mferreiracosta/tcc_cefet/TCC 1/Referências Bibliográficas/Características Componentes Eletrônicos/IMU6050.PNG

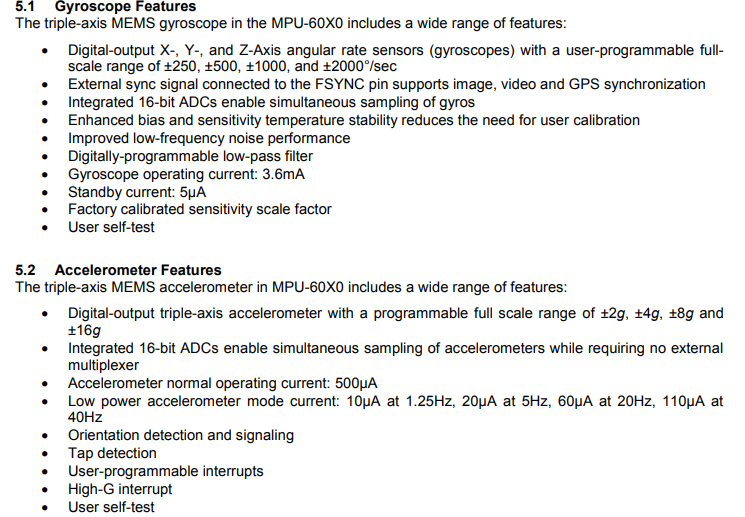
TCC 1/Referências Bibliográficas/Características Componentes Eletrônicos/IMU6050.PNG
