mferreiracosta/tcc_cefet/TCC 1/Referências Bibliográficas/Características Componentes Eletrônicos/Esquema_FiltroComplementar.jpg

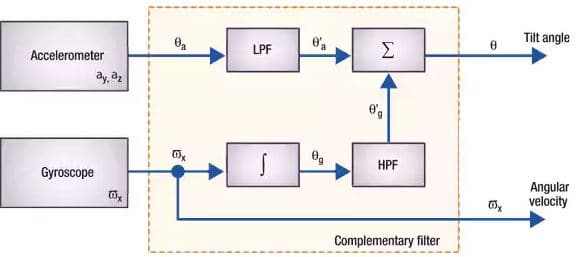
TCC 1/Referências Bibliográficas/Características Componentes Eletrônicos/Esquema_FiltroComplementar.jpg
