mferreiracosta/tcc_cefet/README.md

# Bem-vindo
 Repositório para arquivos do trabalho de conclusão de curso de Engenharia Mecatrônica pelo CEFET-MG.
