mferreiracosta/tcc_cefet/TCC 1/Slides de Apresentação.pdf

# Construção e controle de um sistema do tipo pêndulo invertido sobre duas rodas

Matheus Ferreira Costa

Orientador: Prof. Dr. Luís Filipe Pereira Silva Coorientador: Prof. Me. Juliano de Barros Veloso e Lima

Centro Federal de Educação Tecnológica de Minas Gerais campus Divinópolis
Graduação em Engenharia Mecatrônica

25 de Junho de 2019

Sumário

## Sumário

1 | Introdução
2 | Fundamentação Teórica
3 | Recursos Utilizados
4 | Controlador LQG
5 | Considerações Finais
6 | Referências Bibliográficas

Introdução

## Motivação

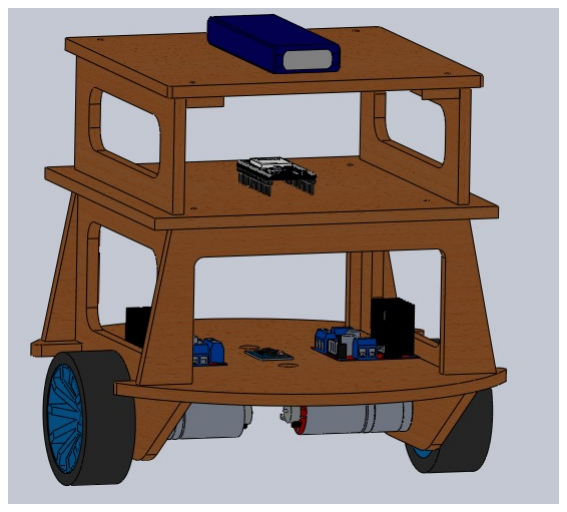
[picture p3: figure]

Figura: Estrutura modelada no SolidWorks.

Introdução

## Objetivos

Construir um sistema do tipo pêndulo invertido sobre duas rodas e controlar o mesmo para que fique em torno de 0◦ utilizando técnica de controle moderno.

Realizar o desenho do protótipo
Obter o modelo não linear contínuo do sistema Linearizar o modelo e realizar a discretização Projetar o controlador LQG
Analisar o desempenho do controlador Construção do protótipo
Implementação do controlador na planta física

Introdução

## Estado da Arte

Sistema de Controle de Pêndulo Invertido (PEDROSO; MODESTO, 2017)
Identificação e Controle de um Veículo Segway para fins Educacionais (MELO,2017)
Embedded LQR controller design for self-balancing robot (ENGIN, 2018)

Fundamentação Teórica

## Modelagem do Sistema

Modelagem newtoniana: F = mxÜ

Subsistema elétrico (PAULA, 2014)

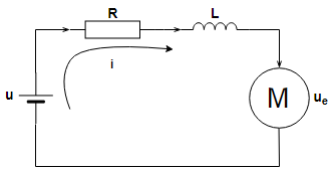
[picture p4: figure]

Figura: Representação elétrica dos motores.

T1 =

Km
R

u −

KeKm
R

(αÛw − θÛ
b)

Fundamentação Teórica

## Modelagem do Sistema

Equação de movimento das rodas (BONAFILIA et al, 2013)

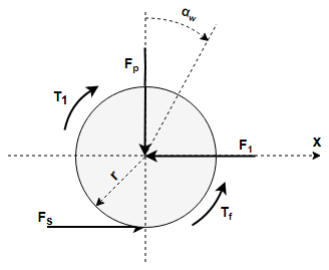
[picture p5: figure]

Figura: Diagrama corpo livre da roda.

F1 = −

Mw +

Jw
r

2

xÜw −
K
r

2R

xÛw +
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
Fundamentação Teórica

## Modelagem do Sistema

Equação de movimento da estrutura (BONAFILIA et al, 2013)

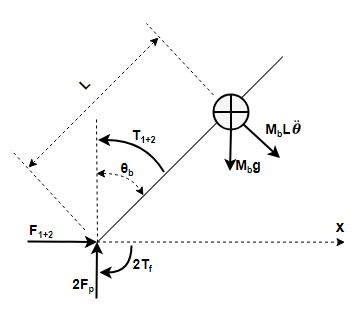
[picture p6: figure]

Figura: Diagrama corpo livre do chassi.

Fundamentação Teórica

## Modelagem do Sistema

EDO em relação a aceleração linear (xÜ)
2

Jw
r

2

+ 2Mw + Mb

xÜ = 2
b
r

2

−

K
r

2R

xÛ − (MbL cos(θ))θÜ

+ 2

K
rR

−

b
r
θÛ + 2

Km
rR

u

EDO em relação a aceleração angular (θÜ)

(Jb + MbL

2

)θÜ = −MbL cos (θ)xÜ + 2

K
rR

−

b
r
xÛ + 2
b −

K
R
θÛ

+ MbgL sin (θ) − 2

Km
R

u

Fundamentação Teórica

## Controlador Linear Gaussiano Quadrático (LQG)

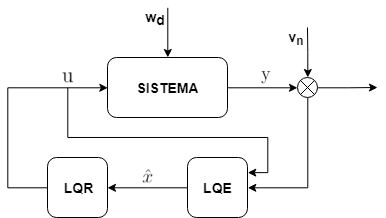
[picture p7: figure]

Figura: Estrutura de um controlador LQG (BRUNTON et al, 2017).

Fundamentação Teórica

## Controlador Linear Gaussiano Quadrático (LQG)

Regulador Linear Quadrático (LQR)
I Minimizar a função custo

J =

1
2

k

Õf−1

k=0

{x

T
k Qxk + u

T
k Ruk }

I Ganho ótimo K = (R + B
T
d PBd )

−1B
T
d PAd
I | Solução da equação de Riccati
| Pk+1 = Q + A TPkAd − A

T
d PkBd (R + B

T
d PkBd )

−1B
T
d PkAd

I Matlab [K, P, E] = dlqr(Ad, Bd, Q, R)

Fundamentação Teórica

## Controlador Linear Gaussiano Quadrático (LQG)

Estimador Linear Quadrático (LQE) / Filtro de Kalman

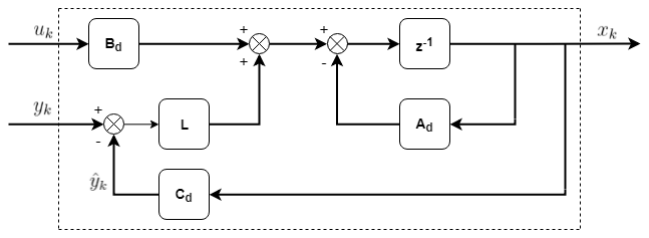
[picture p8: figure]

Figura: Estrutura do estimador LQE (BRUNTON et al, 2017).

Matlab
[L, S, Zd, Ed ] = dlqe(Ad, Qo, C, Qo, Ro);

Recursos Utilizados

## Softwares

SolidWorks
MATLAB
I Simulink

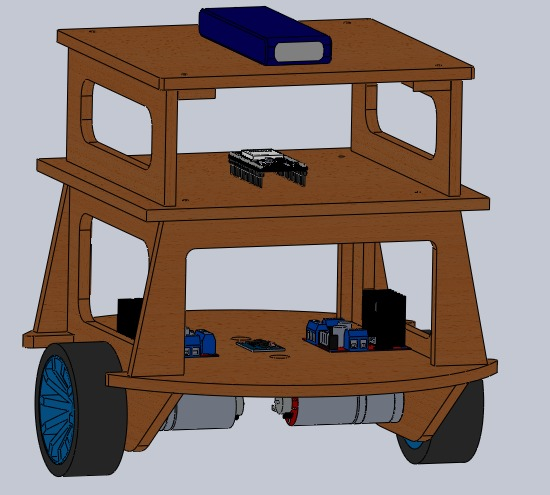
[picture p9: figure]

Figura: Estrutura modelada utilizando o SolidWorks.

Recursos Utilizados

## Motor CC

Características necessárias
I | Tensão: < 12V
I | Torque: 0.2446 Nm (15◦ )
Características do motor (datasheet)
I | Tensão de operação: 6 Vcc
I | Máx. eficiência: 0.196 Nm/0.60 A
I | Máx. torque: 0.51 Nm/1.10 A
I | Encoder integrado

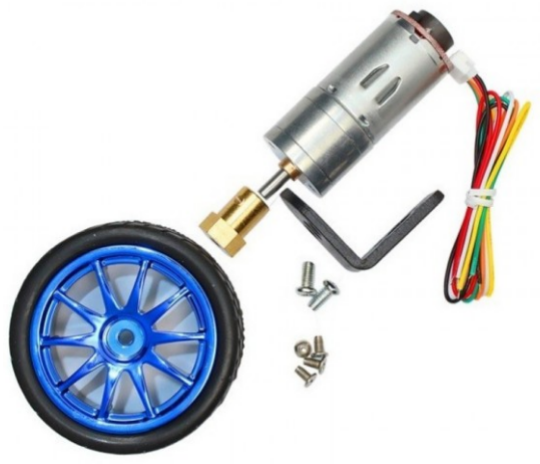
[picture p10: figure]

Figura: Conjunto completo do atuador: motor, acoplador e roda.

Recursos Utilizados

## Driver Motor CC

Características (datasheet)
I | Tensão: 4∼35 Vcc;
I | Corrente máx.: 2A p/canal ou 4A
| máx;
I | Tensão lógica: 5 V;
I | Corrente lógica: 0∼36 mA;

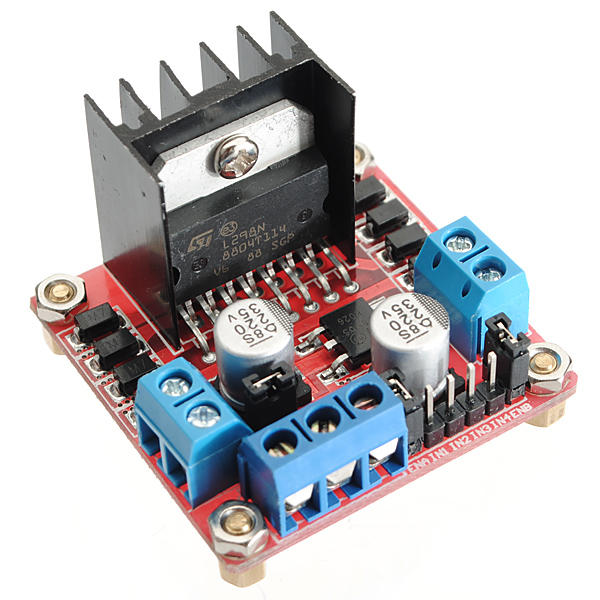
[picture p11: figure]

Figura: Ponte H L298N.

Recursos Utilizados

## Sensor de Orientação

Características necessárias
I | Tensão: 5Vcc
I | Resolução conversão alta
I | Tempo de acomodação menor
| possível
Características da placa (datasheet)
I | Tensão de operação: 3∼5 Vcc
I | Resolução: 16 bits
I | Tempo de acomodação: 1∼10 ms
| (máx.)

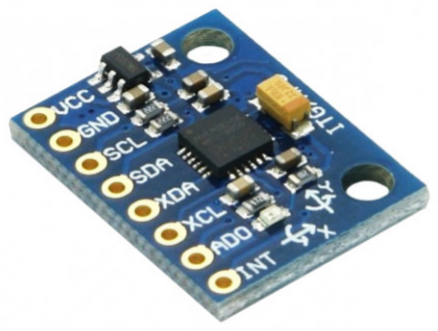
[picture p12: figure]

Figura: Shield MPU6050.

Recursos Utilizados

## Microcontrolador ESP32

Características necessárias
I | Baixo custo
I | Elevada velocidade de
| processamento
I | GPIOs correspondentes ao projeto
Características da placa (datasheet)
I | Tensão de operação: 3.3 Vcc
I | Microprocessador dual core 32-bit
I | Memória SRAM: 512 KB
I | Clock: 80MHz até 240MHz
I | Wi-Fi e Bluetooth embutido
I | GPIO: 36

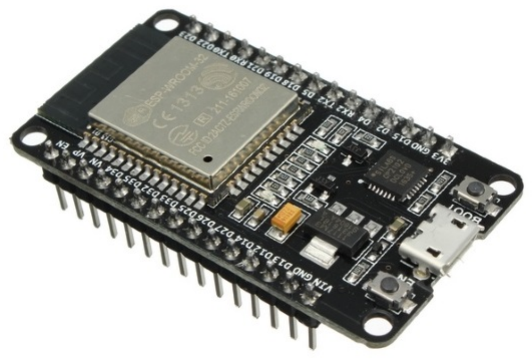
[picture p13: figure]

Figura: Microcontrolador ESP32.

Recursos Utilizados

## Bateria LiPO

Características necessárias
I | Tempo de operação: ∼ 1 hora
I | Capacidade de fornecimento de
| energia
Características via datasheet
I | Tensão de carga: 3 células / 11.1 Vcc
I | Carga Elétrica: 2200 mAh
I | Taxa de Descarga: 20-30 C
I | Massa: 180g

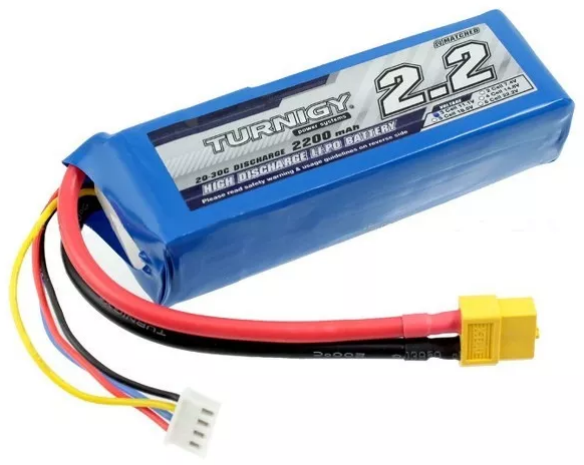
[picture p14: figure]

Figura: Bateria LiPO Turnigy 2200 mAh 3s.

Controlador LQG

## Modelo Linear Discreto

Estados
x1 = x x3 = θ
x2 = x x Û 4 = θÛ

Matrizes do Espaço de Estados I Período de Amostragem: 15 ms

Ad =

0.9918 −0.1503 0.0015
0.0007 | 1.0020 | 0.0148
0.0895 | 0.2694 | 0.9730

Bd =

0.0255
−0.0021
−0.2777

C =

0 1 0
D = 0

Controlador LQG

## LQR

Matrizes de ponderação Q e R → J =

1
2

Í
(x

T
k Qxk + u

T
k

Ruk )

Q =

1 0 0
0 1 0
0 0 1

R = 1

Implementação do controlador

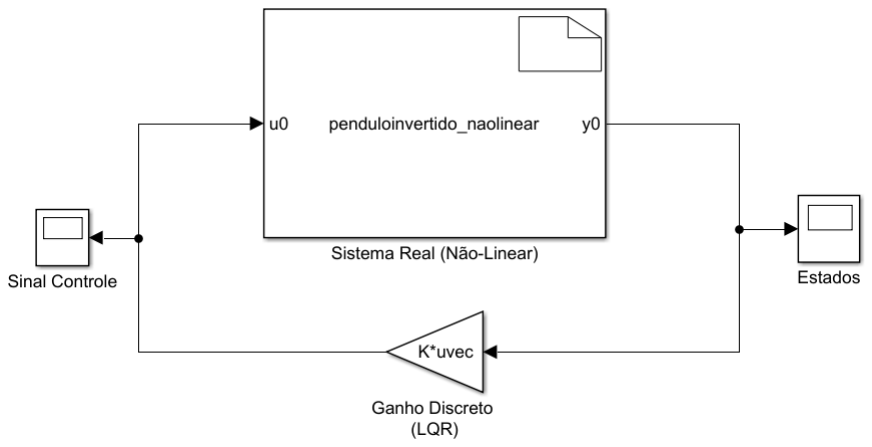
[picture p15: figure]

Figura: Implementação do controlador LQR.

Controlador LQG

## Resultados utilizando o LQR

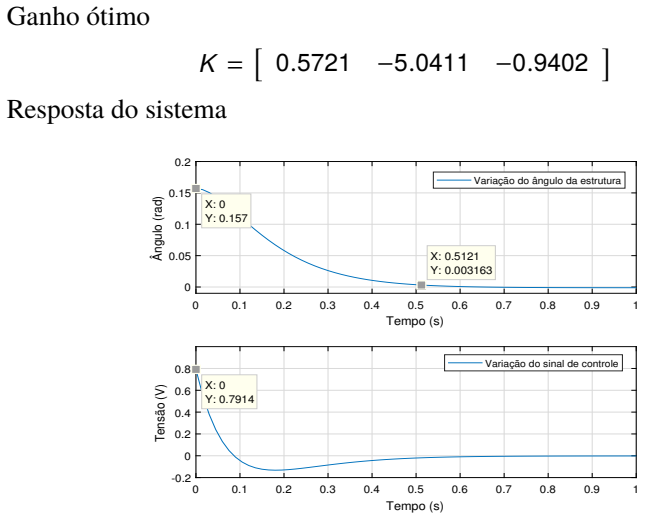
[picture p16: figure]
Ganho ótimo; Resposta do sistema; Tempo (s); Ângulo (rad); Variação do ângulo da estrutura; Tensão (V); Variação do sinal de controle

Figura: Variação do ângulo da estrutura com o controlador LQR. | 21 / 28

Controlador LQG

## LQG

Matrizes de ponderação

Qo = 0.1Inxn Ro = 1

Implementação do controlador LQG

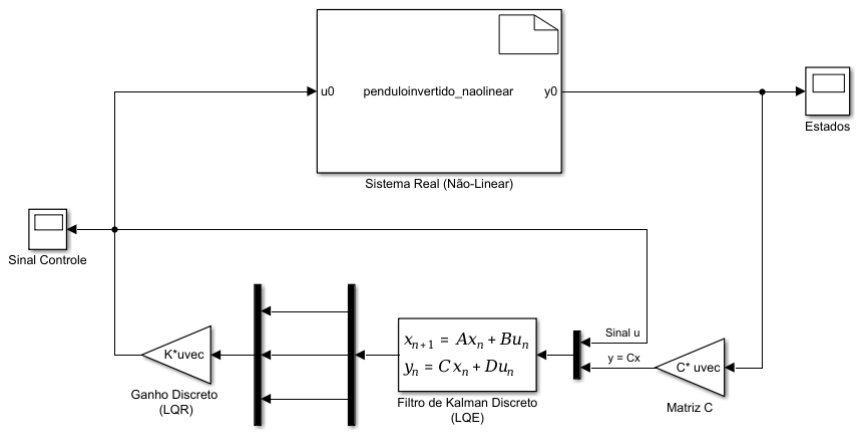
[picture p17: figure]

Figura: Implementação do controlador LQG.

Controlador LQG

## LQG

Ganho ótimo do estimador

L =

0.5721
−5.0411
−0.9402

Matrizes do LQE (BRUNTON et al, 2017)

Af =

Ad − LCd
Bf =
Bd L

Cf =

1 0 0
0 1 0
0 0 1

Df = 0

Bd L

## Resultados utilizando o LQG

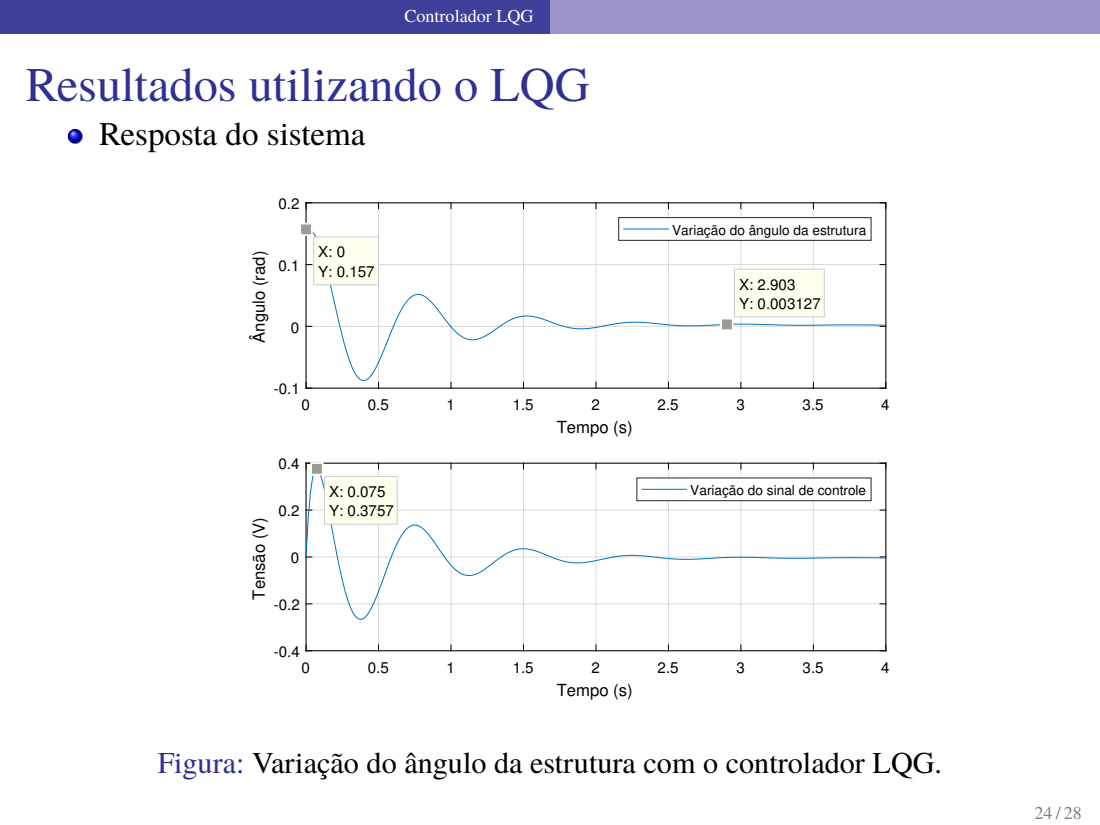
[picture p18: page 24]
Controlador LQG; Tempo (s); Ângulo (rad); Tensão (V)

Resposta do sistema

X: 0 | Variação do ângulo da estrutura

Variação do sinal de controle

Figura: Variação do ângulo da estrutura com o controlador LQG.

Considerações Finais

## Conclusão

Desenvolvimento do conceito do protótipo
Estudos com relação a técnicas de controle moderno Modelagem do sistema não linear contínuo no tempo Linearização e discretização do modelo não linear Projeto do controlador LQG
Análise de desempenho do controlador

Considerações Finais

## Cronograma

1 | Construção do Protótipo:
| 1.1 Compra dos materiais 1.2 Calibração dos componentes 1.3 Construção da planta física 1.4 Validação do modelo
2 | Aplicação dos Controladores:
| 2.1 Implementação 2.2 Validação dos controladores 2.3 Aplicação de melhorias ao projeto
3 | Relatório TCC2:
| 3.1 Escrita do relatório TCC2 3.2 Defesa do TCC2

Tabela: Cronograma de atividades.

Ativ. / Mês | Jul | Ago | Set | Out | Nov
1.1

√

1.2

√
1.3 | √ | √

1.4

√
2.1 | | | √ | √

2.2

√

2.3

√
3.1 | | √ | √ | √ | √

3.2

√

Referências Bibliográficas

## Referências

BRUNTON, S. L.; DURIEZ, T.; NOACK, B. R.
Machine Learning Control - Taming Non-linear Dynmics and Turbulence.
Springer International Publishing, 2017.

BONAFILIA, B. R.; GUSTAFSSON, N.; NYMAN, P.; NILSSON, S. N. Self-balancing two-wheeled robot.
Anais. . .[S.l.: s.n.], 2013.

ENGIN, M.
Embedded LQR controller design for self-balancing robo. Anais. . .IEEE, 2018. p.1-4.

Referências Bibliográficas

## Referências

MELO, J. V.
Identicação e Controle de um Veículo Segway para fins Educacionais. Porto Alegre, RS: SBAI, 1-6p, 2017.

PEDROSO, C. C. S.; MODESTO, E. L. P.
Sistema de Controle de Pêndulo Invertido.
Universidade Tecnológica Federal do Paraná UTFPR, Curitiba, PR, 2017.
