mferreiracosta/tcc_cefet/TCC 1/Desenvolvimento do Texto/2_Fundamentos/Fundamentação Teórica/FUNDAMENTAÇÃO_TCC_I_Pêndulo_Invertido_MatheusF.pdf

### Capítulo 1

# Fundamentos

Este capítulo trata-se da parte teórica deste trabalho, tal como a revisão de literatura

e fundamentação teórica. Na revisão de literatura será descrito a linha temporal deste

TCC. Na fundamentação teórica serão descritos de forma clara as teorias nas quais este

trabalho será emabasado, como por exemplo, técnicas de modelagem de sistemas e projeto

de controladores.

## 1.1 Revisão de Literatura

Pode-se afirmar que o primeiro trabalho significativo de controle foi o regulador cen-

trífugo construído por James Watt para o controle de velocidade de uma máquina de

tear, no século XVIII. O sistema permitia realizar o controle da velocidade, controlando

a injeção de combustível na máquina a vapor.
Segundo Katsuhiko (2010), trabalhos importantes como de Minorsky, Nyquist e Hazen,

datados entre as décadas de 20 e 30, contribuíram para o progresso da teoria de controle.

Minorsky, em 1922, trabalhou com pilotagem de embarcações utilizando controladores

automáticos e demonstrou por meio de equações diferenciais a estabilidade do sistema.

Em 1932, Nyquist desenvolveu um procedimento no qual determina a estabilidade de

sistemas em malha fechada com base na resposta em malha aberta. E Hazen, em 1934,

introduziu o termo servomecanismos para sistemas de controle de posição e analisou o

projeto de servomecanismos a relé.

No século XX, acontecimentos como a Segunda Guerra Mundial estimulou a pesquisa

em sistemas de controle. No final dos anos 50, a teoria de controle já era bastante conso-

lidada, sendo que o carro chefe eram métodos que utilizavam a resposta em frequência e

com muitas aplicações industriais, como por exemplo, a utilização de controladores PID

para o controle de pressão, temperatura, etc. Os métodos de resposta em frequência e

do lugar das raízes, os quais são a base da teoria clássica de controle, conduziram a sis-

temas que são estáveis e satisfatórios para um determinado conjunto de condições. Esses

1.1. Revisão de Literatura

sistemas são aceitáveis, porém não são ótimos no sentido literal do termo.
Entre as décadas de 60 e 80, segundo Katsuhiko (2010), o controle ótimo de sistemas

determinísticos, controle adaptativo e de aprendizagem foi altamente pesquisado. Dife-

rentemente da teoria clássica, esses métodos se enquadram na teoria de controle moderno.

Essa teoria se baseia no domínio do tempo em sistemas de equações diferenciais. Como

vantagem, temos que essa teoria simplificou o projeto de sistemas de controle já que se

baseia no modelo de um sistema controle real. Em contrapartida, a estabilidade é sensível

ao erro entre o sistema real e seu modelo. Dessa forma, quando o controlador projetado

for aplicado no sistema, o mesmo poderá ficar instável.

Um dos sistemas clássicos de controle que há na literatura, é o pêndulo invertido. Este

sistema possui uma única entrada e várias sáidas. Dessa maneira, tratá-lo com técnicas

de controle moderno tende a facilitar a estabilidade do mesmo.
Em Ooi (2003) a técnica utilizada para controle do pêndulo foi o LQR. Também

desenvolveu um controlador por alocação de pólos para a estabilização do sistema. Dessa

forma, foi capaz realizar a comparação entre esses dois métodos e saber qual dos dois foi

mais eficaz. Pelas simulações concluiu-se que os dois métodos atendeu, com ressalvas de

que o controlador LQR ofereceu uma maior confiabilidade.

A técnica PID Backstepping, que é não linear, foi utilizada por Thao; Nghia; Phucand (2010) para controlar um pêndulo invertido sobre duas rodas (PIDR). Essa técnica consiste

basicamente em uma estrutura de controle que possui três malhas de controle, sendo elas:
1) a malha principal, desenvolvida a partir da técnica não linear backstepping que manterá

o pêndulo em equilíbrio; 2) a segunda malha que utiliza um PD para controlar a posição

do robô e; 3) um controlador PI para o controle de movimentação.

Em Junfeng; Wanying (2011) novamente é feito uma comparação entre o controlador

ótimo LQR com o controlador por alocação de pólos. Contudo, neste artigo, conclui-se

que o overshoot foi menor por meio da técnica de alocação de pólos e que o tempo de

estabilização foi quase comparável ao do LQR.
No artigo de Juang; Lurrr (2013), os autores propuseram a desenvolver um protótipo

utilizando o Arduino como microcontrolador e a implementação de duas técnicas de con-

trole, sendo elas o PID e LQR na forma de PI-PD. Os resultados obtidos deixam bem

claro que a técnica PI-PD foi muito mais eficaz em todos sentidos do que a utilização pura

do PID. Como concluído, a estabilização por PID é marginal e as oscilações angulares ex-

cedem o limite máximo de torque que os motores podem oferecer. Já no PI-PD ou LQR,

a estabilidade é alcançada e ainda o controlador é capaz de compensar o desalinhamento

do CG, fazendo com que o robô retorne para a posição angular inicial e que é a desejada. Em Paula (2014), o autor utilizou duas técnicas de controle discreto, LQR com ação

integral e alocação de pólos. A primeira técnica utilizada teve como objetivo a estabiliza-

1.1. Revisão de Literatura

ção do pêndulo e a segunda o controle de velocidade dos motores. A técnica de alocação

de pólos além de realizar o controle dos motores, teve como objetivo interfaciar o controle

de ângulo e o sinal enviado para os motores.
Por úlimo, Alves (2018), além de projetar um controlador por meio do controlador

LQR, apresenta duas técnicas de linearização, sendo elas: a jacobina e a por realimentação.

A modelagem do sistema baseou-se na equação Lagrangeana e após encontrar as equações

de movimento, passou-se as mesmas para o Espaço de Estados. Os resultados obtidos

foram satisfatório, contudo, ao sofrer interferências, como distúrbio e ruídos o sistema

passa a ser mais oscilante.

Como dissertado acima, há vários trabalhos com diferentes resultados para o mesmo

tema. Isso reflete apenas que por se tratar de um sistema altamente instável e não linear,

faz com que sempre precise de novos estudos e novos testes. Ademais, quando se há

domínio de um determinado assunto, é possível transformar os resultados teóricos em um

produto e que será refletido de alguma forma na sociedade. Há vários estudos sobre o

pêndulo invetido, pois o funcionamento do mesmo está presente em diferentes aplicações práticas, desde um pouso/lançamento de um foguete até um veículo de transporte humano,

como o Segway.

O Segway, visto na Figura 1.1, inventado por Dean Karmen e revelado em dezembro

de 2001 tem o funcionamento idêntico ao do pêndulo invertido, com adição que o mesmo

está sobre duas rodas. A função básica deste veículo é o transporte de uma única pessoa.

O sistema entende que deve-se locomover para frente ou freiar, devido a inclinação que o

passageiro impõe sobre o veículo. Hoje em dia, existem vários modelos e cada um com

uma especificação diferente um do outro.

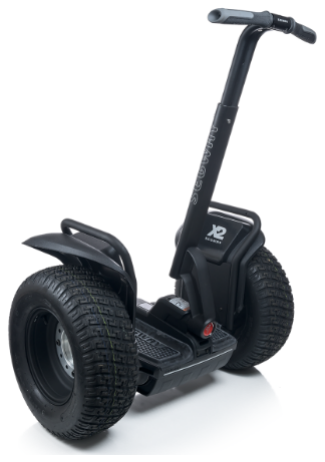
[picture p103: figure]

Figura 1.1: Segway X2 SE.
Fonte: Segway, 2019.

1.2. Modelagem do Sistema

## 1.2 Modelagem do Sistema

Nesta seção, além de apresentar a modelagem de um pêndulo invertido sobre duas

rodas, também será mostrado como é realizado a linearização de sistemas por meio da

série de Taylor e a transposição das equações de movimento para o espaço de estados.

### 1.2.1 Equações Dinâmicas dos Motores

Segundo Schiling (2017), o motor CC pode ser modelado através de um circuito elétrico

como visto na Figura 1.2.

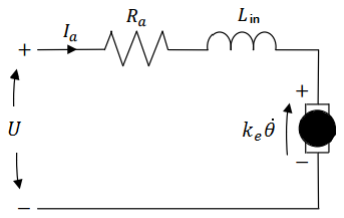
[picture p104: figure]

Figura 1.2: Representação elétrica dos motores. Fonte: Schiling (2017).

Aplicando a lei das tensões de Kirchoff, pode-se estabelecer uma relação entre as ten-

sões internas do circuito do motor CC considerando-se separadamente cada componente. Para o circuito da Figura (1.2), obtemos a seguinte equação.

U = RaIa + ke

˙θ + Lin

di
dt | (1.1)

O parâmetro U representa a tensão de controle aplicada no motor. Os parâmetros Ra e

Lin representam a resistência e a indutância dos enrolamentos do estator respectivamente.
A constante da força contra eletromotriz é dada por ke e | ˙θ representa a velocidade angular

do motor. Devido as condições de funcionamento do motor, como por exemplo, a constante

de tempo elétrica ser muito menor do que a mecânica, é possível ignorar a indutância Lin.

Sendo assim, simplica-se a Equação 1.1.

U = RaIa + ke

˙θ | (1.2)

O torque Tm produzido pelo motor é proporcional a corrente de enrolamento Ia, por

meio da constante de torque do motor kt

Tm = ktIa | (1.3)

Desta maneira, é preciso encontrar os valores das constantes de torque kt e força contra

eletromotriz ke. A primeira, pode ser obtida reajando a equação 1.3. Já a constantes ke

é obtida pela equação 1.5.

kt =

Tm
Ia

(1.4)

Ve = ke

˙θ | (1.5)

Em que Ve e

˙θ são a tensão da força contra eletromotriz e a velocidade angular do

motor. Pelo datasheet ou medindo a velocidade do motor com um tacômetro, é obtida a

mesma em rpm, dessa forma é preciso readequar a equação 1.5.

Ve = ke

2πn
60

(1.6)

Aplicando novamente a lei de Kirchoff no circuito da Figura 1.2 para encontrar a

tensão de armadura Ve, sendo Vn a tensão nominal do motor.

Ve = Vn − IaRa | (1.7)

Substituindo agora a equação 1.8 na equação 1.6 e rearranjando a mesma em termos

de ke, encontra-se a constante da força contra eletromotriz.

ke =

(Vn − IaRa)60
2πn

(1.8)

Como os motores serão controlados por PWM (Pulse Width Modulation), ou seja,

controle por meio da tensão em seus enrolamentos, a corrente Ia deve ser substituída da

equação 1.3. Uma equação que diz respeito a corrente Ia pode ser encontrada a partir da

equação 1.2, isolando a mesma.

Ia =

U − ke

˙θ

Ra

(1.9)

Dessa forma, com a equação 1.9 encontra-se uma equação que descreve o torque de

cada motor.

Tm =

nktU
Ra

−

nktke

˙θ

Ra

(1.10)

### 1.2.2 Equações Dinâmicas da Estrutura

A Figura 1.3 mostra o diagrama de corpo livre do pêndulo em função das forças

horizontais, perpendiculares e dos momentos atuantes na estrutura. O ângulo α, é a variável que deve ser controlada e mantida em 0◦
com a vertical.

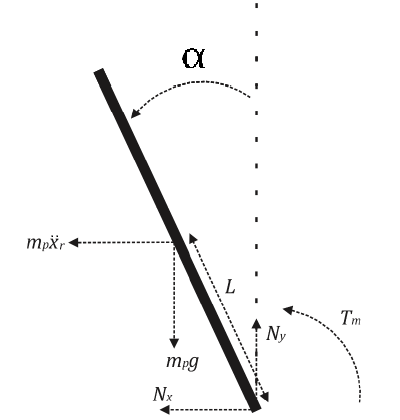
[picture p105: figure]

Figura 1.3: Diagrama corpo livre do chassi. Fonte: Schiling (2017).

As primeiras equações encontradas é a de momento, no sentido anti-horário, em torno

do centro de massa do pêndulo e das forças atuantes na estrutura, como visto na Figura

1.3.
Tm + mpgL sin α + mpx¨rL cos α = Jpα¨ | (1.11)
− Nx − mpx¨r = mpx¨p | (1.12)
Ny − mpg = mpy¨p | (1.13)

A equação 1.11 tem grande importância no sistema, já que a partir dela pode ser

obtido as equações de estado.

As acelerações ẍp e ÿp são obtidas a partir da derivada segunda das distâncias xp e yp

com relação ao centro de massa do pêndulo.

xp = −L sin α | (1.14)
yp = L cos α | (1.15)

A segunda derivada para as equações 1.14 e 1.15 são vistas em

x¨p = −Lα¨ cos α + Lα˙

2
sin α | (1.16)

y¨p = −Lα¨ sin α − Lα˙

2
cos α | (1.17)

### 1.2.3 Equações Dinâmicas das Rodas

A roda gira sob a influência do torque de um motor CC. O sistema se movimenta na

direção x devido ao contato com o chão que gera uma força de reação F. O diagrama de

corpo livre da roda é mostrado na Figura 1.4.

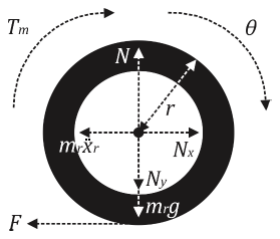
[picture p106: figure]

Figura 1.4: Diagrama corpo livre da roda. Fonte: Schiling (2017).

As equações 1.18, 1.19 e 1.20 são de momento no sentido horário em torno do centro

de massa da roda, e das forças atuando nos eixos x e y, respectivamente.

Tm − F r = Jr

¨θ | (1.18)
Nx − mrx¨r − F = 0 | (1.19)
N − Ny − mrg = mry¨r | (1.20)

Como a aceleração ẍr está na forma padrão, cartesiana, a mesma pode ser convertida

para um sistema de coordenadas cilíndrica e a aceleração no sentido do eixo y deve ser

nula.
x¨r = ¨θr | (1.21)

Por fim, o momento de inércia da roda pode ser calculado através da mecânica clássica,

aproximando a mesma por um círculo.

Jr =

mrr

2
2 | (1.22)

### 1.2.4 Equações de Movimento do Sistema

Com a equação de momento 1.11 do pêndulo, é possível encontrar a equação não linear

para a aceleração angular ¨α.

Tm + mpgL sin α + mpx¨rL cos α = Jpα¨

Dessa maneira, se faz necessário encontrar a equação para a variável de aceleração ẍr,

para daí isolar a variável de interesse ¨α das demais variáveis. Com as equações 1.12 e 1.19

é possível determinar a equação de ẍr.

−Nx − mpx¨r = mpx¨p

Nx − mrx¨r − F = 0

Rearranjando a equação 1.12 em termos da variável Nx e substituindo em 1.19, pode-se

isolar ẍr, encontrando assim a equação da mesma.

x¨r =

mpx¨p + F
(−mp − mr)

(1.23)

Na equação 1.23 se faz necessário conhecer o parâmetro F. Dessa forma, utilizou-se a equação 1.18 para determinar F. A variável da aceleração angular ¨θ pode substituída,

como visto na equação 1.21. Sendo assim, é possível substituir essas variáveis em 1.23.

x¨r =

mpx¨pr

2 − Tmr
r

2

# (−mp − mr) − Jr

(1.24)

Por último, substitui na equação 1.11 as equações 1.16 e 1.24. Reajeitando e simplifi-

cando matematicamente os termos da equação, encontra-se um nova que contenha apenas

termos com α e suas derivadas:

α¨ =

Tm(Z + mprL cos α) + mpgL sin αZ − m²
p

r

2L

2α˙

2
sin α cos α
JpZ − m²
p

r

2L² cos² α

(1.25)

em que,

Z = r

2
(mp + mr) + Jr

Percebe-se que a equação 1.25 está em termos de do torque do motor Tm. Dessa

forma, essa variável será substituída pela sua equivalente vista na equação 1.10. Assim, é

necessário apenas realizar algumas manipulações algébricas para chegar em uma equação

não linear para a aceleração angular do pêndulo em termos da tensão elétrica que se aplica

no motor CC. Essa equação pode ser vista em 1.26.

α¨ =

(Z + mprL cos α)2kt(U − ke

˙θ) + mpgRaLZ sin α

Ra(JpZ − m²
p

r

2L² cos² α)

(1.26)

Para encontrar a equação da aceleração que diz respeito a roda ¨θ, os passos seguidos

foram parecidos com os quais encontraram a equação de ¨α. Dessa forma, a equação para a aceleração angular da roda ¨θ é vista em 1.26.

¨θ =

Lrmp cos α[gLRamp sin α + 2kt(U − ke

˙θ)] + Jp2kt(U − ke
˙θ)

Ra(JpZ − m²
p

r

2L² cos² α)

(1.27)

### 1.2.5 Linearização em torno de um Ponto de Equilíbrio

Segundo Katsuhiko (2010), um sistema pode estar operando com funcionamento nor-

mal em torno de um ponto de equilíbrio, e os sinais envolvidos podem ser considerados

pequenos em torno deste ponto. Assim, se o sistema opera em torno deste ponto e os sinais

envolvidos são pequenos, é possível aproximar uma equação não linear por um sistema

linear. Este sistema novo, linearizado, é equivalente ao sistema não linear considerado

dentro de um conjunto de operações determinadas.

O caso mais comum de se realizar uma linearização é com a expansão em série de Taylor

em torno do ponto de operação. Para realizar este tipo de linearização, desconsidera

os termos de ordem maiores da série. Dessa forma, é preciso que estes termos sejam

suficientemente pequenos.

Aproximação linear genérica de sistemas não lineares

Katsuhiko (2010), aproxima um modelo não linear em um linear, admitindo que as

variáveis desviem ligeiramente de alguma condição de operação. Considerando um sistema genérico, no qual a entrada é x(t) e a saída é y(t), temos que:

y(t) = f(x) | (1.28)

Caso a condição de operação normal corresponda a (x

eq
, y
| eq), então a equação 1.28

pode ser expandida na série de Taylor em torno desse ponto:

y = f(x) = f(x

eq) + df
dx(x − x

eq) + 1
2!

d

2
f
dx²

(x − x

eq)

2 + ... | (1.29)

sendo que as derivadas df/dx, d

2

f/dx²
, ... são avalidas em torno do ponto de operação. Se a variação de x−x

eq for pequena, despreza-se os termos de ordem mais elevadas. Dessa

forma, a equação 1.29 pode ser reescrita da seguinte forma:

y = y

eq + K(x − x

eq) | (1.30)

sendo que,

y

eq = f(x

eq)

K =

df
dx |x=xeq

Reescrevendo a equação 1.30, conclui-se que y − y

eq é proporcional a x − x | eq, como

segue:

y − y

eq = K(x − x

eq) | (1.31)

A Equação 1.31 fornece um modelo linear para um sistema matemático não linear dado pela Equação 1.28, próximo do ponto de operação (x

eq,yeq), segundo Katsuhiko (2010).

Aproximação Linear das Equações de Movimento do Sistema

As equações de movimento não lineares que rejem o sistema, 1.26 e 1.27, serão linea-

rizadas com o intuito de obter um modelo linear e assim, utilizar as técnicas de controle

linear. Dessa maneira, deve-se apenas a atentar a fidelidade entre o sistema real, não

linear, e o modelo linearizado.
A premissa principal é de que o pêndulo fique sempre em 0◦
, com um pequena variação em torno deste ponto. Dessa forma, o ponto de operação será próximo a 0◦

Assim sendo, utilizando a Equação 1.31 em termos da variável α e tomando o ponto

de equilíbrio como sendo x

eq = 0◦
, temos que os termos não lineares ficam sendo:

sin α = α

cos α = 0

α˙

2 = 0

Substituindo esses termos linearizados nadas equações 1.26 e 1.27, encontra-se as equa-

ções de movimento lineares para o sistema do pêndulo invertido sobre duas rodas. Essas

Equações podem ser vistas em 1.32 e 1.33.

α¨LIN =

(Z + mprL)2kt(U − ke

˙θ) + RampLαgZ

Ra(JpZ − m²
p

r

2L²
)

(1.32)

¨θLIN =

Lrmp[gLRampα + 2kt(U − ke

˙θ)] + Jp2kt(U − ke

˙θ)

Ra(JpZ − m²
p

r

2L²
)

(1.33)

### 1.2.6 Modelagem no Espaço de Estados

# Referências

Alves, R. G. Controle de um pêndulo invetido utilizando técnica de linearização por rea-

liamentação. Ouro Preto, MG, 2018.

Juang, H.; Lurrr, K. Design and control of a two-wheel self-balancing robot using the ar-

duino microcontroller board. In: IEEE INTERNATIONAL CONFERENCE ON CON-TROL AND AUTOMATION (ICCA), 2013. Anais. . . [S.l.: s.n.], 2013. p.634–639.

Junfeng, W.; Wanying, Z. Research on Control Method of Two-wheeled Self-balancing

Robot. In: FOURTH INTERNATIONAL CONFERENCE ON INTELLIGENT COM-PUTATION TECHNOLOGY AND AUTOMATION, 2011. Anais. . . [S.l.: s.n.], 2011.

v.1, p.476–479.

Katsuhiko, O. Engenharia de Controle Moderno. 5. ed..ed. São Paulo: Pearson Prentice

Hall, 2010.

Ooi, R. C. Balancing a Two-Wheeled Autonomous Robot. Western Australia, 2003.

Paula, A. R. de. Modelagem e controle do pêndulo invertido sobre duas rodas. Fortaleza,

CE, 2014.

Schiling, D. E. Modelagem e Controle de um Robô de Eixo Unico em Sistema de Pêndulo ´

Invertido. Ijuí, RS, 2017.

Thao, N. G. M.; Nghia, D. H.; Phucand, N. H. A PID backstepping controller for two-

wheeled self-balancing robot. In: INTERNATIONAL FORUM ON STRATEGIC TE-CHNOLOGY 2010. Anais. . . [S.l.: s.n.], 2010. p.76–81.
