mferreiracosta/tcc_cefet/Referências Bibliográficas/JoseLima_RelatorioFinal.pdf

### José Lima Luz Netto

Faculdade de Engenharia Mecânica Universidade Estadual de Campinas jose.limaluz@gmail.com

# Relatório Final

### EM919 - Trabalho de Graduação II

Implementação prática do controle multiobjetivo H2 em um pêndulo invertido através de rede de comunicação

### 27 de Novembro de 2016

Universidade Estadual de Campinas Campus Universitário Zeferino Vaz, Barão Geraldo, Campinas - SP, 13083-970

Orientadora:
Profa. Dra. Grace S. Deaecto grace@fem.unicamp.br

### Sumário

1 Introdução | 1
2 Modelagem e Identificação | 4
3 Controle Multiobjetivo Através da Rede | 22
4 Perspectivas futuras | 34
5 Conclusão | 35

### Resumo

Este projeto de pesquisa trata da síntese e implementação prática do controle com comutação em um pêndulo invertido acoplado a um carro que desliza sobre um trilho. Mais especificamente, o objetivo é fazer com que o pêndulo permaneça em equilíbrio na posição vertical para cima, a partir de uma força aplicada no carro, que por sua vez deve voltar para a origem. São definidos múltiplos critérios H2 diferentes e conflitantes, de forma que o controle com comutação deve garantir estabilidade e um desempenho melhor do que aquele fornecido por cada critério isolado. Inicialmente, este texto descreve a planta do fabricante Quanser e desenvolve por completo o modelo do sistema. É realizada então a análise da resposta no tempo utilizando parâmetros fornecidos pelo fabricante, na qual são observadas certas discrepâncias entre os dados medidos e simulados, que justificam a necessidade de um modelo mais preciso. Neste ponto, são aplicadas técnicas simples para identificação do sistema geral, que resultam em respostas satisfatórias graças a uma melhor estimativa dos parâmetros físicos. Com um modelo adequado, a segunda etapa é dedicada ao projeto do controle multiobjetivo com comutação via realimentação de estado. Mais precisamente, são projetados um conjunto de controladores e uma regra de comutação, de forma a assegurar estabilidade e um limitante superior mínimo para um certo índice de desempenho H2 a ser definido. Além disso, o projeto é realizado levando em conta que o controle é aplicado através de uma rede de comunicação com largura de faixa limitada.

### 1 Introdução

Sistemas dinâmicos com comutação são aqueles definidos por um número finito de subsistemas e uma regra de comutação, que seleciona a cada instante de tempo um deles. Esta regra pode ser arbitrária, exercendo o papel de uma perturbação externa, ou uma variável de controle que, quando adequadamente projetada, pode assegurar estabilidade e melhorar o desempenho do sistema global. Nosso interesse é estudar o segundo caso, no qual a regra é uma variável de controle a ser determinada. As referências [7], [15], [22]

1

e os livros [17] e [25] são importantes para iniciar o estudo do tema.
O objetivo principal deste projeto de pesquisa é a aplicação e implementação prática de resultados recentes sobre sistemas com comutação no controle da estação de trabalho IP02 da Quanser, que foi recentemente adquirida, e que consiste em um pêndulo invertido acoplado a um carro que desliza sobre um trilho, [20].
Trata-se de um sistema não-linear muito utilizado em livros didáticos de graduação e pós-graduação para ilustrar aspectos importantes sobre teoria de controle de sistemas dinâmicos. Além disso, ele apresenta características interessantes que podem ser claramente observadas, por exemplo, no diciclo segway, que é um sistema de transporte muito utilizado atualmente para turismo e para esquemas de segurança no mundo todo. Devido à sua importância, o modelo do pêndulo invertido já foi utilizado em dois trabalhos de graduação do nosso grupo de pesquisa, veja [3] e [21] para o caso H2 e H∞, respectivamente. Nestes trabalhos fica evidente que o controle com comutação melhora o desempenho H2 e H∞ do sistema global quando comparado ao desempenho obtido através de técnicas clássicas de controle de sistemas lineares e invariantes no tempo. Entretanto, a sua implementação prática, visando enfatizar a validação de técnicas de controle com comutação, ainda não foi realizada. Neste caso, limitações físicas de sinais, tais como, valor máximo de esforço de controle e frequência máxima de comutação passam a ser uma preocupação do projetista durante a realização do projeto. Neste sentido, os resultados aqui apresentados levam em conta um limitante superior para a frequência de comutação, que não foi considerado nos trabalhos anteriores. Isto permite que o controle do pêndulo seja realizado por intermédio de uma rede de comutação com largura de faixa limitada. A introdução do uso de redes de comunicação deixa o problema ainda mais abrangente e com maior interesse prático, uma vez que grandes áreas da engenharia estão sendo integradas a um ambiente conectado através de rede. Algumas propriedades, como por exemplo, a largura de faixa limitada são importantes em aplicações práticas de sistemas com comutação uma vez que, em plantas reais, a frequência de comutação é normalmente limitada. A referência [16] apresenta uma introdução sobre conceitos importantes de redes de comunicação aplicados a projetos de controle. Assim, este trabalho está organizado

2

da seguinte forma:

- Modelagem física do sistema mecânico: a modelagem será desenvolvida considerando a metodologia clássica, por meio do levantamento das equações diferenciais, que descrevem o movimento do sistema geral. Assim, obtém-se a representação de estado do sistema de forma simples e com máxima precisão.
- Identificação do sistema e validação do modelo: esta parte do texto é dedicada ao confronto entre o sistema físico real e o modelo desenvolvido na seção anterior. Esta etapa será realizada através da coleta experimental de dados e simulação do modelo matemático cujos parâmetros físicos são obtidos a partir de métodos simples de identificação.
- Controle através de rede de comunicação: nesta etapa será apresentada a teoria utilizada para aplicação do controle multiobjetivo, suas vantagens e limitações. São exibidos os resultados pertinentes à teoria de sistemas com dados amostrados. Por fim, os resultados do controle multiobjetivo são aplicados no pêndulo em estudo e comparados aos controladores clássicos da literatura desenvolvidos para sistemas lineares e invariantes no tempo.

Este trabalho de pesquisa representa uma parte importante da minha dissertação de mestrado, que será viabilizada graças ao programa PICC (Programa de Incentivo a Capacitação Científica) da FEM/UNICAMP. Todos os resultados aqui apresentados serão generalizados para tratar do controle cooperativo de vários pêndulos que devem compartilhar a mesma rede de comunicação. Em um mundo conectado pela internet, a realização do controle à distância contribuirá diretamente para revolução tecnológica denominada IoT (do inglês Internet of Things) que atualmente tem atraído muitos investimentos em pesquisa. Neste caso, o controle deve levar em conta a existência de um coordenador (regra de comutação), que escolherá a cada instante de tempo qual planta deve receber o sinal de controle atualizado, enquanto que as demais manterão a última informação recebida. A estratégia proposta será implementada utilizando pêndulos invertidos disponíveis na FEM/UNICAMP.

3

### 2 Modelagem e Identificação

Neste capítulo, nosso objetivo principal é a modelagem do sistema mecânico que consiste em um pêndulo invertido acoplado a um carro que desliza sobre um trilho. A Figura 1 apresenta o sistema a ser modelado. Nesta etapa, devemos obter um conjunto de equações diferenciais, que descreve o comportamento dinâmico do pêndulo, tendo como meta a simplicidade das relações matemáticas e, ao mesmo, tempo máxima precisão, de forma que os resultados sejam bastante próximos da dinâmica real.
O pêndulo invertido é um sistema instável, e o objetivo principal do controle é a implementação de uma força adequada a fim de mantê-lo na posição vertical para cima. Este esquema de controle é objeto básico de estudo e aplicação para casos reais, como no lançamento de um foguete e o controle de pontes rolantes industriais, [19]. Fomenta, assim, ainda mais o interesse sobre aplicação de técnicas mais avançadas de controle, buscando sempre a obtenção de um melhor desempenho.
O equipamento utilizado consiste em um carro atuado por um motor de corrente contínua, no qual sua montagem permite apenas a translação sobre um trilho horizontal, onde é acoplado um pêndulo com eixo de rotação perpendicular ao movimento do carro. Será utilizado o modelo IP02 do fabricante Quanser, mostrado na Figura 1.

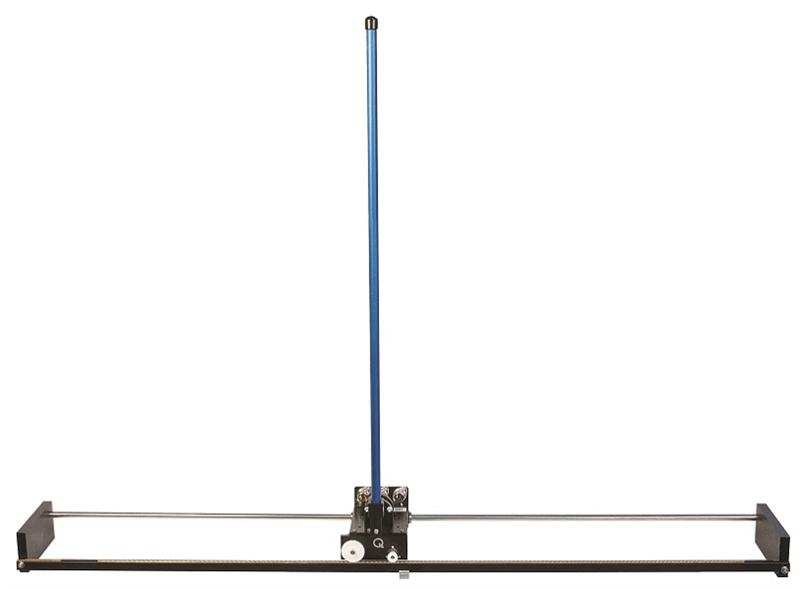
[picture p109: figure]

Figura 1: Pêndulo Invertido - IP02, retirado de [20]

4

### 2.1 Descrição do sistema

O modelo IP02 do fabricante Quanser é composto por um sólido carro de alumínio movido por um motor de corrente contínua de baixa indutância. A transmissão de potência entre o motor e o carro ocorre através de uma caixa de transmissão, composta por um conjunto de engrenagens em montagem planetária e pinhão-cremalheira, veja a Figura 2. A montagem planetária é do tipo onde todos os esforços normais podem ser compensados internamente, possuindo, em geral, alta eficiência mesmo se utilizada apenas como redutor [8]. O conjunto pinhão-cremalheira permite a transformação de um movimento rotativo para linear nos trilhos.
Com a energia recebida do conjunto motor / caixa de transmissão, o carro movimenta o pêndulo de haste cilíndrica através do ponto de pivoteamento proporcionando, assim, um movimento livre de até 360o

. A seguir, apresentamos a modelagem matemática do sistema.

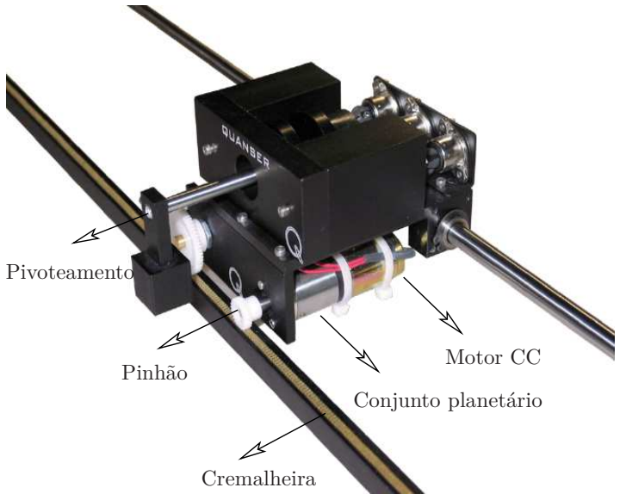
[picture p110: figure]
Conjunto planetário; Pinhão; Cremalheira; Motor CC; Pivoteamento

Figura 2: Sistema IP02, retirado de Quanser, User Manual 2012

5

### 2.2 Equacionamento

A metodologia utilizada para obtenção das equações de movimento tem como base as leis que regem a dinâmica de corpos sólidos, para o caso do carro, e as leis de Kirchhoff, para o motor. A Figura 3 mostra as variáveis de interesse e as constantes do sistema carro-pêndulo, com suas respectivas referências adotadas no modelo.

Vm

Rm

Im
θm

Lm

Fc
Kg

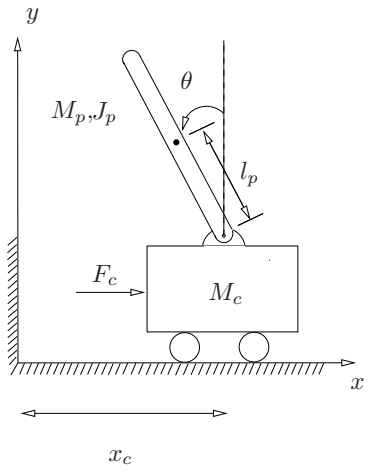
[picture p111: figure]

Figura 3: Diagrama do conjunto carro-pêndulo

### 2.2.1 Motor/caixa de transmissão

Do lado esquerdo da Figura 3, apresentamos o diagrama do motor com momento de inércia Jm, em que Vm é a tensão de entrada, Im é a corrente, Rm a resistência de armadura, Lm a indutância do motor e km a constante de força contra-eletromotriz. Aplicando a Lei de Kirchhoff no circuito da Figura 3, obtemos

Vm − Rm Im(t) − Lm

˙Im(t) − km

˙θm = 0 | (1)

em que θm é o ângulo de rotação do motor e km

˙θm é a força contra-eletromotriz. Consi-

derando que a indutância do motor é desprezível, ou seja Lm ≈ 0, tem-se que a corrente elétrica é dada por:

Im =

Vm − km

˙θm

Rm

| (2)

6

Por outro lado, temos que o torque gerado pelo motor, que será transferido à carga, é proporcional à corrente Im da seguinte forma:

τm = ηmktIm | (3)

em que ηm é a eficiência do motor e kt é a constante de proporcionalidade corrente-torque. Após alterado pela caixa de transmissão, com constante de redução kg e eficiência ηg, o torque é responsável por aplicar a força

Fc =

ηgkgτm

rpm

(4)

no carro de massa Mc, como pode ser visto no lado direito da figura. As equações (1)-
(4) descrevem a dinâmica do sistema motor/caixa de transmissão. Estas equações, em conjunto com a transformação de movimento no mecanismo pinhão-cremalheira, dado por

˙θm =

kgx˙ c

rpm

(5)

permitem a obtenção da força aplicada no carro em função da entrada de tensão Vm e da velocidade ˙xc, do tipo:

Fc =

ηg kg kt ηm

rpm Rm

Vm(t) −

km kg

rpm

x˙ c(t)

!
(6)

É digno de nota que Fc é um parâmetro importante no estudo do sistema da Figura 1, pois é o elemento que relaciona a dinâmica do conjunto carro/pêndulo com o movimento do motor.

### 2.2.2 Carro

Como pode ser observado no lado direito da Figura 3, o carro movimenta um pêndulo de massa Mp e está imerso em um meio responsável por um atrito viscoso de constantes Bc e Bp no carro e no pêndulo, respectivamente. Os referenciais adotados

7

estão apresentados na figura. Aplicando o princípio de D’Alembert, a equação dinâmica do carro na horizontal é dada por:

Mc x¨c + Fa + Tx + Bc x˙ c = Fc | (7)

na qual Tx é a força causada pela haste do pêndulo. A força inercial da armadura Fa ocorre
devido à ação de rotação do motor com torque de inércia τm = Jm | ¨θm = Jm(kgx¨c/rpm),

sendo expressa na forma:

Fa =

ηg kg τm

rpm

=

ηg k

2

g Jmx¨c
r

2
pm

(8)

Utilizando (6) e (8), obtemos que a equação do carro (7) torna-se

Meqx¨c + Beqx˙ c + Tx = AeqVm | (9)

em que a massa equivalente assume a forma:

Meq = Mc +

ηgk

2
gJm
r

2
pm

(10)

o coeficiente de atrito viscoso equivalente:

Beq = Bc +

ηgηmk

2
gktkm
r

2
pmRm

(11)

e, finalmente, o ganho de atuação:

Aeq =

ηgηmkgkt

rpmRm

(12)

### 2.2.3 Pêndulo

O pêndulo possui momento de inércia Jp em relação ao seu centro de gravidade, que está localizado a uma distância lp do ponto de pivoteamento. O movimento de translação é da forma

Mp

d

2
dt²
(xc − lp sen(θ)) − Tx = 0 | (13)

8

Adicionalmente, o movimento de rotação é descrito por:

(Jp + Mp l

2
p

)

¨θ − Mp lp cos(θ) ¨xc − Mp g lp sen(θ) + Bp

˙θ = 0 | (14)

A seguir, vamos acoplar as equações obtidas até então para encontrar aquelas que descrevem o conjunto carro/pêndulo.

### 2.2.4 Equações não lineares do sistema

Eliminando-se a força Tx a partir das equações (9) e (13), verificamos que as equações diferenciais não lineares, que descrevem o comportamento do carro xc(t) e o deslocamento angular do pêndulo θ(t) para todo t ≥ 0, podem ser resumidas à:

(Mp + Meq) ¨xc + Beq x˙ c − Mp lp cos(θ)

¨θ + Mp lp sen(θ)

˙θ
2 = Aeq Vm (15)

(Mp l

2
p + Jp)

¨θ + Bp

˙θ − Mp lp cos(θ) ¨xc − Mp lp g sen(θ) = 0 | (16)

Desse modo, as equações (15)-(16) representam completamente o sistema dinâmico de interesse, o pêndulo IP02 Quanser.
As próximas etapas tratam da manipulação e análise de suas características.

### 2.3 Linearização

A linearização é tópico importante para o projeto do controlador, tanto no cálculo propriamente dito, quanto na análise da abrangência de um equacionamento mais simplista. Além disso, como ficará claro em seguida, o modelo linear é utilizado para identificação dos parâmetros físicos, visto que estes valores podem diferir daqueles fornecidos pelo fabricante devido ao desgaste dos trilhos, perdas de eficiência, entre outros. Desenvolvendo as equações (15)-(16) em série de Taylor até a primeira ordem e considerando a origem (x0, θ0) = (0, 0) como ponto de operação, tem-se:

(Mp + Meq) ¨xc + Beq x˙c − Mp lp

¨θ = Aeq Vm | (17)

9

(Mp l

2
p + Jp)

¨θ + Bp

˙θ − Mp g lp θ − Mp lp x¨c = 0 | (18)

As Equações (17)-(18) representam a dinâmica do sistema pêndulo invertido linearizado em relação à origem.

### 2.4 Representação de estado

A partir das Equações (15)-(16) e (17)-(18), que descrevem a dinâmica do sistema oriundas das subseções anteriores, é possível encontrar a representação em espaço de estado do conjunto. Elas são definidas conforme abaixo:

P :

x˙ = A x + B u

y = C x + D u

Onde x é o vetor de estado e u é a entrada de controle. No caso do pêndulo, temos que

x = [xc θ x˙ c

˙θ]
′ ∈ R

4

em que xi representa a i-ésima componente do vetor x e u = Vm.

### 2.4.1 Caso linear

Feitas as considerações iniciais, basta substituir as variáveis de estado nas equações dinâmicas e obter as matrizes A e B. Após certo algebrismo, tem-se:

A =

1
JT
0 | 0 | JT | 0
0 | 0 | 0 | JT

### 0 M²

| p l

2
p
g | − Beq (Mp l
2
| p + Jp) | − Bp Mp lp
0 Mp lp g (Meq + Mp) | − Beq Mp lp | − Bp (Meq + Mp)

(19)

B =

Aeq
JT

0
0

Mp l

2

p + Jp

Mp lp

(20)

com JT = Meq (Mp l
2

p + Jp) + Jp Mp. As matrizes C e D representam a saída do sistema mecânico que, no modelo Quaser IP02, é medido por encoders nas variáveis de posição.

10

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

que explicita A = −Φ

−1 Γ, B = Φ⁻¹ Ψ e E = −Φ

−1 Ω. Portanto, os resultados são mostrados abaixo:

A =

1

JT n

0 0 | JT n | 0
0 0 | 0 | JT n

0 0 −Beq (Mp l

2
| | p + Jp) −Bp Mplp cos(x2) − Mplp x4 sen (x2) (Mpl

2
p + Jp)
0 0 −BeqMplp cos(x2) | −Bp(Meq + Mp) − M²
| | p l

2
p

cos(x2) sen(x2) x4

(26)

e

B =

Aeq

JT n

0
0

Mpl

2

p + Jp
Mplp cos(x2)

, E =

1

JT n

0
0

M²
p

l

2
p

g sen(x2) cos(x2)
Mp lp g sen(x2)(Mp + Meq)

(27)

onde JT n = −M²
p

l

2
p

(cos (x2))² + (Mp +Meq)(Mp l
2

p +Jp). As matrizes A e B, juntamente com E, concluem a modelagem do sistema pêndulo invertido em modelo de estado não linear.

### 2.5 Validação do modelo

A validação pode ser realizada através da comparação entre a resposta medida do sistema físico e a simulada, utilizando o modelo matemático. A Tabela 1 mostra os parâmetros fornecidos pelo fabricante Quanser, bem como suas respectivas unidades. Para viabilizar esta etapa, deslocamos o conjunto carro/pêndulo para um novo ponto de

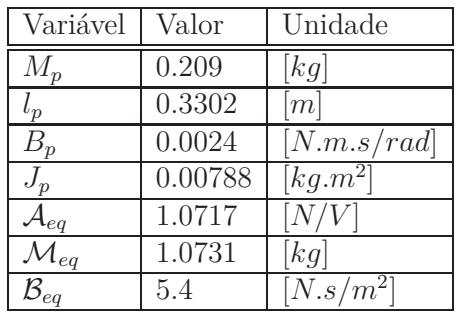
[picture p112: figure]
Variável Valor; Unidade; [N.m.s/rad]; Aeq; Meq; Beq

Tabela 1: Valores teóricos fornecidos pelo fabricante.

operação (xc, α) = (0, θ +π) que, diferente do anterior, representa um ponto de equilíbrio

12 estável. Nesta situação, o pêndulo está localizado na posição de equilíbrio vertical para baixo. Note que, naturalmente, as equações não-lineares

(Mp + Meq) ¨xc + Beq x˙c + Mp lp cos(α) ¨α − Mp lp sen(α) ˙α

2 = Aeq Vm (28)

(Mp l

2
p + Jp) ¨α + Bp α˙ + Mp lp cos(α) ¨xc + Mp lp g sen(α) = 0 | (29)

e sua versão linearizada em torno do novo ponto de equilíbrio (x0, α0) = (0, 0)

(Mp + Meq) ¨xc + Beq x˙c + Mp lp α¨ = Aeq Vm | (30)

(Mp l

2
p + Jp) ¨α + Bp α˙ + Mp lp g α + Mp lp x¨c = 0 | (31)

são idênticas às anteriores, a menos de algumas trocas de sinal. Logo, submetemos o sistema físico e o seu modelo a uma tensão Vm(t) quadrada com frequência de 4 [rad/s] e amplitude de 2.5 [V ]. Realizamos a validação para ambos os modelos (linear e não-linear), entretanto, para esta entrada em particular, não houve diferença significativa entre as respostas de ambos. A Figura 4 mostra os sinais encontrados utilizando o modelo linear em preto e os sinais medidos do sistema físico em azul. Podemos notar que o modelo capturou adequadamente as características do sistema físico, mas apresentou diferença principalmente no deslocamento do carro, em termos de amplitude, e no deslocamento do pêndulo, em termos de fase. Estas diferenças podem ser explicadas pelas incertezas relacionadas aos parâmetros como coeficientes de atrito viscoso Bp e Bc, ou como valores de eficiência do motor ηm, que dependem do ambiente, das condições de realização do ensaio, bem como do desgaste dos equipamentos. Além das variáveis, nota-se que o efeito do cabo de transmissão do sinal dos encoders e a não-planicidade do eixo de corrida do carro contribuíram para o efeito visto. Assim, para assegurar que o modelo obtido seja uma descrição convincente da realidade e para eliminar as incertezas relacionadas aos parâmetros mencionados, é importante realizar a identificação do mesmo. A próxima etapa compreende a metodologia adotada para identificação, sua aplicação e uma discussão sobre a abrangência dos resultados obtidos.

13

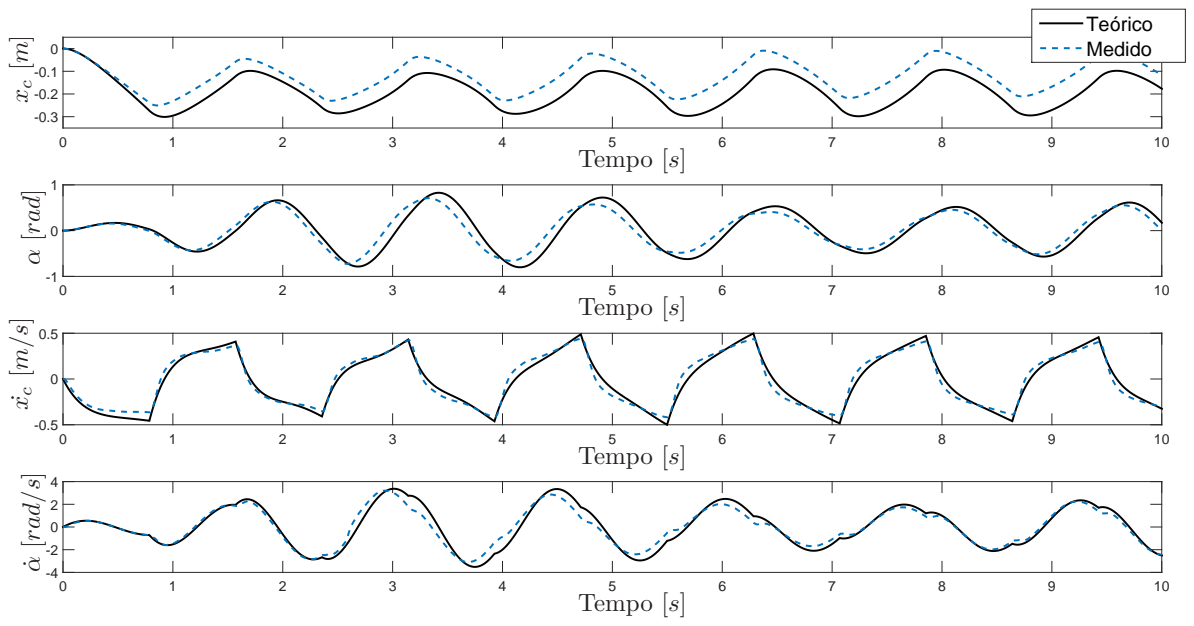
[picture p113: figure]
Teórico Medido; xc [m] α [rad]; ˙α [rad/s]; Tempo [s]

Figura 4: Resposta do sistema para entrada de onda quadrada

### 2.5.1 Identificação dos parâmetros físicos

Na seção anterior, realizamos a modelagem do sistema mecânico pêndulo invertido acoplado a um carro. As disparidades encontradas na comparação entre a simulação com os parâmetros fornecidos pelo fabricante e o sistema físico da Quanser indicam a necessidade de se aperfeiçoar o modelo de forma a obter regras de controle mais precisas. Logo, o estudo e a aplicação de técnicas de identificação é de suma relevância para a determinação de um modelo matemático adequado que descreve com precisão a dinâmica do sistema.
Neste momento, nosso objetivo é identificar os parâmetros relacionados aos coeficientes de atrito viscoso Bp, Bc e as eficiências ηm e ηg do motor e da caixa de transmissão, respectivamente. O foco nestes parâmetros vem da sua forte dependência a fatores externos, como desgaste do trilho e o ambiente experimental, enquanto que as demais grandezas Mc, Mp, e lp podem ser facilmente medidas. Os ensaios realizados durante a identificação nos permitirão, também, identificar não linearidades que não foram levadas em conta durante a modelagem.

14

### 2.5.2 Identificação do conjunto carro-motor

Nota-se das equações (30)-(31) que é possível fazer a análise em separado do conjunto carro-motor e pêndulo. Podemos, neste caso, desacoplar o pêndulo do carro, eliminando os parâmetros α(t) e Mp em (30), obtendo apenas o movimento de translação pura do carro, que assumirá o formato

Meq x¨c + Beq x˙ c = Aeq Vm | (32)

No sistema físico da Quanser esta adaptação pode ser feita simplesmente através da remoção do pêndulo da haste de apoio.
Definindo ˙xc = vc obtemos uma equação diferencial linear de primeira ordem, que pode ser escrita na forma padrão:
τ v˙c + vc = κ0 Vm | (33)

com:

κ0 =

Aeq Beq
, τ =
Meq Beq | (34)

A resposta deste sistema a uma entrada degrau com ν0 de amplitude Vm(t) = ν0, ∀t ≥ 0, é dada por:

vc(t) = κ0ν0 (1 − e

− t
τ ) | (35)

o que permite a fácil identificação dos parâmetros de constante de tempo τ e do ganho κ0. De fato, o procedimento para identificar os parâmetros passa por duas etapas bastante simples:

- Fazendo t → ∞ é fácil verificar que κ0ν0 é o valor em regime permanente de vc(t);
- Para t = τ temos que vc(τ ) = κ0(1 − e
−1

) e, portanto, τ é o instante em que a resposta vc(t) atinge 63% do seu valor de regime.

Note, entretanto, que realizando apenas este ensaio para a determinação de κ0 e τ não é possível encontrar separadamente os três parâmetros de interesse Aeq, Meq e

15

Beq. Esta dificuldade pode ser contornada com o auxílio de um ensaio extra, de mesmo formato. A ideia é acoplar uma massa conhecida ao carro Mk, de forma que a equação dinâmica resultante seja idêntica a (33), mas com a nova constante de tempo

τ

′ =

Meq + Mk

Beq

(36)

que, juntamente com (34), nos permite determinar

Beq =

Mk
τ

′ − τ

, Meq = Beqτ, Aeq = Beqκ0 | (37)

É interessante o fato de que esta simples repetição da metodologia, porém agora com uma alteração no sistema físico, permita que encontremos as três grandezas de interesse. Além disso, podemos notar que o ganho estacionário no segundo ensaio deve ser idêntico ao do primeiro κ
′

0 = κ0, o que representa um ponto de conferência para a validação do método.
Uma vez que a metodologia está definida, os dois ensaios foram realizados em bancada experimental com o sistema do fabricante Quanser e utilizando uma massa Mk = 0.25 [kg]. A identificação foi realizada para uma tensão de entrada de 4 [V ]. Os resultados estão apresentados na Tabela 2. A identificação realizada mostra, como esperado, que

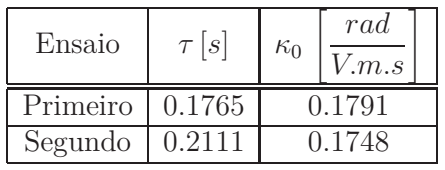
[picture p114: figure]
Ensaio; rad; Primeiro 0.1765; Segundo 0.2111

Tabela 2: Parâmetros identificados

κ0 ≈ κ

′
0

com uma discrepância pequena pouco maior que 2%. Podemos, finalmente, determinar o valor dos parâmetros da equação (32) como seguem Aeq = 1.2923 [N/V ], Beq = 7.2174 [N.s/m²

] e Meq = 1.2739 [kg].
Para fins de validar o modelo identificado, quatro entradas do tipo degrau foram aplicadas. A Figura 5 apresenta, no lado esquerdo, a velocidade para a entrada degrau unitário e, no lado direito, a velocidade para um degrau de 3 [V ]. O comportamento para

16 as entradas de 2 e 4 [V ] foram omitidos, pois são similares à resposta para a entrada de

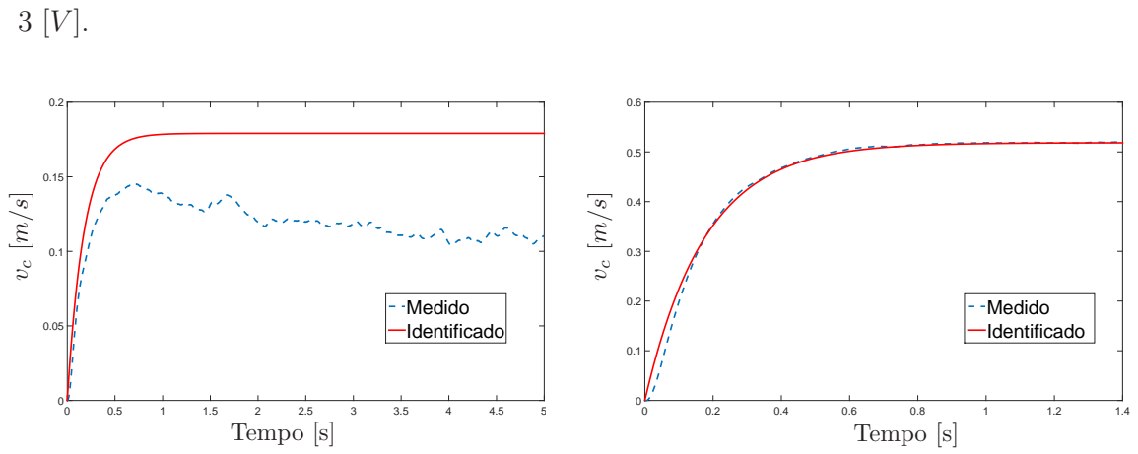
[picture p115: figure]
Medido Identificado; Tempo [s]

Figura 5: Resposta do conjunto carro-motor

Observa-se a grande discrepância entre os valores medidos e aqueles obtidos através do modelo identificado no gráfico do lado esquerdo. O fenômeno ocorre pois, para uma entrada degrau de 1 [V ], a inércia do cabo de ligação do encoder não pode ser desprezada e atua como uma forte perturbação externa que tende a retardar o movimento to carro. Além disso, sabe-se que a velocidade em regime permanente é proporcional à intensidade do degrau aplicado e, para 1 [V ], o módulo da velocidade é suficientemente baixo e torna o atrito de Coulomb bastante significativo. Este mesmo efeito pode ser notado e comprovado no gráfico do lado direito da figura. Para vc < 0.3 [m/s], há uma disparidade entre a curva identificada e a curva medida pelas razões já mencionadas. Acima deste patamar, o modelo recupera fielmente o comportamento do sistema físico.

### 2.5.3 Identificação do pêndulo

Para identificar os parâmetros da equação (31) trava-se o movimento do carro e considera-se somente a oscilação do pêndulo. Neste caso ¨xc é eliminada da equação (31), que pode ser escrita como

α¨ + 2 ξ ωn α˙ + ω

2
nα = 0 | (38)

em que:

### 2 ξ ωn =

Bp
(Mp l
2

p + Jp)

, ω²
n =

Mp lp g
(Mp l
2

p + Jp)

(39)

17

Verifica-se que, a partir da determinação da frequência natural não-amortecida ωn e do fator de amortecimento ξ, é possível obter os parâmetros Bp e Jp desejados. Os desenvolvimentos que seguem foram baseados em [13]. De fato, considerando que o pêndulo parte do repouso com condição inicial α(0) = α0 e, aplicando a Transformada de Laplace em (38) obtemos

αˆ(s) = α0 (s + 2 ξ ωn)
s
| 2 + 2 ξ ωn s + ω²
n
= α0
| s + ξωn (s + ξωn) 2 + ω

2
d

+

ξωn
ωd

!
ωd
(s + ξωn)

2 + ω
2
d

!

em que ωd = ωn

√
1 − ξ

2 é a frequência natural amortecida. A transformada inversa de Laplace, por sua vez, nos permite encontrar a resposta no tempo do sistema da seguinte forma:

α(t) = α0e

−ξωnt
ωd

(ωd cos(ωdt) + ξωnsen(ωdt))

=

α0e

−ξωnt
sen(φ)
sen(ωdt + φ) | (40)

em que:
tg(φ) = ωd
ξωn

=

q
ξ
−2 − 1 | (41)

para 0 < ξ < 1. É importante notar que, a partir da equação (40), a derivada de α(t) no tempo nos permite observar que os pontos de máximo e mínimo da função satisfazem a regra tg(ωd t + φ) = tg(φ), ou seja:

ωd ti = i π , i = 0, 1, 2, ... | (42)

Logo, como ωd(ti+1 − ti) = π, temos que para os m pontos de máximo e mínimo obtidos da medida do deslocamento, o valor médio fornece a relação:

ωd =

(m − 1) π
mX−1

i=1

(ti+1 − ti)

(43)

18

Com a aplicação dos mesmos instantes de tempo na equação (40), obtemos:

α(ti) = α0 e

−ξ ωn ti

(−1)i
, i = 0, 1, 2, ... | (44)

que faz com que os pontos de máximo e mínimo satisfaçam a relação:

|α(ti+1)|

## |α(ti)|

= e

−ξ ωn (ti+1−ti) = e

− π
tg(φ) | (45)

Por fim, de maneira equivalente, após algumas manipulações algébricas, chegamos à igualdade
tg(φ) = | (m − 1) π
mX−1

i=1

(ln(|α(ti)|) − ln(|α(ti+1)|))

(46)

Observe que, após determinar ωd a partir de (43), a utilização da equação (46), juntamente com (41) nos permite obter o valor do fator de amortecimento ξ e, consequentemente, da frequência natural não-amortecida ωn, concluindo o procedimento adotado. No sistema físico, fixou-se o carro de maneira que este não influenciasse nas leituras de α(t) e deslocou-se pêndulo até a condição inicial α0 = 0.2562 [rad]. Utilizando os valores de máximo e mínimo de α(t), determinamos ξ, ωn e, consequentemente, os parâmetros Bp e Jp desejados. Repetimos este ensaio para a condição inicial α0 = 0.3912 rad, sendo que a média dos valores obtidos está apresentada na Tabela 3.

Tabela 3: Parâmetros identificados do pêndulo

A Figura 6 compara a posição angular medida com a obtida a partir do modelo identificado. Foram utilizados m = 58 pontos para o procedimento. Apresentamos a resposta apenas a partir dos 20 [s] iniciais, haja vista que o ajuste para t ≤ 20 [s] é fiel às medidas do sistema.
Nota-se que a condição de sistema subamortecido é encontrada na resposta α(t). Observe que, a partir dos 60 [s], as duas curvas começam a se diferenciar e os pontos

19

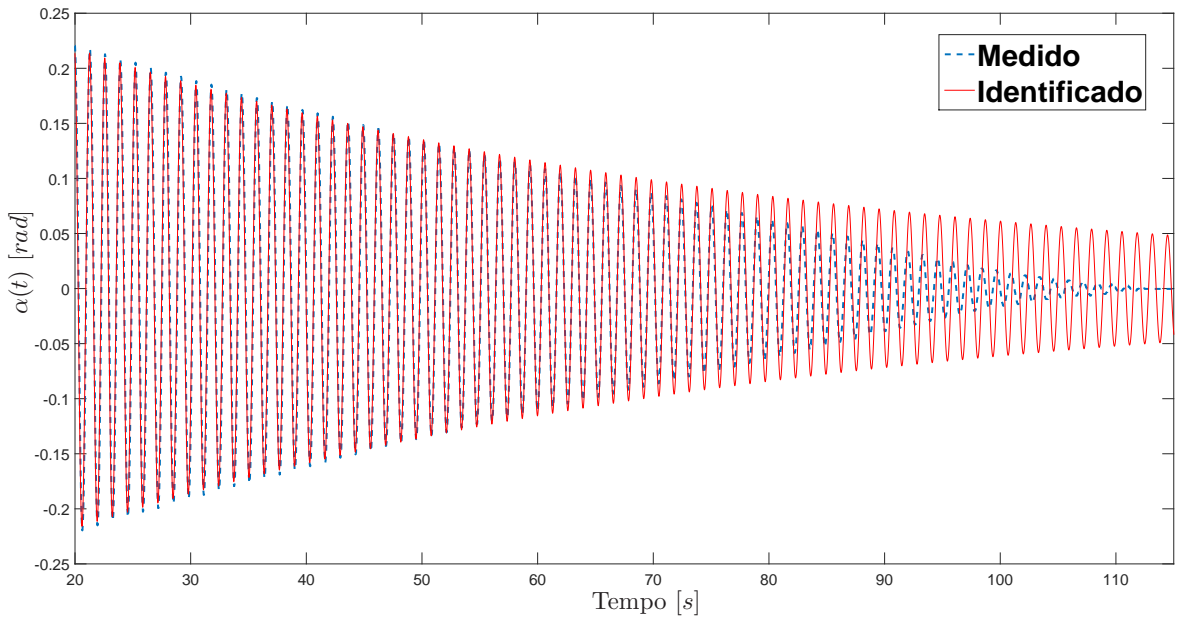
[picture p116: figure]
Medido Identificado; α(t) [rad]; Tempo [s]

Figura 6: Deslocamento angular do pêndulo

coletados no ensaio tendem mais rapidamente à origem do que o sistema identificado. Este fato está relacionado à omissão no modelo, da força de atrito de Coulomb, que atua no pêndulo sempre que a velocidade muda de sentido e sua influência cresce quanto menor é a velocidade angular do pêndulo. Utilizaremos os valores de ξ e ωn encontrados durante o processo de identificação para a determinação de Bp e Jp, cujos valores serão apresentados a seguir.

### 2.5.4 Comparação dos resultados

Os resultados obtidos nas sessões anteriores são resumidos na Tabela 4. É notável uma diferença significativa entre os valores fornecidos pelo fabricante Quanser e os valores obtidos na identificação do sistema. Esta disparidade torna-se importante na variável Bp, que é 65% menor do que o valor fornecido pelo fabricante.
A Figura 7 faz a comparação entre resposta do sistema real, o modelo com parâmetros identificados e o modelo com parâmetros Quanser. Aplicou-se uma forma de onda quadrada com frequência de 4 [rad/s] e amplitude de 2.5 [V ] na entrada Vm(t). A

20

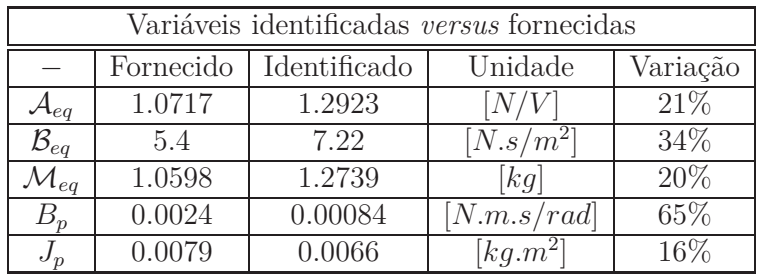
[picture p117: figure]
Variáveis identificadas versus fornecidas; − Fornecido Identificado; Unidade; Variação; Aeq; Beq; Meq; [N.m.s/rad]

Tabela 4: Comparação entre os resultados

curva em linha tracejada azul representa a resposta experimental do conjunto. A linha cheia vermelha simula o modelo do pêndulo com parâmetros identificados e, finalmente, a linha cheia preta simula o modelo com parâmetro fornecidos pelo fabricante Quanser. É notável que a identificação do sistema utilizando a metodologia apresentada permitiu a

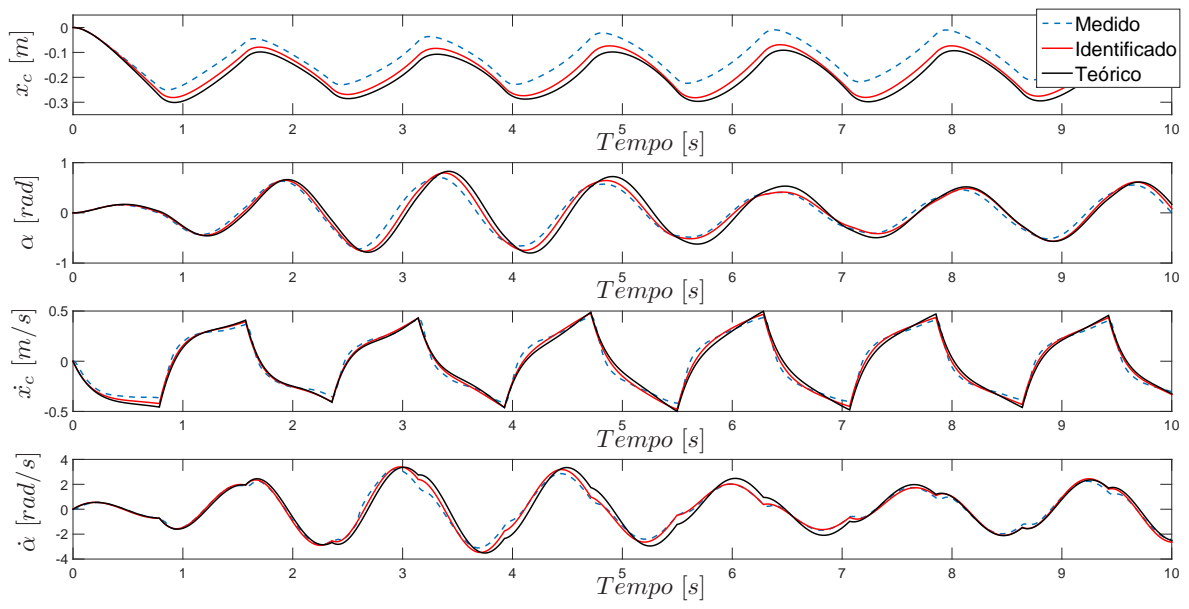
[picture p118: figure]
Medido; Identificado Teórico; xc [m] α [rad] ˙xc [m/s] ˙α [rad/s]; T empo [s]

Figura 7: Comparação do sistema para onda quadrada

obtenção de um modelo mais preciso do que aquele fornecido pelo fabricante. Isto ocorre devido à maior proximidade das variáveis identificadas para o sistema real, uma vez que o desgaste de uso e condições de laboratório influenciam nestes fatores. Porém, também é importante discutir os problemas do modelo em si. A resposta da simulação com parâmetros identificados define bem a dinâmica do sistema, embora note-se que há uma pequena

21 defasagem, principalmente na variável α e sua derivada. A explicação para este fenômeno se dá devido à não linearidades, como o atrito de Coulomb, que não foram considerados no modelo. Para a variável xc, a maior disparidade está na amplitude do deslocamento. Neste caso, os fatores externos são responsáveis pelo efeito, pois a influência do cabo do encoder e a não planicidade do trilho de corrida alteram a dinâmica. Apesar disso, é fato que o modelo engloba com bastante eficiência o movimento do conjunto como um todo, e segue corretamente os dados coletados do ensaio. Verificamos, então, de maneira clara, que o modelo é suficientemente adequado para a determinação de regras de controle. Os valores da Tabela 4, aplicados à dinâmica linear do pêndulo invertido modelada pelas matrizes (19)-(20), nos proporcionam os seguintes resultados

A =

0 | 0 | 1 | 0
0 | 0 | 0 | 1
0 1.2139 −5.4713 −0.0015
0 25.5963 −12.7038 −0.0311

, B =

0
0
0.9794
2.2759

(47)

que representam o sistema pêndulo invertido linear do fabricante Quanser.

### 3 Controle Multiobjetivo Através da Rede

Considere um sistema a tempo contínuo com a seguinte realização no espaço de estado

x˙(t) = Aσ(t) x(t) + Bσ(t) u(t) + Hσ(t) w(t), x(0) = 0 | (48)
z(t) = Eσ(t) x(t) + Fσ(t) u(t) | (49)

na qual x ∈ R
nx é o estado, u ∈ R
nu é a entrada de controle, w ∈ R nw é a entrada exógena e

z ∈ R

nz é a saída controlada. A lei de controle possui a seguinte estrutura u(t) = Kσ(t) x(t) em que {K1, · · · , KN } são ganhos de realimentação de estado a ser determinados em conjunto com a regra de comutação σ(x) : R

nx → {1, · · · , N} := K. Esta lei deve

22 assegurar estabilidade e um limitante superior adequado para o custo funcional H2 dado por
J2(σ) = Xnw

k=1

## kzkk

2
2

(50)

em que zk é a saída correspondente à entrada impulsiva w(t) = δ(t)ek, a qual representa a aplicação de um impulso unitário no k-ésimo canal (ek é a k-ésima coluna da matriz identidade). Nota-se que o índice J2(σ) se iguala à norma H2 ao quadrado do subsistema i quando σ(t) = i, ∀ t ≥ 0. Este problema já foi tratado na literatura, mais especificamente, nas referências [4] e [12]. As condições de projeto dependem de uma subclasse especial de matrizes de Metzler Mc composta por matrizes Π = {πji} ∈ R

N×N com as seguintes
propriedades

πji ≥ 0, ∀i 6= j e
X

N

j=1

πji = 0, ∀i ∈ K | (51)

É fácil notar que πii ≤ 0, ∀i ∈ K. Definindo He{X} = X + X′

como sendo o operador
Hermitiano para a matriz quadrada X, podemos apresentar o teorema a seguir, disponível em [4], que fornece as condições para o cálculo dos controladores e da regra de comutação.

Teorema 1 Se existirem matrizes simétricas Si

, Tij , matrizes Yi para j 6= i ∈ K × K e

uma matriz de Metzler Π ∈ Mc satisfazendo as desigualdades de Lyapunov-Metzler

He{AiSi + BiYi} +
P
j6=i∈K πjiTij | •
EiSi + FiYi | −I
< 0, i ∈ K | (52)
Tij + Si | •
Si | Sj
> 0, i 6= j ∈ K × K | (53)

então a regra de comutação

σ(x(t)) = arg min
i∈K

x(t)
′Si

−1
x(t) | (54)

e os ganhos de realimentação de estado Ki = YiSi

−1
para todo i ∈ K fazem com que

a origem x = 0 do sistema em malha fechada seja um ponto de equilíbrio globalmente

assintoticamente estável. Ademais, a desigualdade J2(σ) < mini∈K tr(Qi) é satisfeita

23 sempre que existirem matrizes Qi para todo i ∈ K tais que as seguintes LMIs
Qi | •
Hi | Si
> 0, i ∈ K | (55)

sejam válidas.

Um dos pontos mais importantes deste teorema é que ele garante estabilidade do sistema em malha fechada mesmo que todos os subsistemas sejam não-controláveis e nãoestabilizáveis, ou seja, ainda que não seja possível determinar Ki que garanta estabilidade de cada um dos respectivos subsistemas (Ai

, Bi), i ∈ K. De fato, definindo
AMi | = Ai + BiKi e EMi | = Ei + FiKi as desigualdades (52) e (53) são equivalentes
a
| He
| Pi
AMi +
| | πii
| | 2 I

+
X
| | N
| | j6=i=1 πjiPj + E ′
MiEMi < 0, i ∈ K | (56)

e, como πii ≤ 0, as matrizes AMi

, ∀i ∈ K não precisam ser estáveis como condição necessária. Além disso, como apresentado em [14], a função de comutação apresentada neste teorema é consistente, ou seja, sempre fornece um desempenho no mínimo igual ao melhor desempenho dos subsistemas.
Nosso objetivo é utilizar este resultado para tratar do controle H2 do pêndulo invertido com representação em espaço de estado

G :=

x˙(t) = A x(t) + B u(t) + H w(t), x(0) = 0

z(t) = Eσ(t) x(t) + Fσ(t) u(t)

(57)

na qual a saída z(t) passa a ser definida por N critérios diferentes e conflitantes, que caracterizam um problema de controle multiobjetivo como apresentado em [11]. Utilizaremos neste trabalho N = 2 saídas diferentes aplicadas à dinâmica do pêndulo. Note que o sistema (57) pode ser escrito de forma equivalente com a mesma equação, mas considerando w(t) = 0 e x(0) = H. A dificuldade reside na implementação prática da lei de controle proposta no Teorema 1 que, em geral, exige uma frequência de comutação muito elevada. Na prática, este efeito induz a presença de trepidação no sistema, po-

24 dendo ocasionar danos ao conjunto. Para contornar este efeito, é necessária uma regra de comutação que garanta estabilidade para frequências de comutação limitadas, o que também viabiliza o controle através de redes de comunicação, pois permite respeitar a sua largura de faixa. Algumas propostas podem ser encontradas em [1], [9] e [10]. Neste trabalho, adotou-se a estratégia de trabalhar com o sistema contínuo amostrado de tal maneira que as normas deste e do sistema discreto sejam idênticas.
Mais detalhes e resultados estão disponíveis no artigo [5]. As próximas seções apresentam a técnica de discretização utilizada e o controle multiobjetivo discreto aplicados ao pêndulo invertido e implementado através de uma rede de comunicação.

### 3.1 Discretização exata

A realização do controle através de redes de comunicação é suscetível a eventos intrínsecos de um canal imperfeito. Podemos citar a quantização e atraso, largura de faixa limitada e perda de pacotes de dados como os efeitos principais. Eles são amplamente discutidos e bem fundamentados na literatura, com destaque para [23]. Neste trabalho nos atentamos à largura de faixa limitada, que será modelada para aplicação no controle multiobjetivo. Assim, dedicamos esta seção ao desenvolvimento da teoria necessária à discretização exata do sistema contínuo amostrado.
Considere o modelo do pêndulo invertido (57), mas com uk(t) no lugar de u(t) em que
uk(t) = u(tk), ∀t ∈ [tk, tk+1) | (58)

é o esforço de controle que será o mesmo entre dois instantes de amostragem sucessivos, com período tk+1 − tk = T > 0, ∀k ∈ N, ou seja, até que haja uma atualização de seu valor por intermédio da rede com largura de faixa de 1/T [Hz]. Definindo

A =

A B
0 0

∈ R

(nx+nu)×(nx+nu)
(59)

Eσ =

Eσ Fσ
∈ R

nz×(nx+nu)
(60)

25 podemos apresentar o seguinte teorema, que fornece um sistema discreto equivalente em termos de custo H2.

Teorema 2 Considere o sistema dinâmico G, e defina matrizes (Ad, Bd, Ed i, Fd i) de di-

mensões compatíveis tais que

e

AT =

Ad Bd

### 0 I

(61)

Qi =

Z T

0

e

A′
t
E

′
i Ei e

At
dt =

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
, i ∈ K | (62)

O sistema a tempo discreto equivalente é dado por

Ge :=

x(k + 1) = Ad x(k) + Bd uk, x(0) = H

z(k) = Edσ x(k) + Fdσ uk

(63)

e a seguinte igualdade é satisfeita
Z ∞

0

z(t)
′

z(t) dt =
X

k∈N

z

′
k
zk | (64)

É digno de nota que a relação apresentada no Teorema 2 é exata no sentido que o custo H2 do sistema a tempo contínuo é idêntico ao do sistema a tempo discreto. As matrizes (Ad, Bd, Edi, Fdi), i ∈ K, são bem definidas, visto que são encontradas de técnicas como o cálculo de exponencial de matriz e decomposição em valores singulares. As provas para estes resultados se encontram em [23] e [24], assim como uma discussão mais abrangente. O Teorema 2 foi aplicado às matrizes A e B, definidas em (47), que representam a dinâmica do pêndulo invertido linear identificado na Seção 2 para um período de amostragem de T = 0.1 [s]. A condição inicial H e as saídas escolhidas para o controle

26

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

Ed2 =

−3.1621 1.9731 −0.1698 0.0973 −0.0161 −0.0020 0.2651 −0.0213 −0.0316 −0.0487 0.0061 −0.0506 0.0034 0.0058 −0.0007 −0.0084 −0.0012 −0.0021 −0.0001 0.0020

, Fd2 =

0.0019
0.0102
−0.0070
−0.0059
0.0056

(69)

Note que as dimensões de z(k) e z(t) são diferentes. Isto ocorre pois a integral em (62) é semidefinida positiva e sua decomposição em valores singulares é dada por

Qi = ViXiV
′

i = E
′
iEi | (70)

em que Vi ∈ R
(nx+nu)×(nx+nu)

e Xi = X′
i ∈ R

(nx+nu)×(nx+nu)

. Portanto, Ei = X

1/2
i | V ′
| i em
que Edi ∈ R

(nx+nu)×nx e Fdi ∈ R

(nx+nu)×nu para todo i ∈ K.

### 3.2 Sistema com comutação à tempo discreto

Tendo obtido o modelo equivalente discreto Ge para o sistema contínuo G, podemos aplicar as condições propostas em [6] para o projeto de uma lei de controle

uk = Kσxk | (71)

que consiste na determinação conjunta de ganhos de realimentação de estado {K1, · · · , KN } e da função de comutação σ(x(k)) : R

nx −→ K, que asseguram um custo garantido H2 de desempenho. O teorema seguinte, disponível em [6], apresenta este resultado e utiliza a subclasse especial de matrizes de Metzler Md, composta por matrizes Π = {πji} ∈ R
| N×N
com as seguintes propriedades

πji ≥ 0 e X

N

j=1

πji = 1, ∀i, j ∈ K × K | (72)

É fácil notar que 0 ≤ πii ≤ 1, ∀i ∈ K.

Teorema 3 Se existirem matrizes simétricas Si

, Tij , matrizes Ji | , Yi para todo i, j ∈ K×K

28 e uma matriz de Metzler Π ∈ Md satisfazendo as desigualdades de Lyapunov-Metzler
Si | • •
Ad Si + Bd Yi | Vi | •
Edi Si + Fdi Yi | 0 I
> 0, i ∈ K | (73)
Tij | •
Ji | Si
> 0, i, j ∈ K × K | (74)

com Vi = Ji + J
′
i −

PN
j=1 πji Tij , então a regra de comutação

σ(x(k)) = arg min
i∈K

x(k)
′ S

−1
i | x(k) | (75)

e os ganhos de realimentação de estado Ki = Yi S

−1
i para todo i ∈ K fazem com que a

origem x = 0 do sistema em malha fechada (63) seja um ponto de equilíbrio globalmente

assintoticamente estável. Ademais, a desigualdade J2(σ) < mini∈K tr(Qi) é satisfeita

sempre que existirem matrizes Qi para todo i ∈ K tais que as seguintes LMIs

Qi •

H Si

> 0, i ∈ K | (76)

sejam válidas.

Da mesma forma do caso contínuo, é possível mostrar que como 0 ≤ πii ≤ 1, nenhuma propriedade de estabilidade é exigida das matrizes em malha fechada Ad +

BdKi

, ∀i ∈ K. A prova e uma discussão mais abrangente podem ser encontradas em [4] e [6]. A solução das condições do Teorema 3 pode ser realizada através de busca exaustiva em relação aos elementos da matriz Π ∈ Md e a partir da solução de um conjunto de LMIs que, para o caso em questão, é uma tarefa bastante simples e computacionalmente viável, pois o sistema é composto de somente dois subsistemas.

29

### 3.3 Aplicação no pêndulo invertido

Resolvemos o Teorema 3 para o sistema Ge, definido pelas matrizes (67)-(69). Observe que, para N = 2 subsistemas, a matriz de Metzler é do tipo Π ∈ R

2×2 dada por

Π =

p | (1 − q)
(1 − p) | q

(77)

Logo, o teorema pode ser resolvido sem dificuldades através de uma busca unidimensional em relação aos elementos (p, q), com o auxílio do software MATLABr. O passo de incrementação utilizado foi de 0.1. A Figura 8 apresenta um gráfico 3D que expressa o custo garantido H2 em relação aos elementos de Π. Nesta figura, o plano representa o

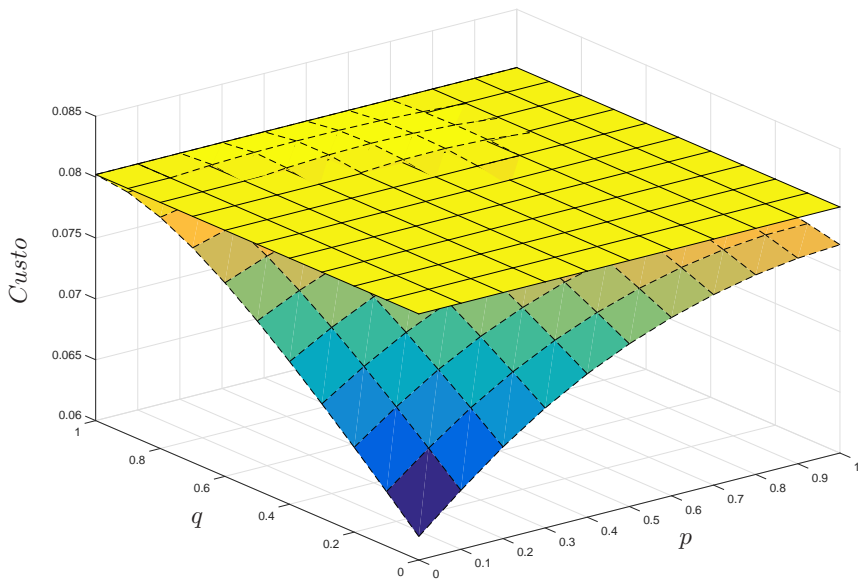
[picture p119: figure]
Custo

Figura 8: Custo garantido em função dos elementos da matriz de Metzler

custo H2 mínimo de ambos os sistemas isolados, que vale 0.0802. Mais especificamente, considerando isoladamente o primeiro subsistema, temos

K1 =

45.8496 −81.0764 25.1025 −15.7083 (78)

30 e uma norma H2 ao quadrado de 0.0802. Enquanto que, considerando isoladamente o segundo subsistema, temos

K2 =

82.1883 −124.9026 38.9166 −23.7426 (79)

e uma norma H2 ao quadrado de 0.1074. Utilizando o sistema com comutação o custo garantido H2 foi de 0.0619 e foi obtido para (p , q) = (0 , 0). Este valor representa um ganho de desempenho garantido de 23% em relação às técnicas de controle clássico. Resolvendo as condições do Teorema 3 para esta matriz Π obtivemos as seguintes matrizes definidas positivas

S

−1
1 =

36.2792 −26.0066 6.6809 −3.4220 −26.0066 22.5134 −6.4969 3.4275
6.6809 | −6.4969 | 2.1862 −1.1447
−3.4220 | 3.4275 | −1.1447 0.6049

(80)

S

−1
2 =

31.5147 −18.8330 4.4922 −2.0584 −18.8330 12.7061 −3.5005 1.5996
4.4922 | −3.5005 | 1.3164 −0.5859
−2.0584 | 1.5996 | −0.5859 0.2655

(81)

as quais foram utilizadas para a implementação da regra de comutação, em conjunto com os ganhos de realimentação de estado

K1 =

58.6348 −69.3645 22.1655 −12.5250 (82)

K2 =

63.5859 −106.8128 32.7673 −20.5192 (83)

Os controladores e a regra de comutação determinados foram incluídos em uma rotina na plataforma Simulink do software MATLABr para a obtenção da evolução temporal dos estados do sistema. O custo verdadeiro obtido a partir de simulação numérica foi de J2(σ) = 0.0394 < 0.0619 indicando que, na verdade, o ganho real de desempenho foi de

31

51%.
A Figura 9 compara a resposta no tempo para cada variável de estado, além de exibir o esforço de controle e a regra de comutação simulada. Os resultados são exibidos para o controle com comutação, controle clássico H2 para o subsistema 1 e controle clássico H2 para o subsistema 2.

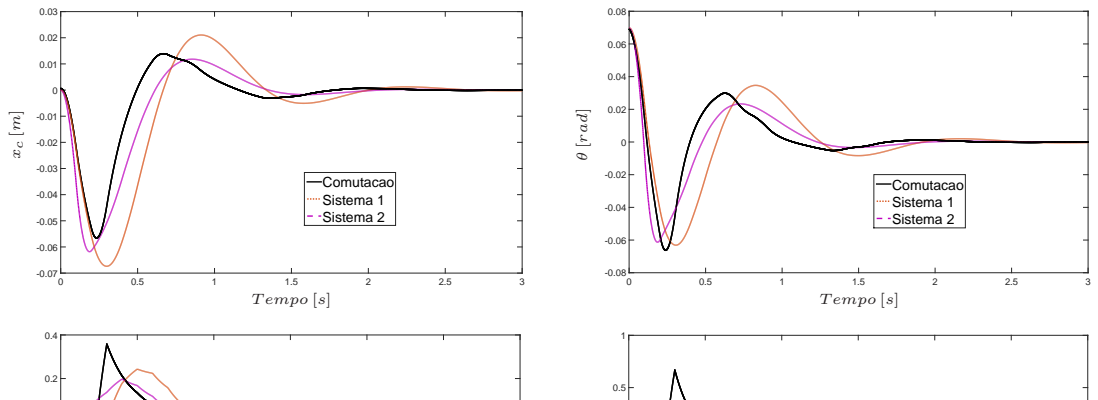
[picture p120: figure]
Comutacao Sistema 1 Sistema 2; T empo [s]; θ [rad]

0 | 0.5 | 1 | 1.5 | 2 | 2.5 | 3

-0.8

-0.6

-0.4

-0.2

0

Comutacao
Sistema 1
Sistema 2

˙xc [m/s]

T empo [s]

0 | 0.5 | 1 | 1.5 | 2 | 2.5 | 3

-1.5

-1

-0.5

0

Comutacao
Sistema 1
Sistema 2

˙θ [rad/s]

T empo [s]

0 | 0.5 | 1 | 1.5 | 2 | 2.5 | 3

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
Comutacao
Sistema 1
Sistema 2

u [V ]

T empo [s]

0 | 0.5 | 1 | 1.5 | 2 | 2.5 | 3

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
T empo [s]
Figura 9: Trajetórias do estado, esforço de controle e regra de comutação simulada.

A validação da lei de controle proposta foi feita através de implementação da regra na planta do fabricante Quanser. Repetimos o ensaio 16 vezes e obtivemos as trajetórias apresentadas na Figura 10, que apresenta o evolução no tempo de todas as variáveis de estado, o esforço de controle e a regra de comutação. Em linha contínua preta estão os sinais obtidos por simulação no MATLAB, em azul as médias dos valores

32 medidos e a região sombreada é aquela definida por um desvio padrão.

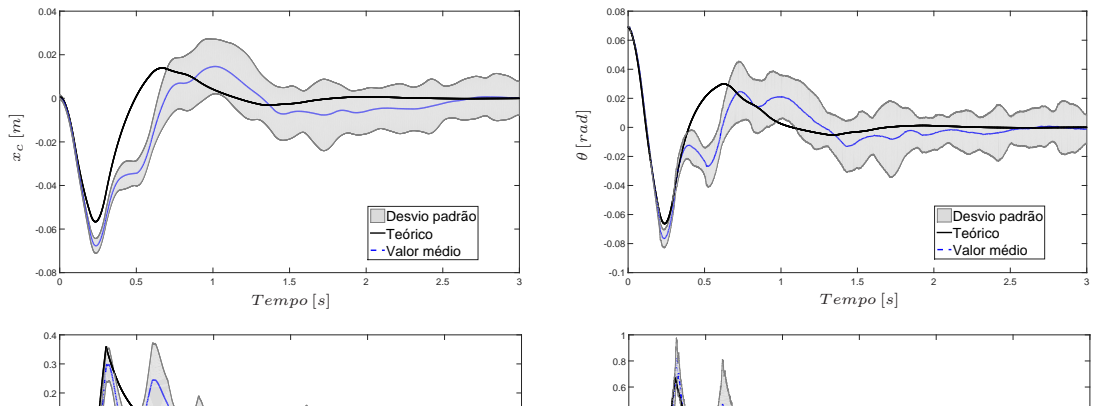
[picture p121: figure]
Desvio padrão Teórico Valor médio; T empo [s]; θ [rad]

0 | 0.5 | 1 | 1.5 | 2 | 2.5 | 3

-0.5

-0.4

-0.3

-0.2

-0.1

0

0.1

Desvio padrão
Teórico
Valor médio

˙xc [m/s]

T empo [s]

0 | 0.5 | 1 | 1.5 | 2 | 2.5 | 3

-1

-0.8

-0.6

-0.4

-0.2

0

0.2

0.4

Desvio padrão
Teórico
Valor médio

˙θ [rad/s]

T empo [s]

0 | 0.5 | 1 | 1.5 | 2 | 2.5 | 3

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
Desvio padrão
Teórico
Valor médio

u [V ]

T empo [s]
Figura 10: Trajetórias do estado e esforço de controle real.

Como pode ser notado, de maneira geral, a implementação da regra capturou corretamente a dinâmica do sistema com comutação. Para t ≤ 0.4 [s] a resposta é fiel e precisa comparada à simulação computacional. Para 0.4 < t < 0.8 [s] a resposta do conjunto perde sua fidelidade, pois, como já discutido na Seção 2, para velocidades baixas do carro, o sistema se torna muito sensível a não-linearidades que não foram levadas em conta durante a modelagem, como por exemplo, o atrito de Coulomb, a folga no conjunto pinhão-cremalheira e a influência do cabo do encoder. Para t ≥ 0.8 [s], os estados evoluem para a origem x = 0, como esperado. É importante ressaltar a robustez da estratégia de controle face a diversos fenômenos e incertezas que foram ignorados durante

33 a modelagem do sistema. Mesmo diferindo sensivelmente dos resultados de simulação, as trajetórias sempre evoluem para a origem.

### 4 Perspectivas futuras

Como continuidade, ainda durante o mestrado, pretendemos generalizar os resultados apresentados para tratar do controle cooperativo de várias estações de trabalho IP02 da Quanser através do compartilhamento da mesma rede de comunicação. O esquema da arquitetura de controle a ser adotada está apresentada na Figura 11. Neste caso, a regra de comutação σ atuará como coordenadora do processo, que escolherá a cada instante de tempo qual planta deve receber o sinal de controle uk atualizado, enquanto que as demais devem manter a última informação recebida. O controle global deve ser capaz de assegurar estabilidade e um custo garantido H2 de desempenho.

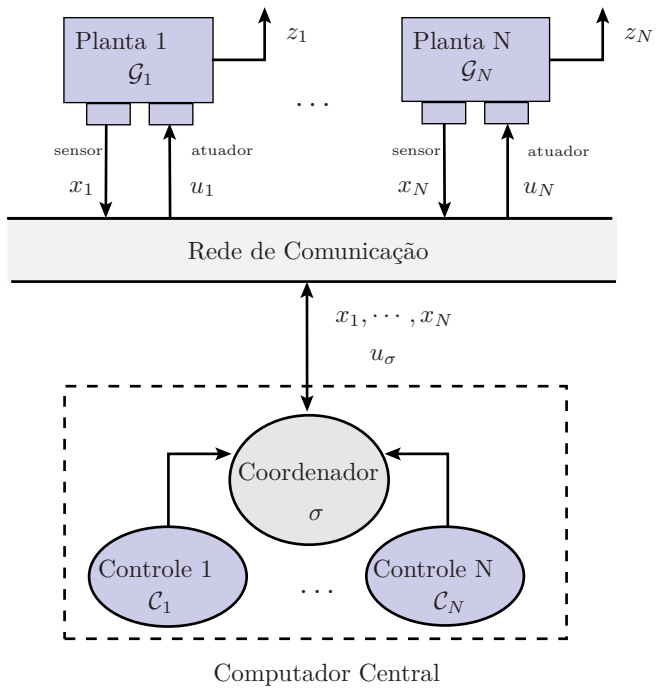
[picture p122: figure]
Planta 1; Planta N; Rede de Comunicação; Coordenador; Controle 1; Controle N; Computador Central; sensor; atuador

Figura 11: Arquitetura de Controle

34

### 5 Conclusão

Todas as etapas propostas foram realizadas de forma satisfatória. O trabalho permitiu o desenvolvimento de um modelo adequado do conjunto pêndulo invertido IP02 do fabricante Quanser, além do levantamento de algumas limitações para aplicação prática, como a influência de não linearidades para baixas velocidades. As vantagens do controle com comutação foram discutidas e sua implementação foi realizada através de redes de comunicação, tanto em um ambiente simulado quanto na prática. Nota-se um grande potencial na técnica, na qual o projeto conjunto da regra de comutação com os ganhos matriciais é uma promissora alternativa para o controle H2.

35

### Referências

[1] L. I. Allerhand, U. Shaked, Robust state-dependent switching of linear systems with dwell time, IEEE Transactions on automatic control, vol. 58, pp. 994-1001, 2013.
[2] A. M. de Oliveira, Análise e controle de um sistema mecânico com dados transmitidos através de rede, Dissertação de Mestrado, FEEC/UNICAMP, 2015.
[3] L. F. de Oliveira, Controle com comutação H∞ de um pêndulo invertido, Trabalho de Graduação, FEM/UNICAMP, 2015.
[4] G. S. Deaecto, Projeto de controladores dinâmicos com comutação: Aplicação

em sistemas mecânicos e conversores de potência CC-CC, Tese de Doutorado, FEEC/UNICAMP, 2010.

[5] G. S. Deaecto, J. C. Geromel, J. Daafouz, Dynamic output feedback H∞ control of switched linear systems, Automatica, vol. 47, pp. 1713-1720, 2011.
[6] G. S. Deaecto, M. Souza, J. C. Geromel Discrete-time switched linear systems con-

trol design with application to networked control, IEEE Transactions on Automatic Control, vol. 60, pp. 877-881, 2015.

[7] R. A. DeCarlo, M. S. Branicky, S. Pettersson, and B. Lennartson, Perspectives and

results on the stability and stabilizability of hybrid systems, IEEE Transactions on automatic control, vol. 88, pp. 1069–1082, 2000.

[8] F. G. Dedini, Projeto e otimização de uma transimissão planetária por rolos de tração, Dissertação de Mestrado, FEM/UNICAMP, 1985.
[9] C. Duan, F. Wu, Analysis and control of switched linear systems via dwell-time min-switching, Systems and Control Letters, vol. 70, pp. 8–16, 2014.
[10] C. Duan, F. Wu, Analysis and control of switched linear systems via modified Lyapunov-Metzler inequalities, International Journal of Robust and nonlinear Control, vol. 24, pp. 276–294, 2014.

36

[11] J. C. Geromel, G. S. Deaecto, P. Colaneri, Multi-objective H2 control via switched linear systems, IFAC Symposium on System, Structure and Control, 2007.
[12] J. C. Geromel and G. S. Deaecto, Switched state feedback control for continuous-time uncertain systems, Automatica, vol. 45, pp. 593-597, 2009.
[13] J. C. Geromel, R. H. Korogui, Controle linear de sistemas dinâmicos: Teoria, ensaios práticos e exercícios, Editora Edgard Blucher Ltda, 2011.
[14] J. C. Geromel, G. S. Deaecto, J. Daafouz, Suboptimal switching control consistency analysis for switched linear systems, IEEE Transactions on Automatic Control, vol. 58, pp. 1857-1861, 2013.
[15] J. P. Hespanha, A. S. Morse, Switching between stabilizing controllers, Automatica, vol. 38, pp. 1905–1917, 2002.
[16] J. P. Hespanha, P. Naghshtabrizi, Y. Xu, A survey of recent results in networked control systems, Proceedings of the IEEE, vol. 95, pp. 138-162, 2007.
[17] D. Liberzon, Switching in systems and control, Birkhäuser, 2003.
[18] L. Ljung, K. Glover, Frequency domain versus time domain methods in system Indentification, Automatica, vol. 17, pp. 71–86, 1981.
[19] K. Ogata, Engenharia de controle moderno, Pearson Prentice Hall, ed. 5, pp. 61–62, 2010.
[20] Quanser, User manual, IP02 Linear Inverted Pendulum and IP02 Linear Pendulum

Gantry Experiments, Ontario, 2012.

[21] V. C. Scarpa, Controle com comutação H2 de um pêndulo invertido, Trabalho de Graduação, FEM/UNICAMP, 2014.
[22] R. Shorten, F. Wirth, O. Mason, K. Wulff, and C. King, Stability criteria for switched and hybrid systems, SIAM Rev., vol. 49(4), pp. 545–592, 2007.

37

[23] M. Souza, Controle de sistemas dinâmicos através de redes de comunicação, Dissertação de Mestrado, FEEC/UNICAMP, 2012.
[24] M. Souza, G. S. Deaecto, J. C. Geromel, J. Daafouz, Self-triggered linear quadratic networked control, Optimal Control, Applications and Methods, vol. 35, pp. 524-538, 2014.
[25] Z. Sun, and S. S. Ge, Switched Linear Systems: Control and Design, Springer, 2005.

38
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
