mferreiracosta/tcc_cefet/TCC 1/Referências Bibliográficas/Eletromecânica MOTOR/Resolução Exercício - Vibrações Mecânicas.pdf

Determinar a constante de amortecimento c para que, uma vez deslocada da posição de equilíbrio, o corpo composto (barra uhd, esfera) tenha um decaimento de 60% em 4 ciclos.

I – Pela equação diferencial;
II – Por massa e rigidez efetivas.

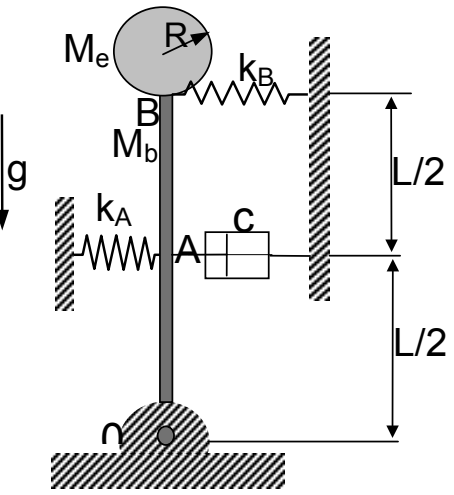
[picture p131: figure]

kA = kB = k = 2000N/m

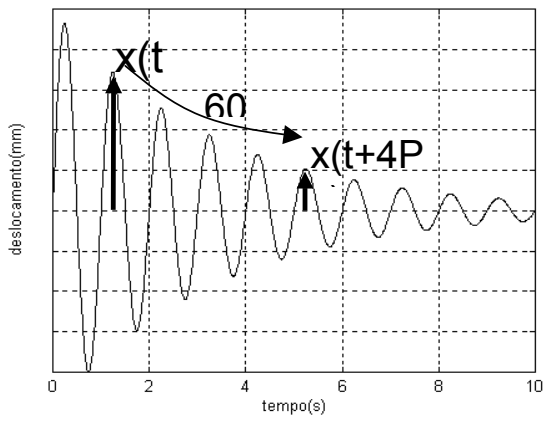
[picture p132: figure]

Esfera: massa Me = 1 kg; raio R = 5 cm; JCM = 2/5.massa.Raio²
g = 9,80 m/s²

Barra: uniforme, homogênea e delgada massa Mb = 9 kg ; comprimento = L =1 m; JCM = 1/12.massa.compr²

::r-P",lô Gqvé]c50 d\-'c<?Y'erICiG\
De L | I
VkzCf)

1
\
íZ

I
J.e'X!3 | \ | LS I
..., | --1
| Jj\
\ | I
| L-

\

\
iIIbCO | I
| /~ | I
--k. X#l | ;tA

I
C

. .AI

'~A | I
I
R-y | 8
| | 12)( | o

ZéV\o=- éfo 8

00 := doe, -t dOe | 00Ô =- JÔC.M 4- tY\dZi~.z =~. | J'llb L;:( + V\Q~Z
Jo~ | 3-!-1(1035 | 102 | 'l
Jo =' Li,103S | (fog=-..L9 | jZ+CJ 1.2 =3.. {-3- =: C)+<>2l-=' 3(;, ;o 3
Qi'< ~~ | 1;L | LI | 12- | LI | 12 | 1.2

l

-c | ~ | ( | )
2
AW\8 ~e | 00e =. ;JeC.M+ -mdoz | = óL. ~ 0,05 -+- I. qOS-r1 | ~ | fr4035
C8'>e""-Á- | | | 5
.iMo == 00. e
Me
~
(R+L)Mmij -r rlb~..l | MJv\8-~X0. LcO'>e -k7u1-lc | úJ\f) - C 7(çrb.~ | 9-.::: Já e
~ | ~ | 2

1D, 3C05. Aw e T LI4,~4S):ÂjY1G -o2{;C(). ti8 G8\f)- 1Q)O -;(A CB\8 - D,5C 'iA e.". Já.e

1O/3CDS '91-4411058 | - 02fXXJ.e-5OJ G -0,02'5 C G=:4,10359
-dLI4:5,558-0,oi..'JC8=Lf,103Sê | '
| | | | | | ;(e~L-!:iIY1e",LG
L-f,10B5.6+o,oZ'?c. ê -t02LILI5,~6e =:0 {...cLj,1035) | n& | XA =1.. jYmG~ L fi
G+ o,Oé09é -t5CJS(Cf60ge =0 | | | | ~
2 | 0
~
el xg = LEi =>x.q",o,'SG
(~. | .

### tGfI= o,s.e

., | ,
e -I 'i\06Q0 | e + Sq'5,%0 Z,e ::=0
corf\ Pé\r"<9ndo | <0/
" | 'i" | '

.;'
e + .2 ,,:;>(j)1JG +-uJlJ ,e ::: o

--lemos/
u;,./-~ | 505/1668
r--- - | )
uJrJ ==
liS9S,Cjé6'i5 | -::::D2Lf,41 ~(/>

V== 1 $n

(

X(;f)
)

'

~ -L .1,
(

1C\:)
)
~ | 01 cZ2C1
11 | ';A}-r1i'Pp) | ~ | 4'0
, | ,
fi" | _1~1 | . | o:? | "
r:L V..:: <>2lT"",- -) V1-t; | :: c21Tc; | -> 1-éj | :=-J02Tr

)

| | | | .L.
~

V

1-e;.z1 | 1) | l D
1~~.,z:= 7fScQ,g1 | -> 1-Ç;o:?= "f<5D2,g1G..z

Gol

:ró~ '31t;~ | t;o(::=-!L-=;> S<", | 1
>
| | | 1; ==o, 050

1'53/'61

0, 0605, C =- ,;z, &6.uJ rJ
C = de,036 | c)l'I,L.f1 | = 02'i;,íSb Ji00lh

0, 060Cj
;

= -S..=> Cc" ~ ..:: iZ-'6,'86

==

'ij0116i-
Cc | t; | o,C6b
Cc,,'601,6::t- JK-0(IA | ,

][ - ?0Jt., 'f'{'DJy'yCc.ÁJ'-'~ciduv ~

'[:C L

O

-k.x-" | -xv',
I

I
\~b~ I
-f:?:A \- ~A

I
F~
A\
:

L!Z\ &1

JRY
R)'- ')

I"
"" 1'0 T í e
ti | ;2 | --
<;,;; | .2-
.l. (-VV\A) /(A ~ 1-.0°68 | -ti | ;SOe 8
cZ | J-. | ;2
. J
(
o: | . 02- | "- 'iJ
.1 (-y'()~) 1t fi ~ | 1 J013+ eJoe). G | 7GA- L
o
c2 | 2. | - _8

c2
1(-vYlA)iA02=-~(3+1,1035).2.02i/ | ~ft | A | '
- | (;L | tJ ;::. ;2%A
~ | .
-yY\fL.L/ LlllO 35 ~ | 16//14 ~t(CO

1)
t

'

'M 1:1 -' e
G<-.< 1J\D..d
/w" | -
~G",-i

.t.V\o:::;O
F=A L ú&>8 -1( 7(1'1.1.: cs,9 | - JI! 71.B L ce;0 +-/'1eCZ( K T LL'>W\8 +- MB 9j-.b./\(;Y1 e = o
2 | ;;., | ~
FAch- )(/(111- - 4:7(8 L-t Me OO('RtL)G -t- M~ Cxh e", o
2 | 2

u~

tFt - 1..8~/ XB =Zlp,
tAl- - 1COO'XH-- MOG.?::!) -t 10f'658- -+ LILf,10 == o' | | 4-; -"L"
;l
FA == 1CCD7U\-f;;>QOO1L6- | 5Llj0S8 | (;,z )
-XÔ | 7Ul~L}WVIG=-L-.g
- | ~ | ;2 ,;:L
F A ~ c2CC0-rC.1"1T 'IQQ)XIO - ~os ,Y.8 | :g
| | | c c2XA;::. c2 '!tA
fA"" | lJCCú.j.. 'i$C:(:C- óI i '3/6) X/1
| | | L

..E!L::=. 91'6010(, ':::-Y\A
Xr:y

~1]
WfJ "'li!0 | .: ISlw1~ | =' ~LllH u'êC\-cJ/~
| ~y(\A | 110/lí
Cc = :; mA Wf\J =- 02 10,41 cQL[IL[ 1 ::: ~o 1/1L.j~

I-

C""~
| CC
Coe | s.Cc | ~O,036-'601,ILj | :=: Q'6'I'64~
h
