mferreiracosta/tcc_cefet/TCC 1/Referências Bibliográficas/1 - ARTIGOS/Identificação Motor CC/Modelagem Motor CC.pdf

## Universidade Federal do Rio Grande do Sul Escola de Engenharia Departamento de Engenharia Elétrica ENG04479 Robótica A

## Controle de Manipuladores

## Prof. Walter Fetter Lages 24 de novembro de 2005

## 1 Introdução

### 1. Controle de juntas

(a) Controle independente por junta
(b) Torque calculado
(c) Controle de tempo mínimo
(d) Controle por estrutura variável
(e) Controle não-linear desacoplado

### 2. Resolved motion control

(a) Resolved motion rate control
(b) Resolved motion acceleration control
(c) Resolved motion force control

### 3. Controle adaptativo

(a) Modelo-referência
(b) Self-tuning
(c) Adaptive perturbation control
(d) Resolved motion adaptive control

### 4. Controladores soft

(a) Redes neurais

1

(b) Lógica fuzzy
(c) Neuro-fuzzy
A figura 1 mostra um diagrama de blocos genérico de um sistema de controle de robôs manipuladores.

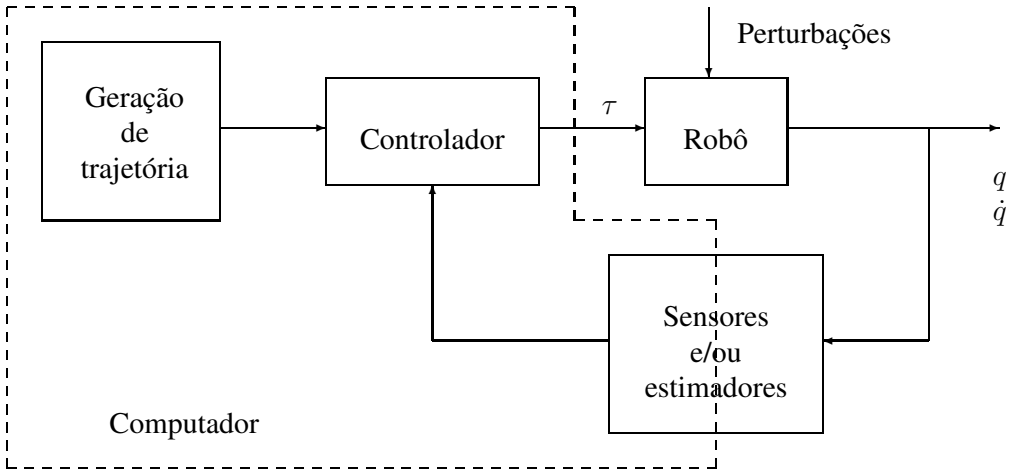
[picture p135: figure]
Geração de trajetória; Controlador; Robô; Sensores e/ou estimadores; Computador; Perturbações

Figura 1: Diagrama de blocos genérico de um sistema de controle de robô manipulador.

## 2 Controle Independente por Junta

O controle independente por junta consiste em considerar cada junta independente das demais para efeitos de controle. Ou seja, projeta-se um controlador para cada junta, ignorando os efeitos de acoplamento entre as juntas. A figura 2 mostra um diagrama de blocos de um controle independente por junta.
Para analisar o controle independente por junta é conveniente ter um modelo do sistema de uma junta.

### 2.1 Função de Transferência de uma Junta

A figura 3 mostra um esboço do sub-sistema mecânico de uma junta.
Supondo que não haja escorregamento no sistema de transmissão, pode-se escrever
dm = dl | (1)

2

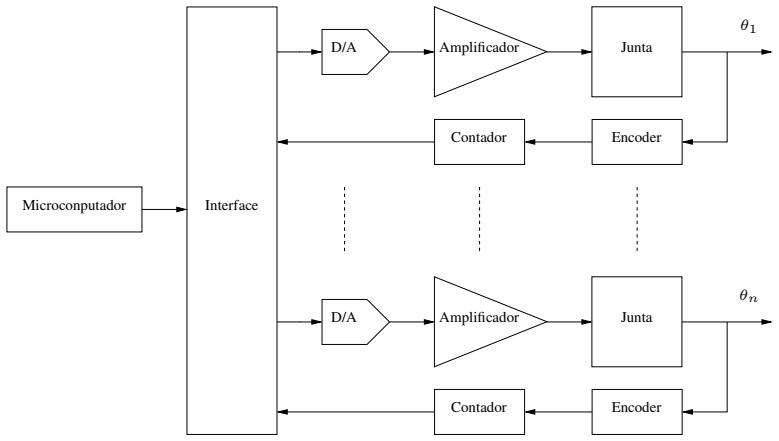
[picture p136: figure]
Microconputador; Amplificador; Junta; Contador; Encoder; Interface

Figura 2: Diagrama de blocos genérico de um controle independente por junta.

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
Figura 3: Esboço da mecânica de uma junta.

onde dm e dl são os deslocamentos lineares das engrenagens do lado do motor e do lado da carga, respectivamente.
Substituindo o raio (r) e o deslocamento angular (θ) de cada engrenagem em (1) obtém-se

rmθm = rlθl
e como o número de dentes de cada engrenagem é proporcional ao seu raio, tem-se

Nmθm = Nlθl
ou

Nm
Nl

=

θl
θm

= n < 1, tipicamente

logo, pode-se escrever também

θl | = nθm | (2)

3

˙θl | = n ˙θm | (3)
¨θl | = n¨θm | (4)
O torque produzido pelo atuador (τ ) deve vencer as perdas do lado do motor (por atrito com os mancais e inércia do rotor), representados por τm e o torque de reação da carga, τl

. Ou seja,

τ = τm + τ
| ∗ l

(5)
onde τ
∗
l

é τl refletido para o eixo do motor. As perdas do lado do motor são dadas por

τm = Jm

| ¨θm + fm
˙θm | (6)
onde Jm é o momento de inércia do rotor e fm é o atrito viscoso com os mancais. O torque de reação da carga é dado por

τl = Jl

| ¨θl + fl
˙θl | (7)
onde Jl é o momento de inércia da junta e fl é o atrito viscoso da junta.
À (7) poderia ser acrescentado ainda mais um termo, representando a elasticidade do sistema de transmissão, resultando

τl = Jl

¨θl + fl | ˙θl + Kl(θl − nθm) | (8)
onde Kl é a constante de mola.
No entanto, tipicamente o sistema de transmissão é suficiente rígido para que este termo adicional possa ser desprezado.
O princípio da conservação da energia permite escrever

τ

∗ l | θm = τlθl
ou

τ
∗

l =

τlθl
θm

= nτl
e portanto, de (3), (4) e (7):

τ
∗

l = n

2

Jl

¨θm + fl

˙θm
(9)
Assim, de (5) e (6), o torque será

τ =

Jm + n

2
Jl

¨θm +
fm + n

2
fl

˙θm

= Je

¨θm + fe

˙θm | (10)

4

onde
Je = Jm + n

2Jl é a inércia equivalente e
fe = fm + n

2

fl é o atrito viscoso equivalente. O torque (10) é produzido pelo atuador cujo diagrama elétrico é mostrado na figura 4.

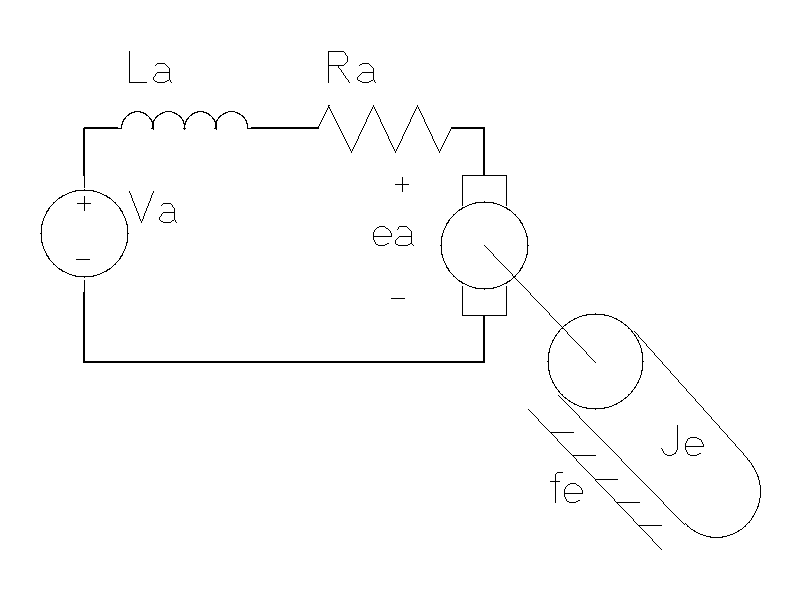
[picture p137: figure]

Figura 4: Diagrama elétrico do atuador de uma junta.

Tipicamente em manipuladores robóticos utilizam-se motores com imã permanente. Portanto, o torque produzido pelo atuador é

τ = KT ia | (11)
onde
KT é a constante de torque e
ia é a corrente de armadura.
A corrente de armadura está relacionada com a tensão aplicada por

va = Raia + La

dia
dt + ea | (12)

5

sendo
Ra a resistência de armadura;
La a indutância de armadura e
ea a força contra-eletro-motriz dada por

ea = Ka

˙θm | (13)
onde Ka é a constante de armadura do motor. Substituindo (13) em (12)

va = Raia + La

dia
dt + Ka
˙θm | (14)
Tomando-se a transformada de Laplace de (14) com condições iniciais nulas e resolvendo-se para Ia(s) resulta

Ia(s) =

va(s) − sKaΘm(s) Ra + sLa | (15)

e portanto, de (11)

T(s) = KT Ia(s) = KT

Va(s) − sKaΘm(s)
Ra + sLa

!
| (16)

Por outro lado, a transformada de Laplace de (10) é

T(s) = s

2

JeΘm(s) + sfeΘm(s) | (17)
Igualando-se (16) e (17) e resolvendo para

Θm(s)
Va(s)

tem-se

Θm(s)
Va(s)

=

KT
s [s

2JeLa + s(JeRa + Lafe) + Rafe + KT Ka]
Normalmente, a constante de tempo elétrica é muito menor do que a constante de tempo mecânica. Assim, pode-se desprezar L a , obtendo-se

Θm(s)
Va(s)

=

KT
s(sJeRa + Rafe + KT Ka)

=

K
s(Tms + 1) | (18)
com

K =

KT
Rafe + KT Ka

= constante de ganho

Tm =

RaJe
Rafe + KT Ka

= constante de tempo

De (18) e (2) tem-se

6

Θl(s)
Va(s)

=

nKT
s(sJeRa + Rafe + KT Ka)

(19)

A figura 5 mostra um diagrama de blocos da junta.

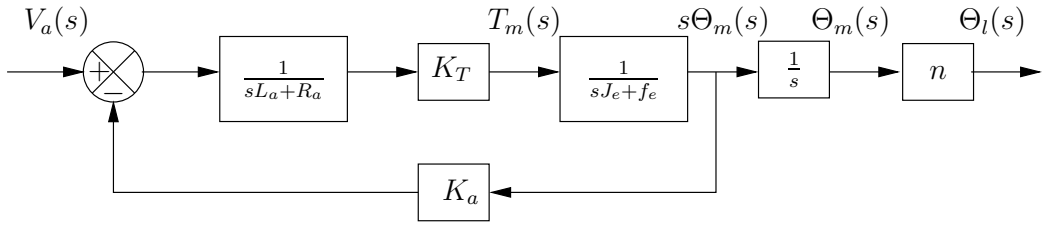
[picture p138: figure]
1 sLa+Ra; 1 sJe+fe; sΘm(s)

Figura 5: Diagrama de blocos da junta.

### 2.2 Controle de Posição de uma Única Junta

Supondo um controlador PD tem-se

va =

Kp

θ

d
l − θl
+ Kd

˙θ
d

l − ˙θl

n

va =

Kpe + Kde˙
n
ou

Va(s) =

Kp + sKd
n

E(s)
A figura 6 mostra o diagrama de blocos do controlador PD.

+
−

Kp + sKd

1
n

Θl(s)
Va(s)
Θ | E(s) | Va(s) | Θl(s)

d
l

(s)

Figura 6: Diagrama de blocos do controlador PD.

Θl(s)
E(s)

= G(s) =

KT (Kp + sKd)
s(sRaJe + Rafe + KT Ka)

7

Θl(s)
Θd
l

(s)

=

G(s)
1 + G(s)

=

sKT Kd + KT Kp
s

2RaJe + s(Rafe + KT Ka + KT Kd) + KT Kp

Θl(s)
Θd
l

(s)

=

N(s)
s

2 + 2ξωns + ω²
n
com

N(s) =

sKT Kd
RaJe

+ ω

2
n

ω

2
n =

KT Kp
RaJe

ξ =

1
2ωn

(Rafe + KT Ka + KT Kd)
RaJe
e obviamente escolhendo-se Kp e Kd pode-se determinar livremente ωn e ξ.
A figura 7 mostra a posição dos pólos de um sistema de segunda ordem no plano complexo e a sua relação com o coeficiente de amortecimento (ξ) e a frequência natural não amortecida (ωn).

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
1 − ξ

2
φ

ξ = cos(φ)

Figura 7: Posição dos pólos no plano complexo.

Na figura 8 tem-se a resposta temporal de um sistema de segunda ordem com
ωn = 30rad/s e ξ = 0.3.

### 2.3 Desempenho

Em geral, deseja-se que o robô tenha uma resposta criticamente amortecida. Para tanto

Kp =

ω

2
nJeRa
KT

> 0

8

Step Response

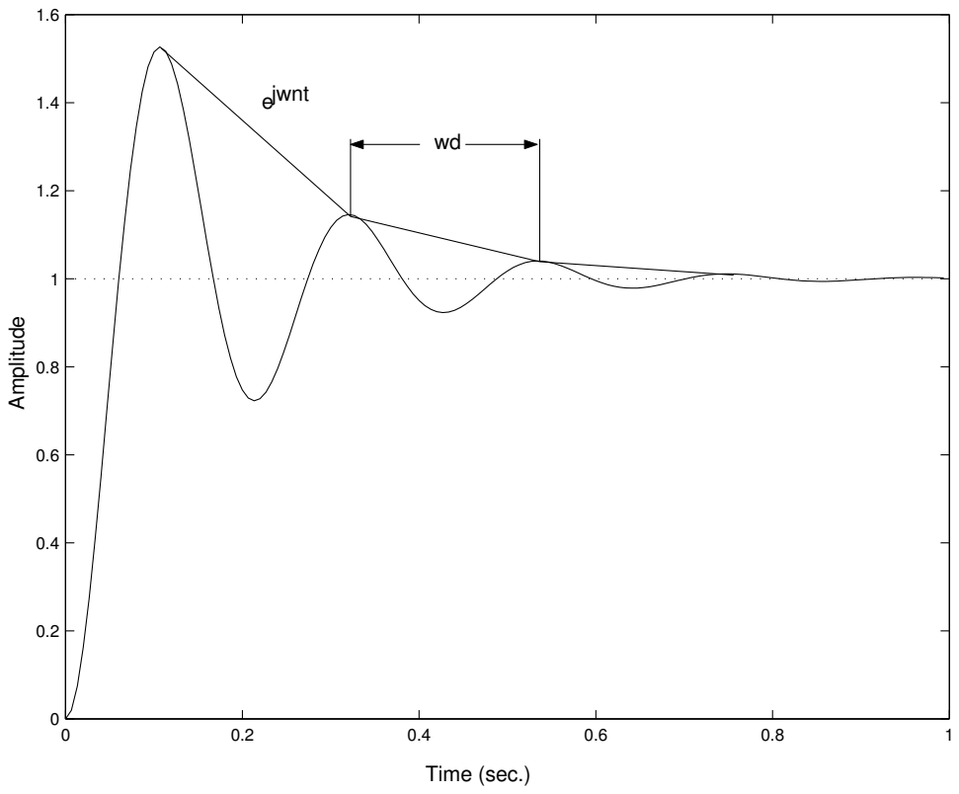
[picture p139: figure]
Time (sec.); Amplitude; e jwnt

Figura 8: Resposta típica de um sistema de segunda ordem.

ξ =

Rafe + KT Ka + KT Kd
2

q
KT KpJeRa

≥ 1

= 1 =⇒ criticamente amortecido

Kd =

2

q
KT KpJeRa − Rafe − KT Ka
KT

ωn ≤

1
2

ωr
onde ωr é a frequência de ressonância estrutural

Je

¨θm + fe

˙θm + Ksθm = 0

9

s

2Θm(s) +

fe
Je

sΘm(s) +

Ks
Je

Θm(s) = 0

ωr =

s
Ks
Je

0 < Kp ≤

ω

2
rJeRa
4KT

Kd ≥

Raωr − Rafe − KT Ka
KT

## 3 Torque Calculado

τ = Mn(q)

h
q¨

d + Kd

q˙

d − q˙

+ Kp
q

d − q

i + Vn(q, q˙) + Gn(q) (20)

M(q)q¨+ V (q, q˙) + G(q) = Mn(q)

h
q¨

d + Kd

q˙

d − q˙

+ Kp
q

d − q

i

+ Vn(q, q˙) + Gn(q)

Supondo que M(q) = Mn(q), V (q, q˙) = Vn(q, q˙) e G(q) = Gn(q):

M(q)[e¨+ Kde˙ + Kpe] = 0

e¨+ Kde˙ + Kpe = 0
Portanto, pode-se determinar Kd e Kp de forma que e(t) −→ 0 assintoticamente.
A expressão (20) pode ser calculada por Newton-Euler fazendo-se

q¨i = q¨

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
j − q˙j
+

Xn

j=1

Kij
p
q

d
j − qj

A figura 9 mostra um diagrama de blocos do controle por torque calculado. Note que é um esquema de linearização por realimentação onde a qualidade da linearização depende do casamento entre os parâmetros do modelo e os parâmetros reais.

10

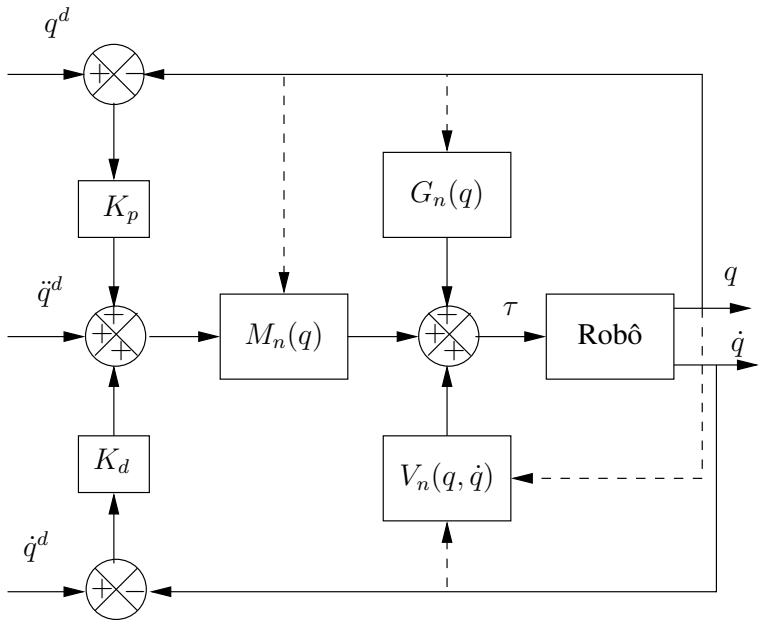
[picture p140: figure]
Robô

Figura 9: Diagrama de blocos do controle por torque calculado.

## 4 Resolved Motion Control

- Controle no espaço cartesiano
- Resolved motion =⇒ o movimento de todas as juntas é combinado e "resolvido"em movimentos da garra controláveis separadamente nas coordenadas cartesianas
- Trajetória especificada (referência) no espaço das cartesiano
- Atuação no espaço das juntas

baseRgarra =

Cγ | −Sγ | 0
Sγ | Cγ | 0
0 | 0 | 1
Cβ | 0 Sβ
0 | 1 0
−Sβ | 0 Cβ
1 0 | 0
0 Cα | −Sα
0 Sα | Cα

=

CγCβ | −SγCα + CγSβSα | SγSα + CγSβCα
SγCβ | CγCα + SγSβSα | −CγSα + SγSβCα
−Sβ | CβSα | CβCα

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
= J(q)q˙

Se o jacobiano for inversível (caso típico em robôs com 6 graus de liberdade), pode-se escrever

q˙ = J

−1
(q)

"
V
Ω
(21)

portanto, as acelerações serão
"

V˙
Ω˙
= J˙(q, q˙)q˙ + J(q)q¨ | (22)

Substituindo-se (21) em (22) tem-se
"

V˙
Ω˙
= J˙(q, q˙)J
−1
(q)

"
V
Ω
+ J(q)q¨
de onde pode-se obter uma forma de calcular as velocidades e acelerações das juntas em função das velocidades e acelerações cartesianas.

q¨ = J

−1
(q)

"

V˙
Ω˙
− J

−1

(q)J˙(q, q˙)J
−1
(q)

"
V
Ω
(23)

### 4.1 Resolved Motion Rate Control

As juntas movem-se de modo a manter um movimento de regime da garra.

x = f(q)

x =

Px
Py
Pz
α
β
γ

x˙ =

"
V
Ω
= J(q)q˙

12

q˙ = J

−1
(q)x˙
A figura 10 mostra um diagrama de blocos do resolved motion rate control.

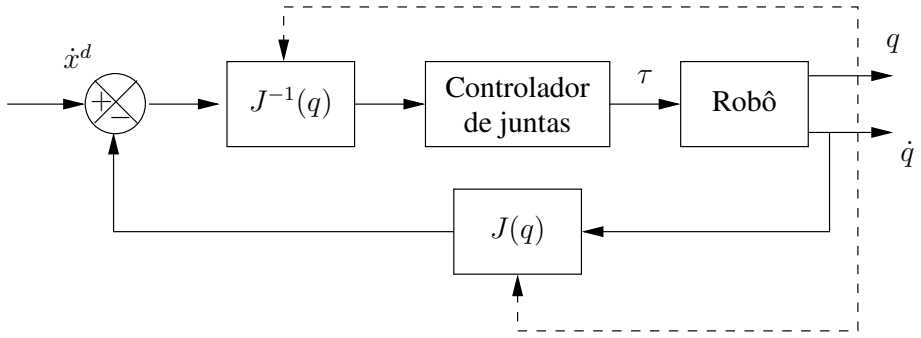
[picture p141: figure]
Robô Controlador de juntas

Figura 10: Diagrama de blocos do resolved motion rate control.

Pode-se também desejar manter constate as velocidades no sistema da garra e não no sistema da base. Neste caso

x˙ =

0Rgg˙ =⇒ q˙ = J

−1
(q)

0Rgg˙

### 4.2 Resolved Motion Acceleration Control

H =

"
n s a p
0 0 0 1

H

d =

"
n

d
s
| d | a d | p d
0 | 0 | 0 | 1

ep = p

d − p

eo =

1
2

h
n × n

d + s × s

d + a × a

d

i

x˙ =

"
V
Ω
= J(q)q˙
x¨ = J(q)q¨+ J˙(q, q˙)q˙ | (24)
Definindo-se

13

e =

"
ep
eo

e se for possível fazer

x¨ = x¨

d + Kd

x˙

d − x

+ Kpe | (25)
tem-se

e¨+ Kde˙ + Kpe = 0
que pode ter a sua dinâmica arbitrariamente determinada ajustando-se os valores Kp e Kd. Resta, portanto, garantir que (25) seja satisfeita. De (24) e (25) pode-se garantir isto fazendo-se

q¨ = J

−1
(q)

h
x¨

d + Kd

x˙

d − x˙

+ Kpe − J˙(q, q˙)q˙

i

= −Kdq˙ + J

−1
(q)

h
x¨

d + Kdx˙

d + Kpe − J˙(q, q˙)q˙

i
(26)

Pode-se, então, utilizar, por exemplo, o formalismo de Newton-Euler para calcular os torques que precisam ser aplicados nas juntas para forçar a aceleração computada por (26). A figura 11 mostra um diagrama de blocos do resolved motion acceleration control.

### 4.3 Resolved Motion Force Control

- Determina os torques necessários para realizar um movimento cartesiano
- não utiliza o modelo dinâmico e compensa variações de configuração e gravidade
- Necessita de um sensor de força na garra
- O controle de posição determina os torques necessários na garra para que uma certa trajetória seja rastreada
- O controle de força convergente determina os torques nas juntas para que os torques na garra sejam os desejados

τ = J

T
(q)F

14

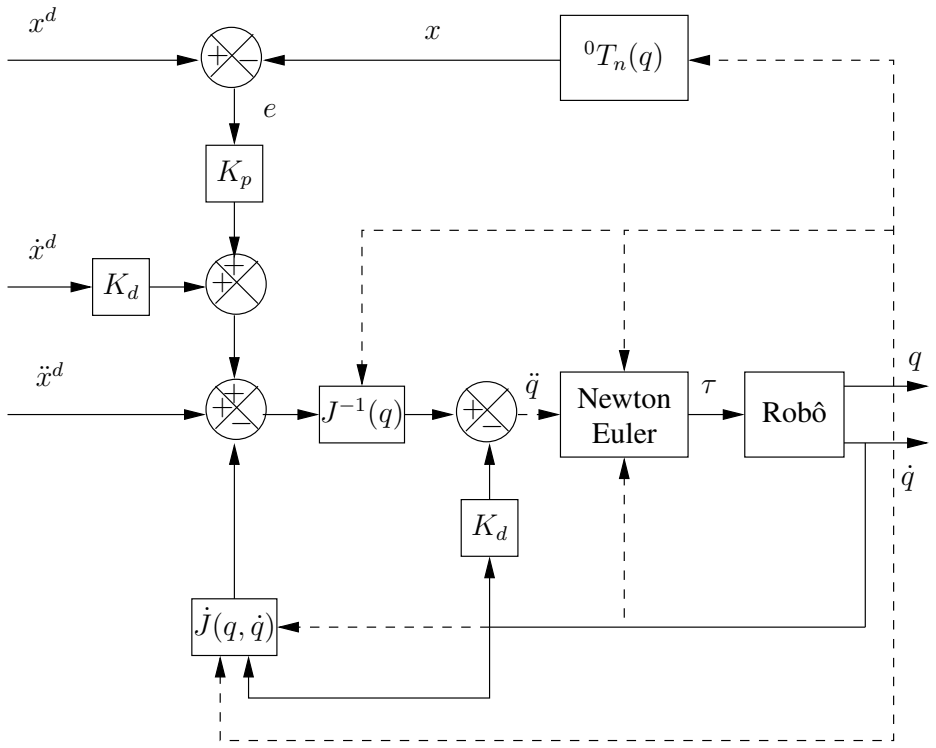
[picture p142: figure]
Robô Newton Euler

Figura 11: Diagrama de blocos do resolved motion acceleration control.

F =

Fx
Fy
Fz
τx
τy
τz
De forma semelhante a seção 4.2, se for possível fazer com que

x¨ = x¨

d + Kd

x˙

d − x˙

+ Kpe | (27)
tem-se

e¨+ Kde˙ + Kpe = 0
que, da mesma forma, pode ter a sua dinâmica arbitrariamente determinada ajustando-se os valores Kp e Kd. No entanto, aqui, satisfaz-se (27) garantido que a força na garra seja dada por

15

F

d = Mx¨ | (28)
Por sua vez, (28) é garantida fazendo-se com que o torque aplicado nas juntas seja dado por

τ = J

T
(q)F

d = J

T

(q)Mx¨ | (29)
onde M é a matriz de inércia da carga, dada por

M =

"
mI3×3 | 0
0 | I

sendo I3×3 a matriz identidade 3 × 3 e I o tensor de inércia da carga.
As expressões (27) e (29) descrevem o laço de de posição do resolved motion force control, como mostrado na figura 12.

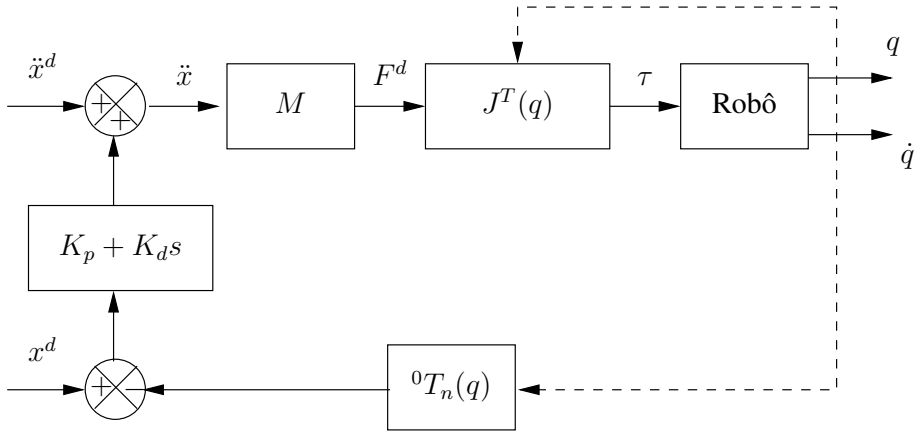
[picture p143: figure]
Robô +; Kp + Kds

Figura 12: Diagrama de blocos do laço de posição do resolved motion force control.

A lei de controle descrita por (27) e (29) funciona bem se M for desprezível em comparação com a inércia do manipulador em sí. No caso geral, parte do torque (29) é gasta com o próprio manipulador. Para compensar isto, é utilizado o controle de força convergente. Este método consiste em fazer-se aproximações da forma

∆F(k) = F

d
(k) − Fo(k)

Fa(k + 1) = Fa(k) + γk∆F(k)

16

γk =

1
k+1 , k = 0, 1, 2, ...N
com Fa(0) = Fo. Tipicamente N = 2 é suficiente.
A figura 13 mostra um diagrama de blocos completo do resolved motion force control, incluindo o controle de posição e o controle de força convergente.

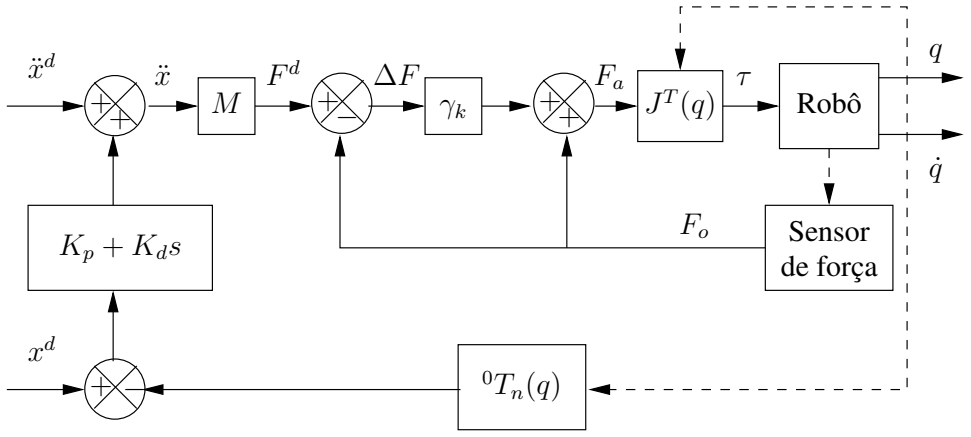
[picture p144: figure]
Kp + Kds; Robô T +; Sensor de força

Figura 13: Diagrama de blocos completo do resolved motion force control.

## 5 Controle de Perturbação Adaptativo

Técnicas avançadas de controle de manipuladores, como Torque Calculado e outras necessitam do uso do modelo dinâmico do robô. Embora a estrutura do modelo seja bem conhecida, os parâmetros não o são, pois variam em função da carga do manipulador, envelhecimento, temperatura, condições de lubrificação, etc. Utilizando-se controle adaptativo procura-se compensar as variações nestes parâmetros.
Tipicamente, estratégias de controle adaptativo consistem na combinação de um método de controle com um método de identificação de parâmetros [2]. No entanto, como o manipulador é um sistema não linear dinamicamente complexo, a tentativa de obter-se um modelo através de identificação direta provavelmente não teria sucesso. Mas, considerando-se que o modelo nominal aproxima relativamente bem a dinâmica real do manipulador, pode-se tentar obter um modelo para o erro entre o modelo e a planta real e utilizar esta informação na malha de controle. Desta forma, o controlador passa a ter a capacidade de acomodar diferenças entre o modelo nominal e a dinâmica real do manipulador.

17

### 5.1 Modelo de perturbação

Embora um manipulador seja um sistema não linear, é possível obter-se um modelo linearizado em torno de um ponto de operação utilizando-se uma compensação do tipo feedforward.
Supondo que o torque aplicado ao robô real seja τ e que o estado do sistema seja x e que o modelo nominal tem como entrada τ
d

e estado x
d

, pode-se imaginar
um sistema, denominado sistema de perturbação, cuja entrada é δτ = τ − τ
d

e
cujo estado é δx = x − x
d

, como mostrado na figura 14.

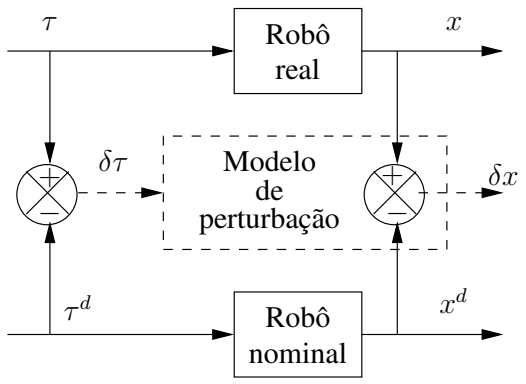
[picture p145: figure]
real; Robô; nominal; Modelo; de perturbação

Figura 14: Modelo de perturbação.

Supondo que a dinâmica da planta seja dada por

x˙ = f(x, τ ) | (30)
os torques nominais podem ser calculados, por exemplo, por Newton-Euler e satisfazem

x˙

d = f(x

d
, τ

d

) | (31)
Expandindo (30) em série de Taylor em torno de (x
d
, τ

d

) chega-se à

x˙ = f(x

d
, τ

d
)+

∂f(x, τ )
∂x

x = x

d
τ = τ

d

(x−x

d
)+

∂f(x, τ )
∂τ

x = x

d
τ = τ

d

(τ −τ

d
)+O(2)

(32)
Subtraindo (31) de (32) e desprezando-se os termos de ordem superior, chega-se à

18

δx˙ =

∂f(x, τ )
∂x

x = x

d
τ = τ

d

δx +

∂f(x, τ )
∂τ

x = x

d
τ = τ

d

δτ

= A(t)δx + B(t)δτ | (33)

Com esta formulação, o problema de controle do manipulador é reduzido ao problema de determinar δτ que leva δx para zero em todos os instantes ao longo da trajetória do manipulador. A lei de controle é então formada por dois componentes: um componente em feedforward, que calcula os torque nominais τ
| d
(através das equações de Newton-Euler) e um componente em feedback, que calcula os torques de perturbação δτ que procuram compensar os pequenos desvios em relação à trajetória nominal, como mostrado na figura 15.

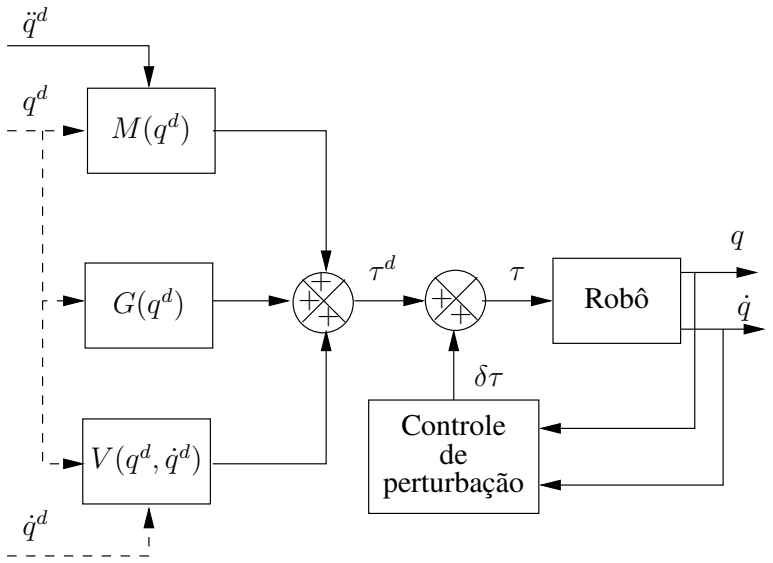
[picture p146: figure]
Robô +; Controle; perturbação

Figura 15: Controle de perturbação.

Os parâmetros A(t) e B(t) dependem da posição e velocidade instantâneas do manipulador e portanto variam lentamente com o tempo. Devido à complexidade dinâmica dos manipuladores em geral, é bastante difícil a sua determinação analítica. Além disto, dependem dos mesmo parâmetros que o modelo dinâmico e que portanto são desconhecidos (ao menos parcialmente). Assim, torna-se conveniente que A(t) e B(t) sejam identificados em tempo real.

19

### 5.2 Identificação Paramétrica

Para implementação em computadores digitais, é conveniente que (33) seja discretizada, de forma a obter-se um modelo linear discreto, apropriado para identificação paramétrica. Assim, discretizando-se (33) com um período de amostragem T, obtém-se

x(k + 1) = F(k)x(k) + G(k)u(k) | (34)

onde F(k) ∼= A(kT), G(k) ∼= B(kT), x(k) ∼= δx(kT), u(k) ∼= δτ (kT).
Para fim de estimação, é conveniente "empilhar"F(k) e G(k) e x(k) e u(k):

θi(k) =

fi1(k)
fi2(k)
fin(k)
gi1(k)
gi2(k)
gim(k)

φ(k) =

x1(k)
x2(k)
xn(k)
u1(k)
u2(k)
um(k)
Pode-se, portanto, escrever (34) como

xi(k + 1) = φ

T
(k)θi(k)
ou

xi(k + 1) = Θ

T
(k)φ(k)
onde Θ(k) =

h
θ1(k) θ2(k) · · · θn(k)

i
é a matriz de parâmetros desconhecidos e φ(k) é o vetor de regressão linear.
Como os parâmetros θi(k)são desconhecidos, deseja-se obter estimativas ˆθi(k) que minimizem o critério

20

Ji(k, θi) =

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
onde ei(j) é o erro de estimação dado por

ei(k) = xi(k + 1) − φ

T
(k)

ˆθi(k)
e ρ é o coeficiente de esquecimento utilizado para ponderar a importância dos erros recentes em relação aos erros ocorridos há mais tempo. Usualmente, tem-se
0.9 < ρ ≤ 1.0.
Mais formalmente, tem-se

ˆθi(k) = Arg min Ji(k, θi) θi

(35)

que pode ser escrita na forma

ˆθi(k) = Arg min (Xi(k) − Φ(k)θi(k))T (Xi(k) − Φ(k)θi(k))
θi
com

Xi(k) =

xi(1)
xi(2)
xi(k + 1)
e

Φ(k) =

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
Assim, (35) pode ser resolvida fazendo-se

∂Ji(k, θi)
∂θi

= 0 = −2ΦT

(k)Xi(k) + 2ΦT
(k)Φ(k)

ˆθi(k)

Logo

ˆθi(k) =
Φ

T
(k)Φ(k)

−1
Φ

T
(k)Xi(k)
Definindo

21

P(k) =

Φ

T
(k)Φ(k)

−1
=

X

k

j=0

φ(j)φ

T
(j)

−1

tem-se

ˆθi(k) = P(k)
X

k

j=0

φ(j)xi(j + 1) | (36)

e

P

−1
(k) =

X

k

j=0

φ(j)φ

T
(j)

=

k

X−1

j=0

φ(j)φ

T
(j) + φ(k)φ

T
(k)

= P

−1
(k − 1) + φ(k)φ

T
(k)
Utlizando-se o Lema de Inversão de Matrizes com A = P
−1

(k−1), B = φ(k),
C = 1 e d = φ
T

(k), pode-se calcular

P(k) =

P

−1
(k − 1) + φ(k)φ

T
(k)

−1

= P(k − 1) − P(k − 1)φ(k)

φ

T
(k)P(k − 1)φ(k) + 1

−1
φ

T
(k)P(k − 1)
ou

P(k) = P(k − 1) −

P(k − 1)φ(k)φ

T
(k)P(k − 1)
1 + φ

T (k)P(k − 1)φ(k)
De (36) tem-se

ˆθi(k) = P(k)
X

k

j=0

φ(j)xi(j + 1)

= P(k)

k

X−1

j=0

φ(j)xi(j + 1) + φ(k)xi(k + 1)

=

P(k − 1) −

P(k − 1)φ(k)φ

T
(k)P(k − 1)
1 + φ

T (k)P(k − 1)φ(k)

!

k

X−1

j=0

φ(j)xi(j + 1) + φ(k)xi(k + 1)

e expandindo-se o produto resulta

22

ˆθi(k) = P(k − 1)

k

X−1

j=0

φ(j)xi(j + 1) + P(k − 1)φ(k)xi(k + 1)

−

P(k − 1)φ(k)φ

T
(k)P(k − 1)
1 + φ

T (k)P(k − 1)φ(k)

k

X−1

j=0

φ(j)xi(j + 1)

−

P(k − 1)φ(k)φ

T
(k)P(k − 1)
1 + φ

T (k)P(k − 1)φ(k)

φ(k)xi(k + 1)

Substituindo-se (36), chega-se a:

ˆθi(k) = ˆθi(k − 1) + P(k − 1)φ(k)xi(k + 1)
−

P(k − 1)φ(k)φ

T
(k)
1 + φ

T (k)P(k − 1)φ(k)

ˆθi(k − 1)

−

P(k − 1)φ(k)φ

T
(k)P(k − 1)
1 + φ

T (k)P(k − 1)φ(k)

φ(k)xi(k + 1)

e agrupando-se os temos em φ(k)xi(k + 1) tem-se

ˆθi(k) = ˆθi(k − 1) +

+

P(k − 1) + P(k − 1)φ

T
(k)P(k − 1)φ(k) − P(k − 1)φ(k)φ

T
(k)P(k − 1)
1 + φ

T (k)P(k − 1)φ(k)

φ(k)xi(k + 1)

−

P(k − 1)φ(k)φ

T
(k)
1 + φ

T (k)P(k − 1)φ(k)

ˆθi(k − 1)

ou

ˆθi(k) = ˆθi(k − 1) +

P(k − 1)
1 + φT (k)P(k − 1)φ(k)

φ(k)xi(k + 1)

−

P(k − 1)φ(k)φ

T
(k)
1 + φ

T (k)P(k − 1)φ(k)

ˆθi(k − 1)

que pode ser reescrita como

ˆθi(k) = ˆθi(k − 1) +

P(k − 1)φ(k)
1 + φ

T (k)P(k − 1)φ(k)

xi(k + 1) − φ

T
(k)

ˆθi(k)

Portanto, a solução para o problema (35) pode ser obtida de forma recursiva através de

23

ˆθi(k + 1) = ˆθi(k) +

P(k)φ(k)
ρ + φ

T (k)P(k)φ(k)

xi(k + 1) − φ

T
(k)

ˆθi(k)

P(k + 1) = P(k) −

P(k)φ(k)φ

T
(k)P(k)
ρ + φT (k)P(k)φ(k)
onde P(k) é a matriz de covariância do erro de estimação.

### 5.3 Lei de Controle

Com a determinação dos parâmetros F(k) e G(k), uma lei de controle ótimo pode ser implementada. Para tanto, pode-se utilizar a seguinte função custo

J(k) =

1
2

x

T
(k + 1)Qx(k + 1) +

1
2

u

T
(k)Ru(k)
Esta função custo one-step ahead indica que o objetivo do controle ótimo representa um compromisso entre levar instantaneamente os erros de posição e velocidade sobre a trajetória nominal para zero, ao mesmo tempo em que limita a energia de controle.
O controle ótimo é, então determinado por

u
∗
(k) = Arg min J(k)
u(k)

(37)
Substituindo (34) em (37) resulta

J(k) =

1
2

h
(F(k)x(k) + G(k)u(k))T Q (F(k)x(k) + G(k)u(k)) + u
T
(k)Ru(k)

i

Fazendo ∂J(k)
∂u(k)
u(k)=u∗(k)

= 0 tem-se

G

T
(k)Q (F(k)x(k) + G(k)u

∗
(k))+(F(k)x(k) + G(k)u

∗
(k)) QG(k)+u

∗
(k)R = 0
ou, considerando que Q e R são simétricas¹ :

G

T
(k)F(k)x(k) +
G

T
(k)QG(k) + R
u
∗
(k) = 0
e portanto

u
∗
(k) = −
G

T
(k)QG(k) + R

−1
G(k)F(k)x(k)
A figura 16 mostra um diagrama de blocos completo do controle de perturbação adaptativo.
1Se M for simétrica tem-se Mv = v
T M

24

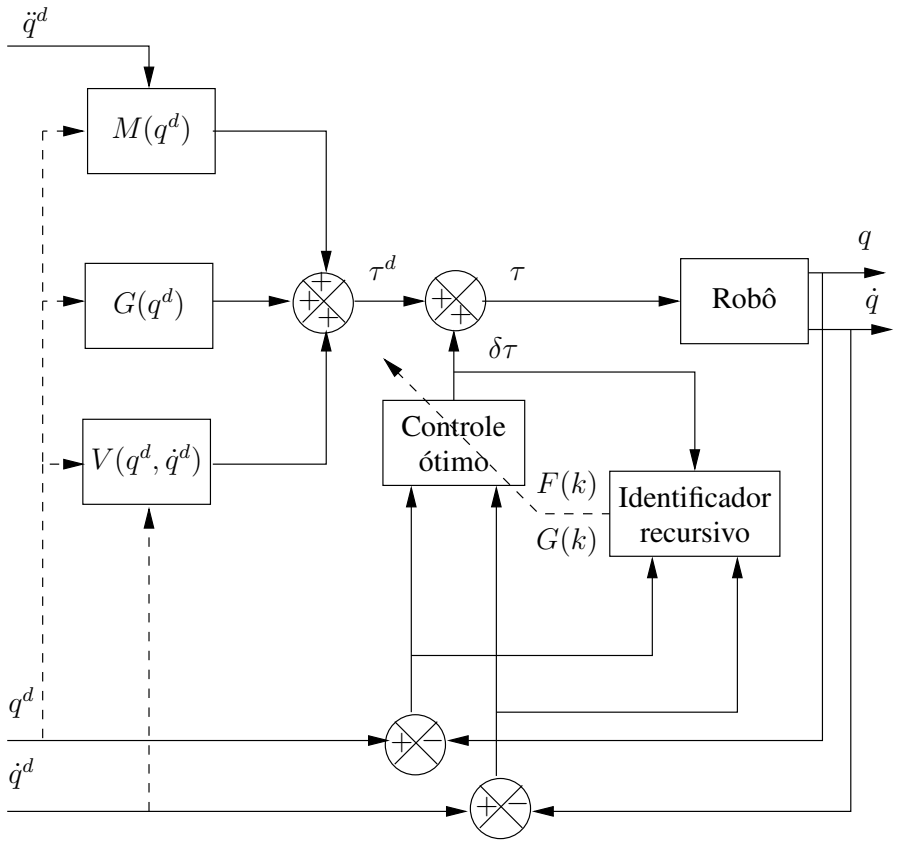
[picture p147: figure]
Controle ótimo; Robô; Identificador recursivo

Figura 16: Controle de perturbação adaptativo.

## Referências

[1] L. A. Aguirre. Introdução à Identificação de Sistemas: Técnicas Lineares e Não Lineares Aplicadas a Sistemas Reais. Editora UFMG, Belo Horizonte, MG, 2000.
[2] G. C. Goodwin and K. S. Sin. Adaptive Filtering, Prediction and Control. Prentice-Hall Information and System Sciences Series. Prentice-Hall, Inc., Englewood Cliffs, NJ, 1984.

## A Função de Transferência de Malha Fechada

A figura 17 mostra um sistema de controle em malha fechada.

25

+
−

G(s)

H(s)

R(s) | E(s) | Y (s)

Figura 17: Sistema de controle com realimentação.

E(s) = R(s) − H(s)Y (s)

Y (s) = G(s)E(s) =⇒ E(s) =

Y (s)
G(s)

H(s)Y (s) +

Y (s)
G(s)

= R(s)

Y (s)
R(s)

=

G(s)
1 + G(s)H(s)

## B Lema de Inversão de Matrizes

Lema 1 (Lema de Inversão de Matrizes[1]) Sejam A, B, C e D matrizes tais que A, C e (A + BCD) sejam inversíveis, então

(A + BCD)

−1 = A

−1 − A

−1B

C

−1 + DA

−1B

−1
DA

−1

(38)

Prova 1 Pré-multiplicando-se ambos os lados de (38) por (A + BCD) tem-se:

(A+BCD)(A+BCD)

−1 = (A+BCD)A

−1−(A+BCD)A

−1B

C

−1 + DA

−1B

−1
DA

−1

I = I + BCDA

−1 −

I + BCDA

−1

B
C

−1 + DA

−1B

−1
DA

−1

I = I + BCDA

−1 −

B + BCDA

−1B

C

−1 + DA

−1B

−1
DA

−1
Colocando-se BC em evidência no terceiro termo, tem-se

26

I = I + BCDA

−1 − BC

C

−1 + DA

−1B

C

−1 + DA

−1B

−1
DA

−1

I = I + BCDA

−1 − BCDA

−1
e portanto

I = I

## C Exercícios

### 1. Seja um sistema eletromecânico como da figura 3 com os parâmetros:

n = 0.1
La | = 0
Ra | = 0.2Ω
Ka | = 0.06V/rad/s
KT | = 10 × 10⁻⁵ kgm/A
Jm | = 1.67 × 10⁻⁵ kgm/rad/s²
fm | = 0
Jl | = 7.33 × 10⁻³ kgm/rad/s²
fl | = 6.67 × 10⁻² kgm/rad/s
(a) O obtenha a função de transferência Gp(s) = Θl(s)/Va(s).
(b) O obtenha a função de transferência Gv(s) = Ωl(s)/Va(s).

### 2. Simule a resposta ao degrau do sistema Gv(s)

3. Projete um controlador de posição para o sistema.

### 4. Simule a resposta do sistema em malha fechada para uma referência tipo

degrau.

27
