mferreiracosta/tcc_cefet/Circuito Eletrônico/circuito_eletronico.png

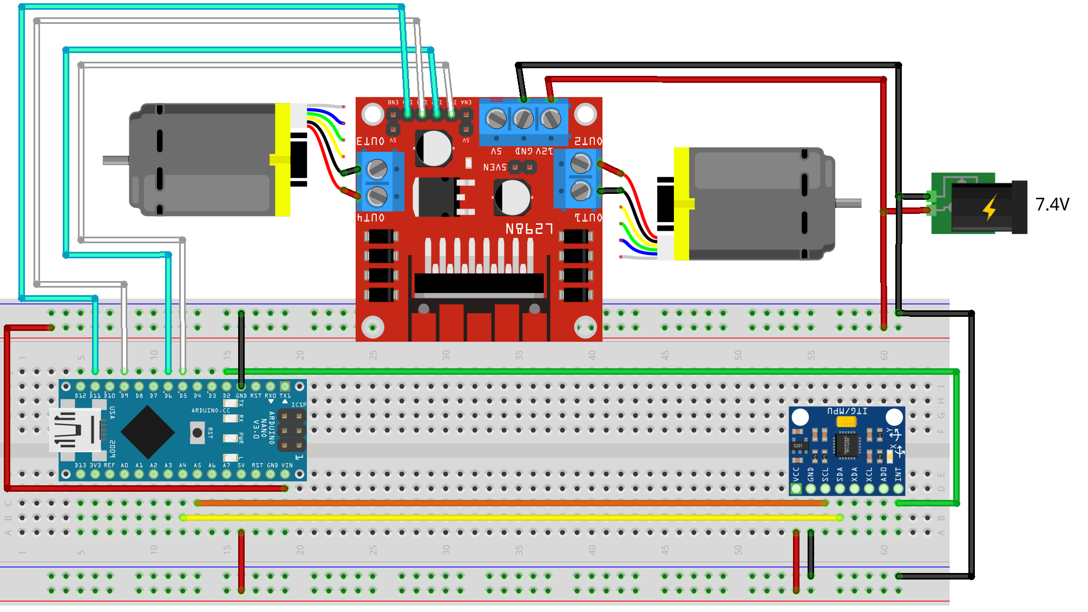
Circuito Eletrônico/circuito_eletronico.png
