mferreiracosta/tcc_cefet/Códigos/Filtro Complementar/Figuras/ArranjoFinal_MPU_Filtro.PNG

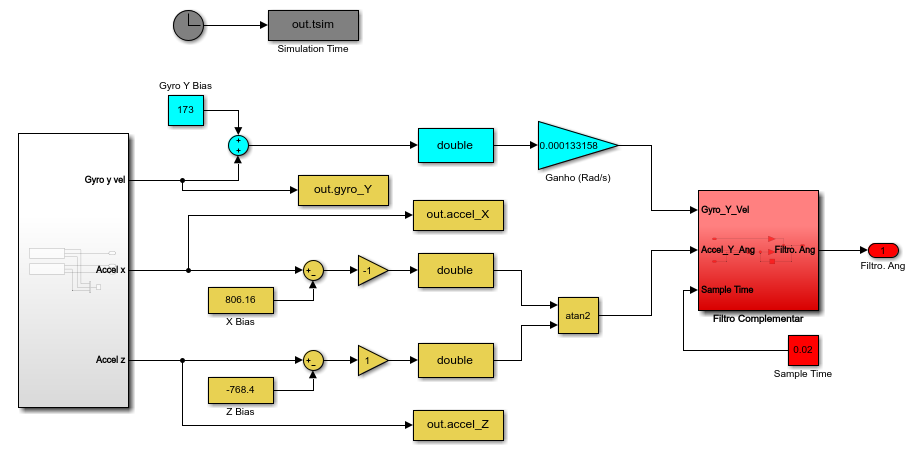
Códigos/Filtro Complementar/Figuras/ArranjoFinal_MPU_Filtro.PNG
