mferreiracosta/tcc_cefet/Códigos/Filtro Complementar/Figuras/FiltroComplementar.PNG

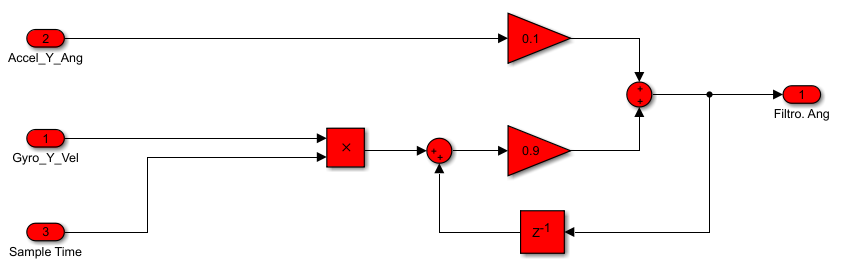
Códigos/Filtro Complementar/Figuras/FiltroComplementar.PNG
