mferreiracosta/tcc_cefet/Latex/EstadoArte/REF3_1.PNG

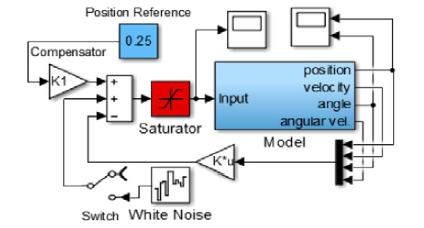
Latex/EstadoArte/REF3_1.PNG
