mferreiracosta/tcc_cefet/Latex/Fundamentos/M_Motor.png

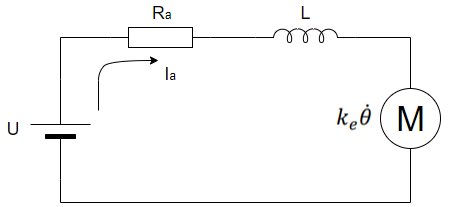
Latex/Fundamentos/M_Motor.png
