mferreiracosta/tcc_cefet/Latex/Metodologia/arduinoNano.png

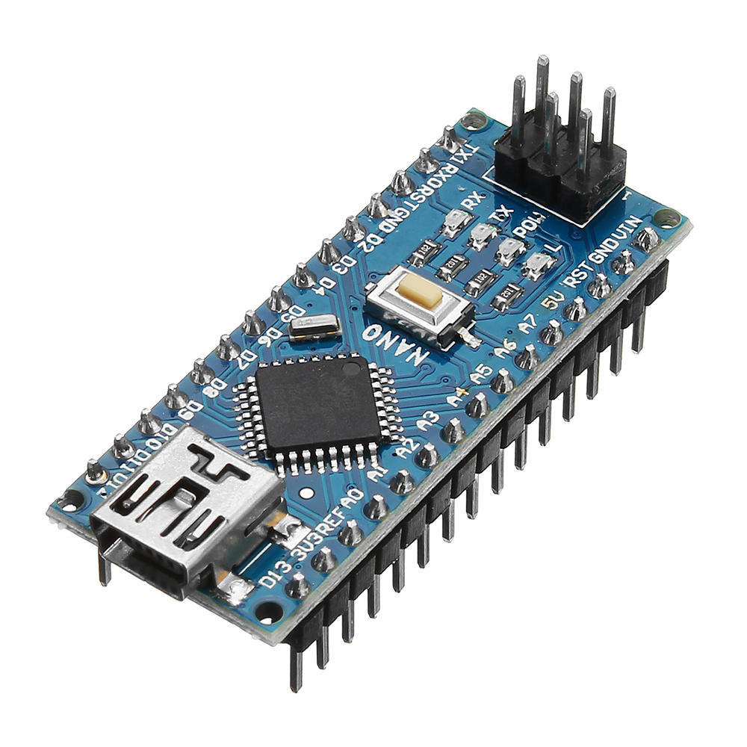
Latex/Metodologia/arduinoNano.png
