mferreiracosta/tcc_cefet/Latex/Metodologia/Pendulo_3D.PNG

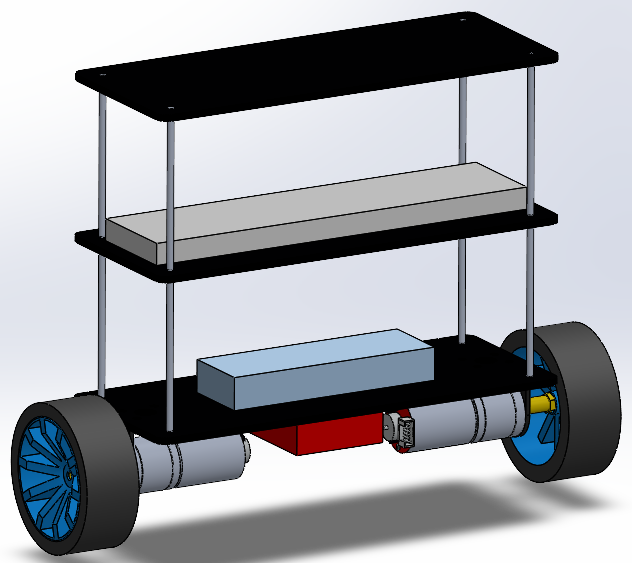
Latex/Metodologia/Pendulo_3D.PNG
