mferreiracosta/tcc_cefet/Latex/Modelagem/Circuito_MotorDC.png

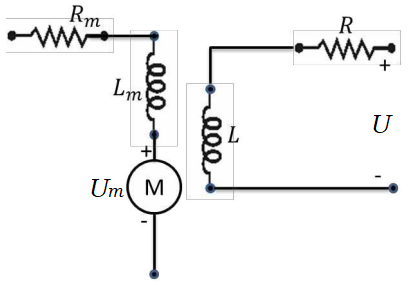
Latex/Modelagem/Circuito_MotorDC.png
