mferreiracosta/tcc_cefet/Latex/Modelagem/ModeloCorpo.PNG

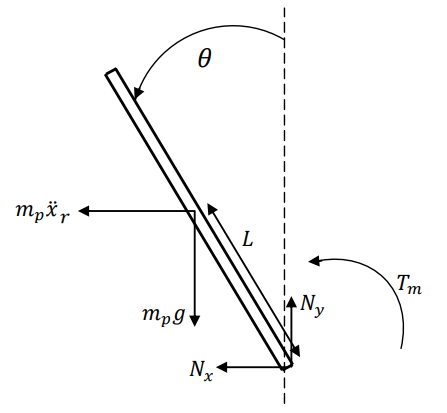
Latex/Modelagem/ModeloCorpo.PNG
