mferreiracosta/tcc_cefet/Latex/Modelagem/ModeloRoda.PNG

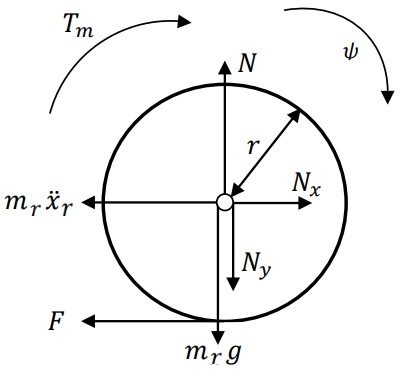
Latex/Modelagem/ModeloRoda.PNG
