mferreiracosta/tcc_cefet/Latex/Modelagem/ModeloSegway.png

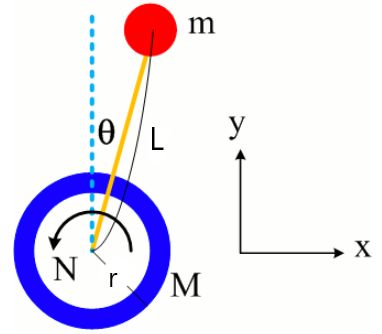
Latex/Modelagem/ModeloSegway.png
