mferreiracosta/tcc_cefet/Latex/Modelagem/RepresentacaoPendulo.png

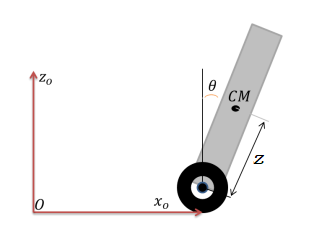
Latex/Modelagem/RepresentacaoPendulo.png
