mferreiracosta/tcc_cefet/Latex/ProjControladores/lqg_control.png

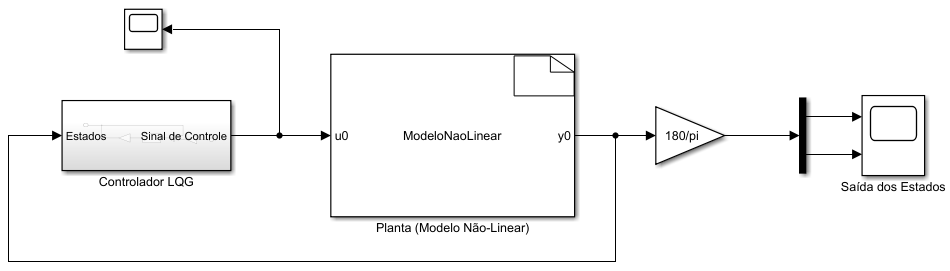
Latex/ProjControladores/lqg_control.png
