mferreiracosta/tcc_cefet/Latex/ProjControladores/lqg_control_real.png

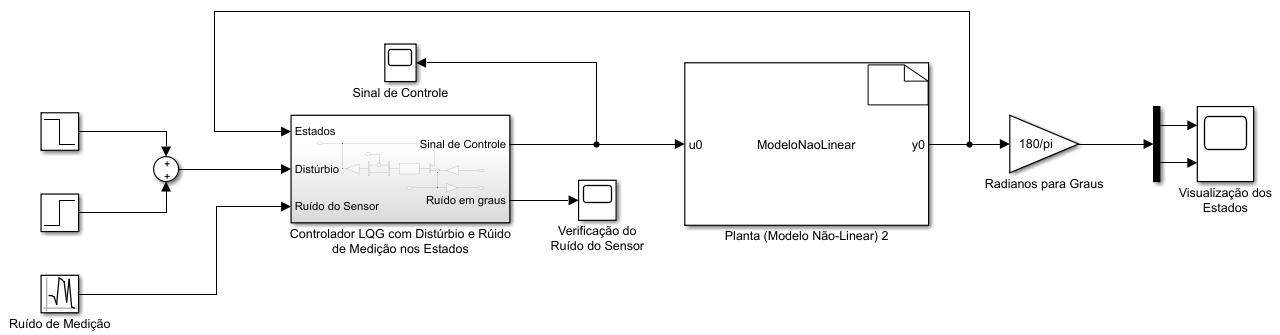
Latex/ProjControladores/lqg_control_real.png
