mferreiracosta/tcc_cefet/Latex/ProjControladores/lqr_control.png

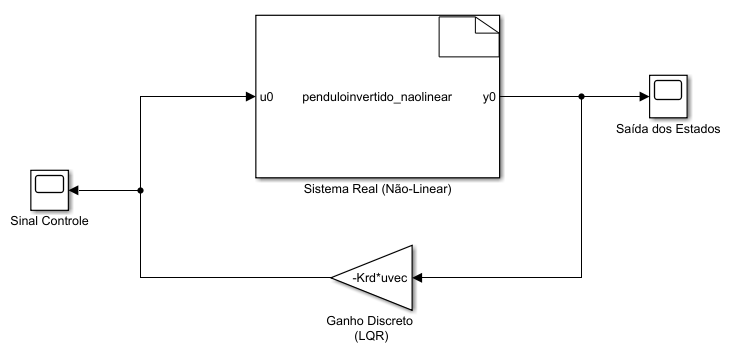
Latex/ProjControladores/lqr_control.png
