mferreiracosta/tcc_cefet/Latex/ProjControladores/topografia_lqg_real.png

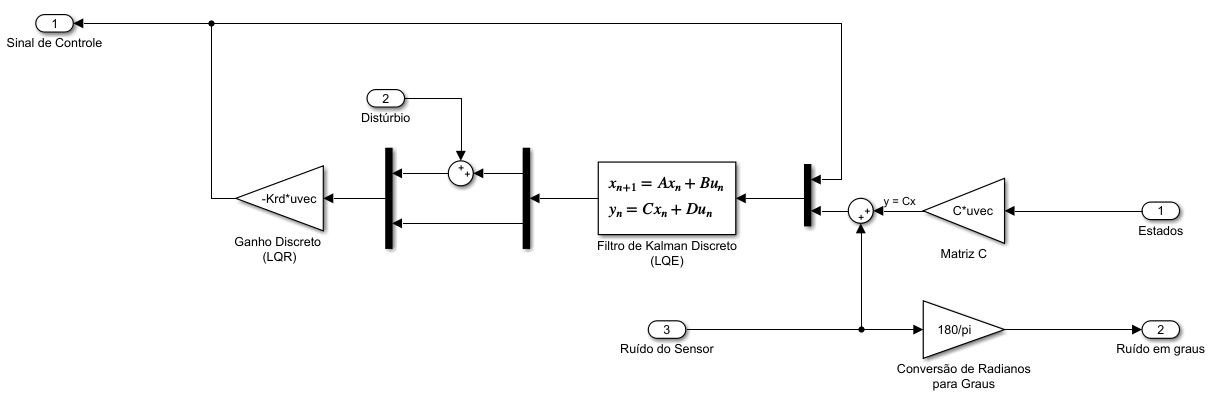
Latex/ProjControladores/topografia_lqg_real.png
