mferreiracosta/tcc_cefet/TCC 1/Desenvolvimento do Texto/2_Fundamentos/1_Imagens Modelo/1_MotorCC.PNG

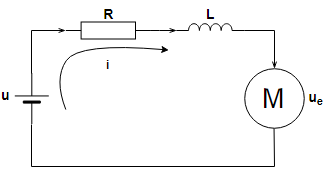
TCC 1/Desenvolvimento do Texto/2_Fundamentos/1_Imagens Modelo/1_MotorCC.PNG
