mferreiracosta/tcc_cefet/TCC 1/Desenvolvimento do Texto/2_Fundamentos/LQG_Discreto.PNG

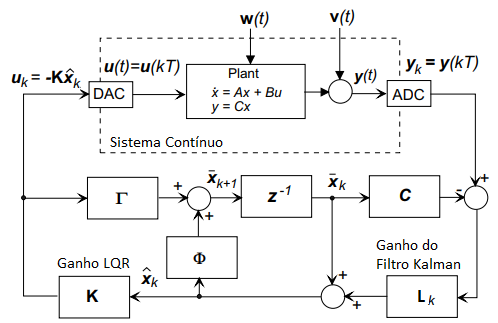
TCC 1/Desenvolvimento do Texto/2_Fundamentos/LQG_Discreto.PNG
