mferreiracosta/tcc_cefet/TCC 1/Desenvolvimento do Texto/3_Metodologia/Motor/CalculoMotor.PNG

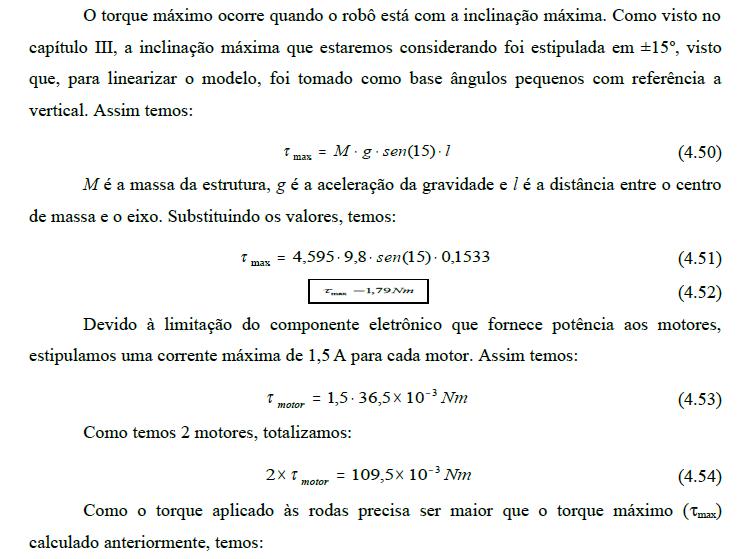
TCC 1/Desenvolvimento do Texto/3_Metodologia/Motor/CalculoMotor.PNG
