mferreiracosta/tcc_cefet/TCC 1/Desenvolvimento do Texto/3_Metodologia/Parâmetros Elétricos Sensor.PNG

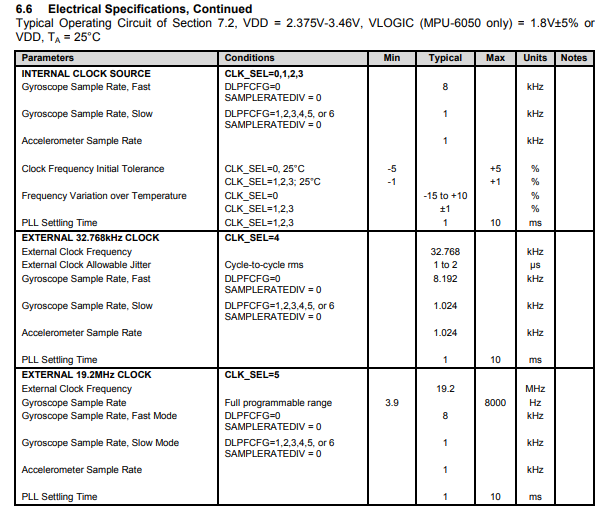
TCC 1/Desenvolvimento do Texto/3_Metodologia/Parâmetros Elétricos Sensor.PNG
