mferreiracosta/tcc_cefet/TCC 1/Referências Bibliográficas/DADOS SOBRE MDF/Capturar.PNG

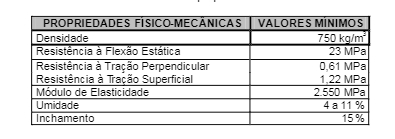
TCC 1/Referências Bibliográficas/DADOS SOBRE MDF/Capturar.PNG
