mferreiracosta/tcc_cefet/TCC 1/SolidWorks/Desenho/1_Isometrica.jpeg

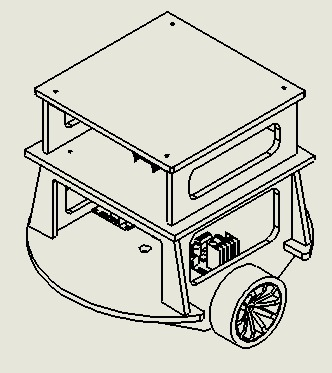
TCC 1/SolidWorks/Desenho/1_Isometrica.jpeg
