mferreiracosta/tcc_cefet/TCC 1/SolidWorks/Desenho/Base.jpeg

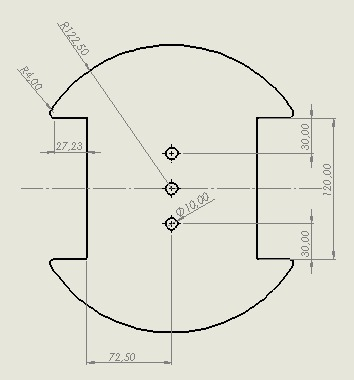
TCC 1/SolidWorks/Desenho/Base.jpeg
