mferreiracosta/tcc_cefet/TCC 1/SolidWorks/Desenho/Base_Sup.jpeg

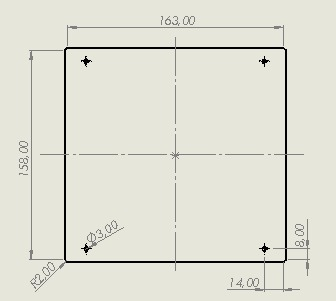
TCC 1/SolidWorks/Desenho/Base_Sup.jpeg
