mferreiracosta/tcc_cefet/TCC 1/SolidWorks/Desenho/Lat_Front_Sup.jpeg

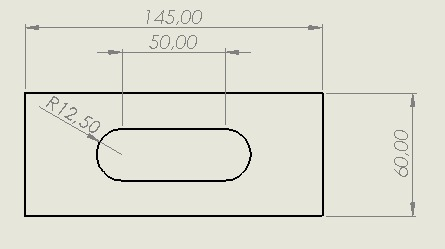
TCC 1/SolidWorks/Desenho/Lat_Front_Sup.jpeg
