mferreiracosta/tcc_cefet/TCC 1/SolidWorks/Desenho/Lat_Frontal.jpeg

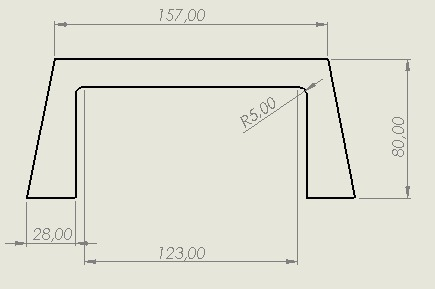
TCC 1/SolidWorks/Desenho/Lat_Frontal.jpeg
