mferreiracosta/tcc_cefet/TCC 1/SolidWorks/Desenho/Lat_roda.jpeg

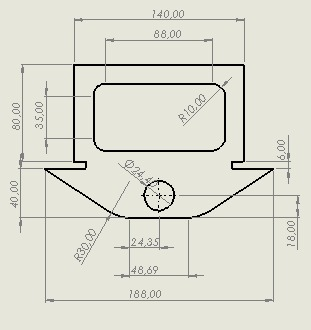
TCC 1/SolidWorks/Desenho/Lat_roda.jpeg
