mferreiracosta/tcc_cefet/TCC 1/SolidWorks/Desenho/Superior.jpeg

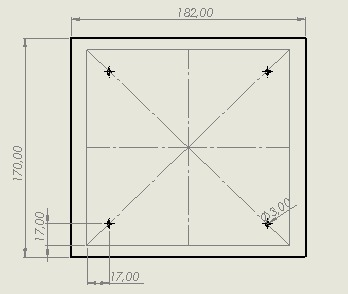
TCC 1/SolidWorks/Desenho/Superior.jpeg
