mferreiracosta/tcc_cefet/TCC 1/Referências Bibliográficas/Características Componentes Eletrônicos/Dados-Motor.txt

Dados Técnicos:

- Tensão: 6V DC
- Velocidade: 210 RPM
- Diâmetro do eixo: 4mm
- Comprimento do eixo: 12mm
- Máxima eficiência: 2.0kg.cm/170rpm/2.0W/0.60A
- Máximo torque: 5.2kg.cm/110rpm/3.1W/1.10A
- Cabo de conexão: 6 fios
- Comprimento do cabo: 20 cm
- Redução: 1:34 (1:34.02)
- Resolução do Encoder: 11 x Redução 34.02 = 341.2PPR
- Comprimento total motor e eixo: 73mm
- Diâmetro do motor: 25mm
- Encoder integrado
