mferreiracosta/tcc_cefet/TCC 1/Referências Bibliográficas/Características Componentes Eletrônicos/Arduino.PNG

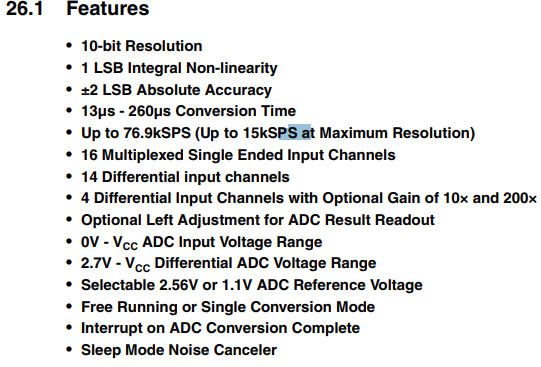
TCC 1/Referências Bibliográficas/Características Componentes Eletrônicos/Arduino.PNG
