mferreiracosta/tcc_cefet/TCC 1/Referências Bibliográficas/Características Componentes Eletrônicos/Motor.PNG

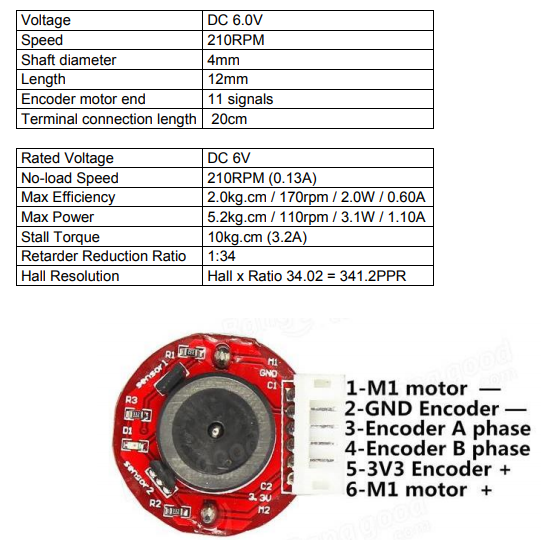
TCC 1/Referências Bibliográficas/Características Componentes Eletrônicos/Motor.PNG
