mferreiracosta/tcc_cefet/TCC 1/SolidWorks/Dispositivos Feitos/MONTAGEM_PENDULO.SLDASM

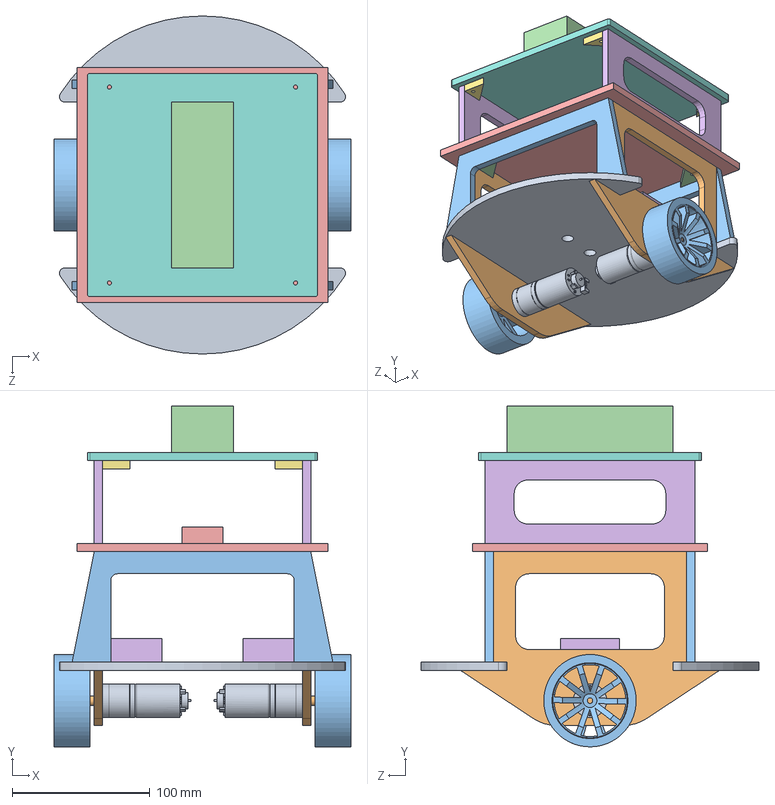
[picture p180: CAD file, 2022-06-22]
TCC 1/SolidWorks/Dispositivos Feitos/MONTAGEM_PENDULO.SLDASM
215.1 x 247.0 x 245.0 mm
Base
Lateral_Roda x 2
Lateral_Frontal x 2
SuporteCantos_2 x 4
Superior1
LateralSup x 2
SuporteCantos_1 x 4
BaseSupTeto
Motor x 2
AcoplamentoMotorRoda x 2
Tires x 2
BATERIA
ESP32
L298N x 2
