mferreiracosta/tcc_cefet/TCC 1/SolidWorks/Eletrônicos/Bateria/Turnigy - Batterie Nanotech 1800mAh 2S.SLDASM

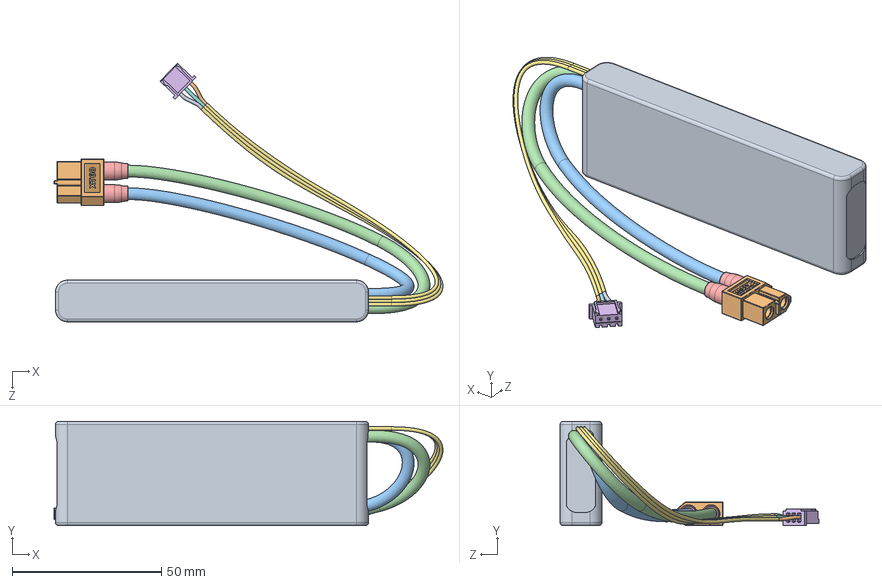
[picture p181: CAD file, 2022-06-22]
TCC 1/SolidWorks/Eletrônicos/Bateria/Turnigy - Batterie Nanotech 1800mAh 2S.SLDASM
130.5 x 35.0 x 86.8 mm
SA_Turnigy_1800mAh_2S__nano_tech_Lipo_Battery
XT60 MALE
Cble^Cable_3-SA_TURNIGY NANOTECH 1800mAh 2S
Cble^Cable_4-SA_TURNIGY NANOTECH 1800mAh 2S
Pièce2^Turnigy - Batterie Nanotech 1800mAh 2S x 2
JST 2S
Pièce7^Turnigy - Batterie Nanotech 1800mAh 2S
Cble^Cable_6-SA_TURNIGY NANOTECH 1800mAh 2S
Cble^Cable_7-SA_TURNIGY NANOTECH 1800mAh 2S-001
Cble^Cable_9-SA_TURNIGY NANOTECH 1800mAh 2S
