mferreiracosta/tcc_cefet/TCC 1/SolidWorks/Eletrônicos/PoLoLu.SLDASM

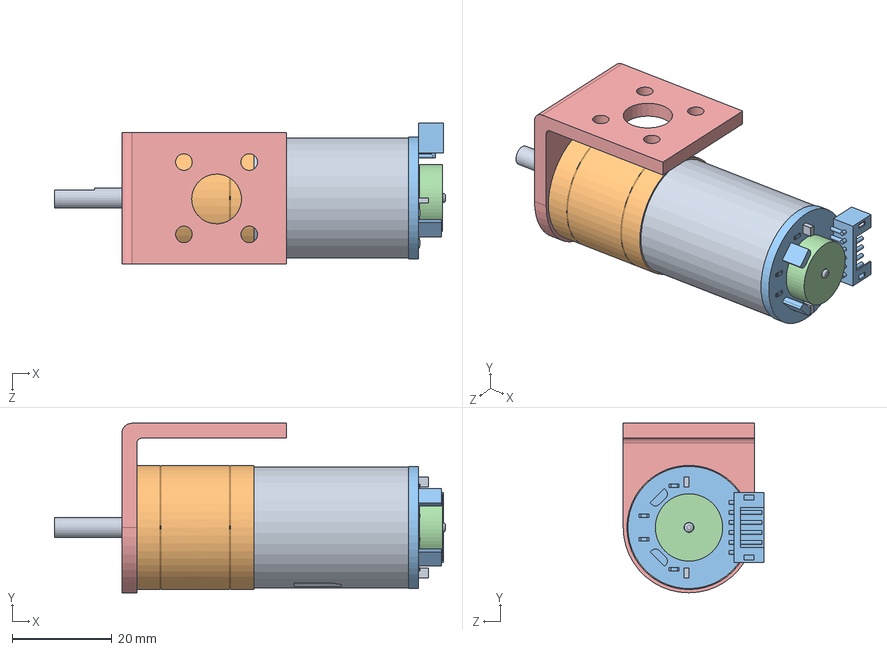
[picture p182: CAD file, 2022-06-22]
TCC 1/SolidWorks/Eletrônicos/PoLoLu.SLDASM
78.4 x 34.0 x 28.2 mm
motor
cReduct
encoder
iman
soportMotor
