mferreiracosta/tcc_cefet/TCC 1/SolidWorks/Mont_Estrutura.SLDASM

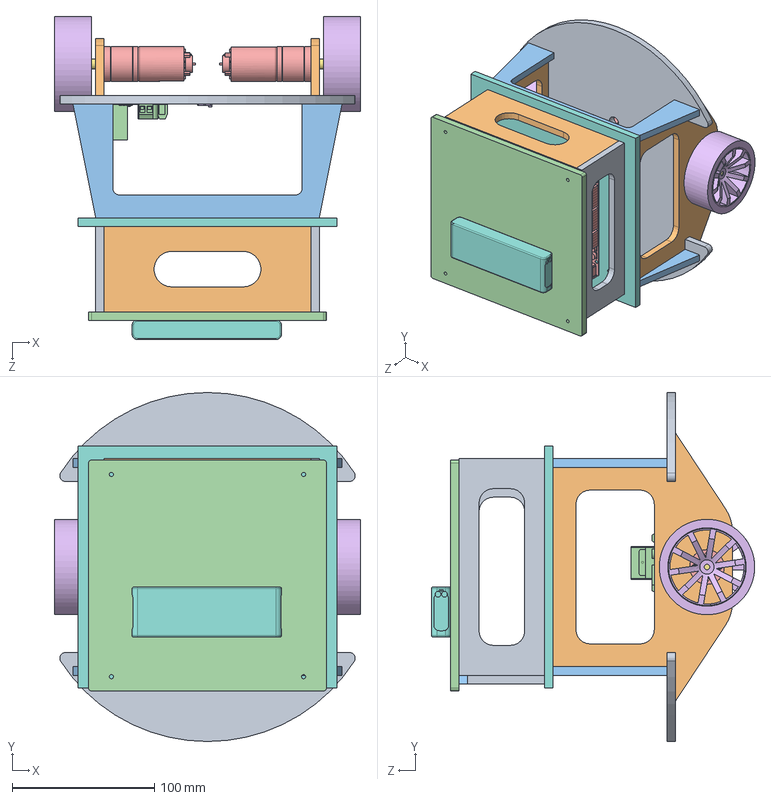
[picture p183: CAD file, 2022-06-22]
TCC 1/SolidWorks/Mont_Estrutura.SLDASM
215.1 x 245.0 x 227.1 mm
Base
Lateral_Roda x 2
Lateral_Frontal x 2
Motor Driver
ArduinoMega2560
IMU
SuporteCantos_2 x 4
Superior1
LateralSup x 2
SuporteCantos_1 x 4
BaseSupTeto
Motor x 2
Tires x 2
AcoplamentoMotorRoda x 2
SA_Turnigy_1800mAh_2S__nano_tech_Lipo_Battery
