mferreiracosta/tcc_cefet/Projeto Mecânico/PENDULO-TCC2.SLDASM

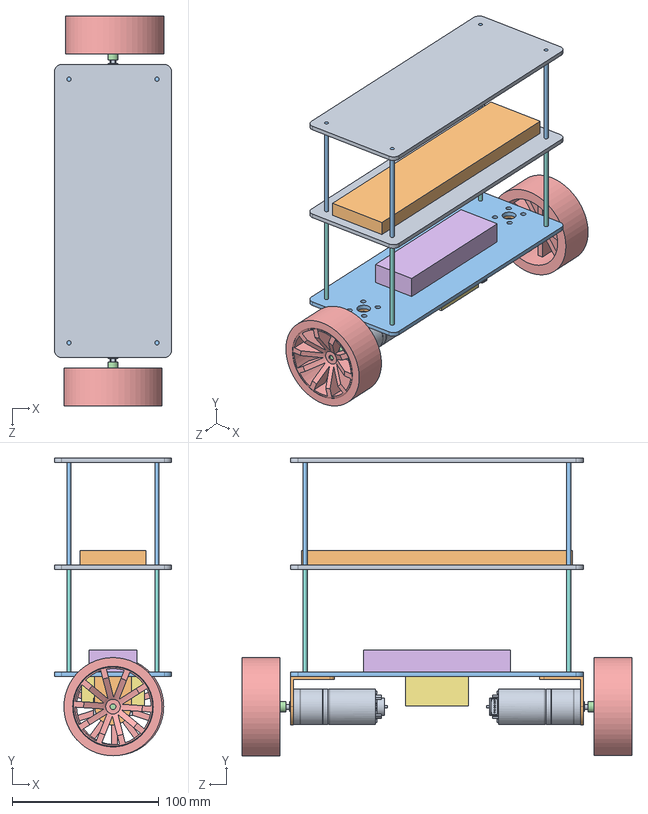
[picture p184: CAD file, 2022-06-19]
Projeto Mecânico/PENDULO-TCC2.SLDASM
80.0 x 203.0 x 266.1 mm
Motor x 2
SUPORTE MOTOR x 2
PLACA SUSTENCAO INF
AcoplamentoMotorRoda x 2
Tires x 2
BATERIA
L298N
HASTE_INFERIOR x 4
PLACA SUSTENCAO x 2
CONJ ELETRONICOS
HASTE_SUPERIOR x 4
