mferreiracosta/tcc_cefet/TCC 1/SolidWorks/Eletrônicos/Roda/Roda-Completa.SLDASM

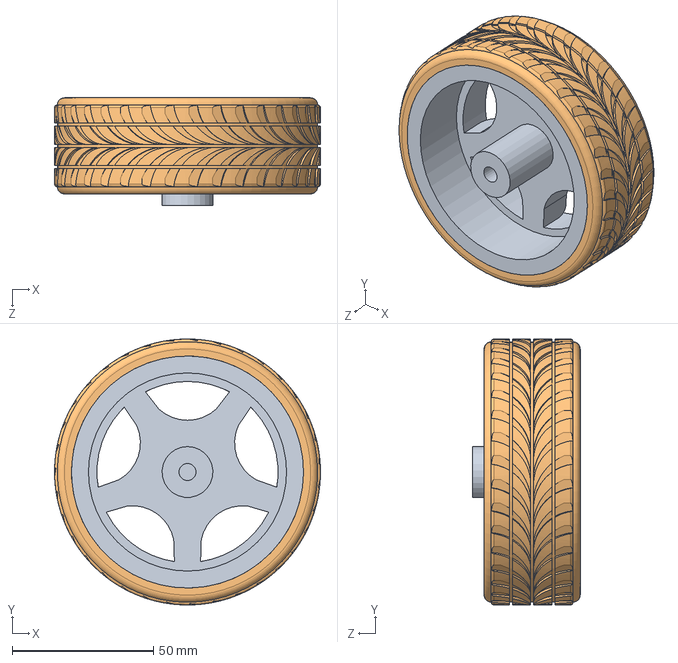
[picture p185: CAD file, 2022-06-22]
TCC 1/SolidWorks/Eletrônicos/Roda/Roda-Completa.SLDASM
94.0 x 94.0 x 38.0 mm
Roda-PIDR
Pneu-PIDR
