mferreiracosta/tcc_cefet/TCC 1/SolidWorks/Eletrônicos/ESP32/ESP32S Dev Board 0.9inch width ASSY.SLDASM

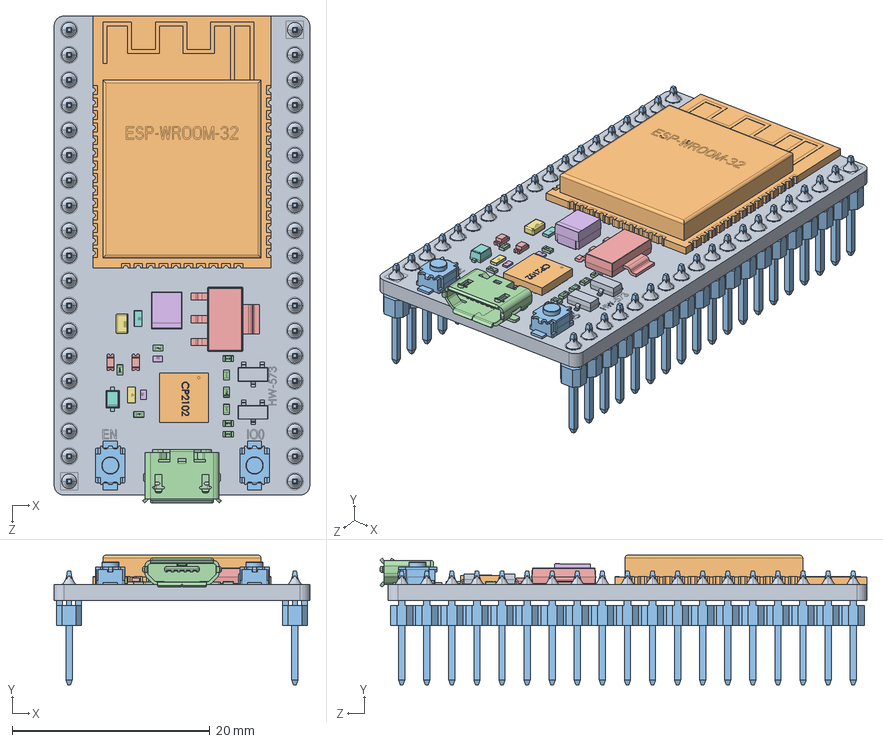
[picture p186: CAD file, 2022-06-22]
TCC 1/SolidWorks/Eletrônicos/ESP32/ESP32S Dev Board 0.9inch width ASSY.SLDASM
25.9 x 13.1 x 49.3 mm
ESP32S HW-573 PCB
ESP-WROOM-32
Male Header 19P 100 Pitch x 2
micro_usb_47346-0001
CircuitWorks-SOT-223
Pol Cap SMD 3528 H2mm
0805 SMD Capacitor
0603 SMD Resistor
SOT-23 x 2
QFN28_5X5
Tact Switch SMD Tab 4mmx3mm x 2
0402 SMD Resistor___ _________ x 9
LED SMD0603 x 2
0402 SMD Capacitor x 2
0603 SMD Capacitor
SOD323F-1
Pin Solder Joint x 38
