mferreiracosta/tcc_cefet/Projeto Mecânico/CORTE CNC/Placas.dxf

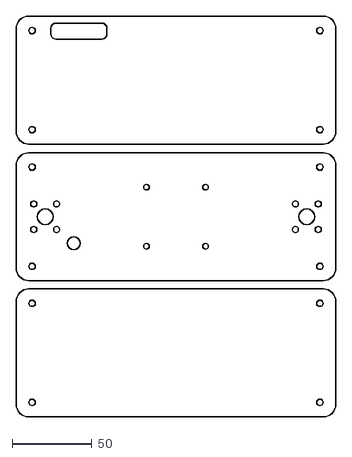
[picture p187: CAD file, 2022-06-19]
Projeto Mecânico/CORTE CNC/Placas.dxf
200.0 x 250.6
