mferreiracosta/tcc_cefet/Projeto Mecânico/HASTE.SLDPRT

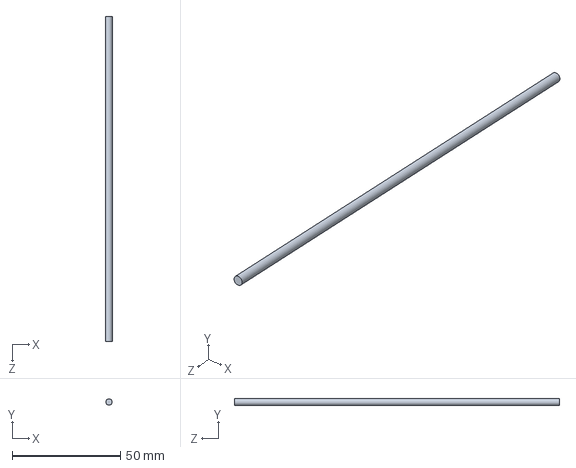
[picture p188: CAD file, 2022-06-19]
Projeto Mecânico/HASTE.SLDPRT
3.00 x 3.00 x 150.0 mm
