mferreiracosta/tcc_cefet/TCC 1/SolidWorks/Eletrônicos/Bateria/Composants/XT60 MALE.SLDPRT

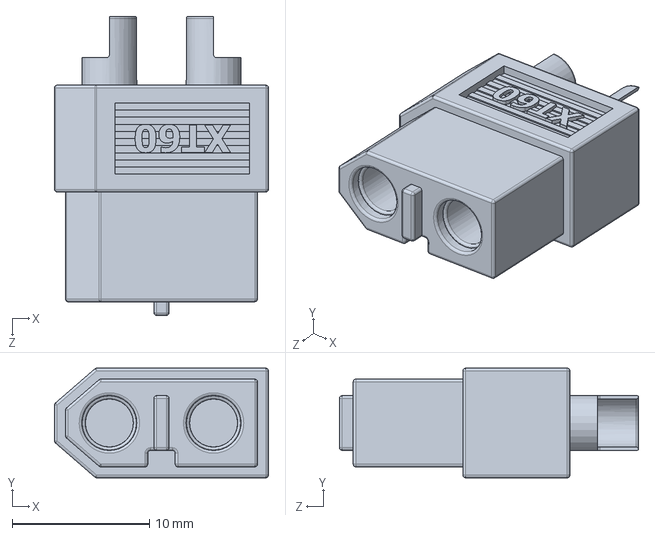
[picture p189: CAD file, 2022-06-22]
TCC 1/SolidWorks/Eletrônicos/Bateria/Composants/XT60 MALE.SLDPRT
15.6 x 8.00 x 21.8 mm
