mferreiracosta/tcc_cefet/TCC 1/SolidWorks/Eletrônicos/Roda/Roda-PIDR.SLDPRT

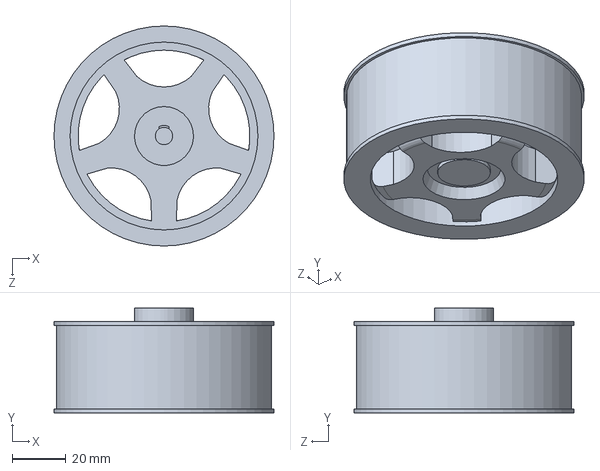
[picture p190: CAD file, 2022-06-22]
TCC 1/SolidWorks/Eletrônicos/Roda/Roda-PIDR.SLDPRT
82.0 x 39.0 x 82.0 mm
