mferreiracosta/tcc_cefet/TCC 1/SolidWorks/Estrutura/SuporteCantos_2.SLDPRT

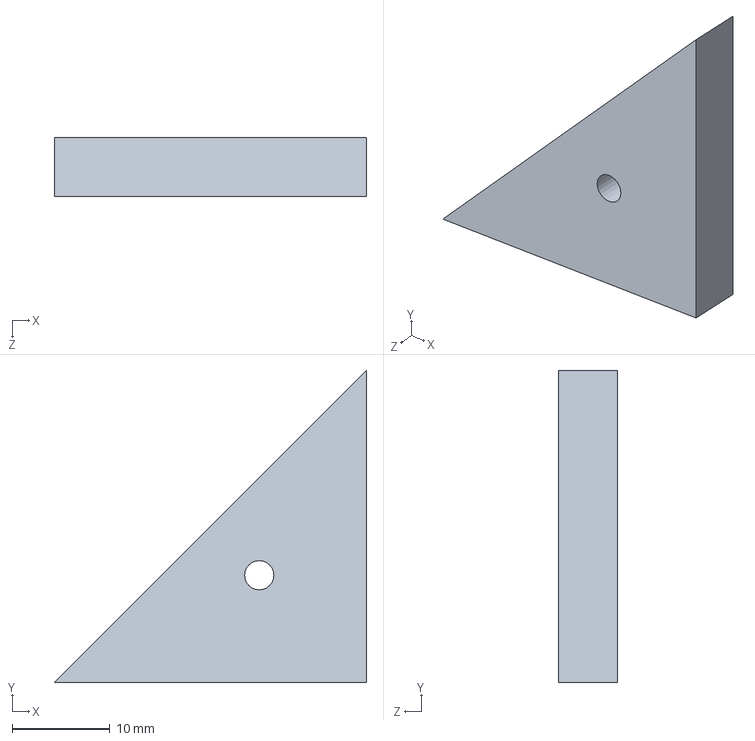
[picture p191: CAD file, 2022-06-22]
TCC 1/SolidWorks/Estrutura/SuporteCantos_2.SLDPRT
32.0 x 32.0 x 6.00 mm
