mferreiracosta/tcc_cefet/TCC 1/SolidWorks/Dispositivos Feitos/L298N.SLDPRT

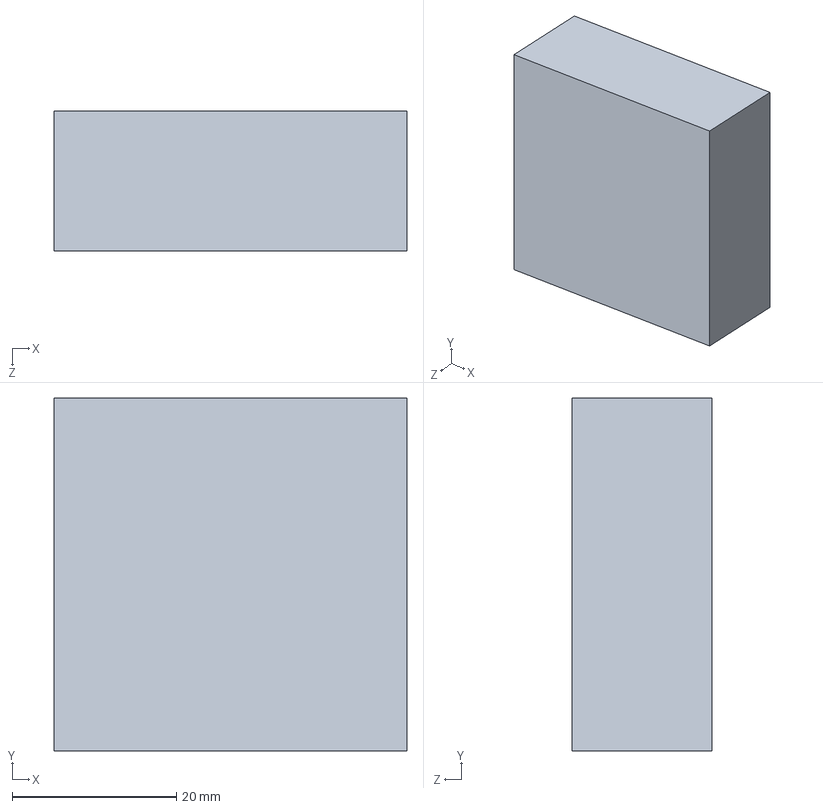
[picture p192: CAD file, 2022-06-22]
TCC 1/SolidWorks/Dispositivos Feitos/L298N.SLDPRT
43.0 x 43.0 x 17.0 mm
