mferreiracosta/tcc_cefet/TCC 1/SolidWorks/Eletrônicos/Bateria/Composants/JST 2S.SLDPRT

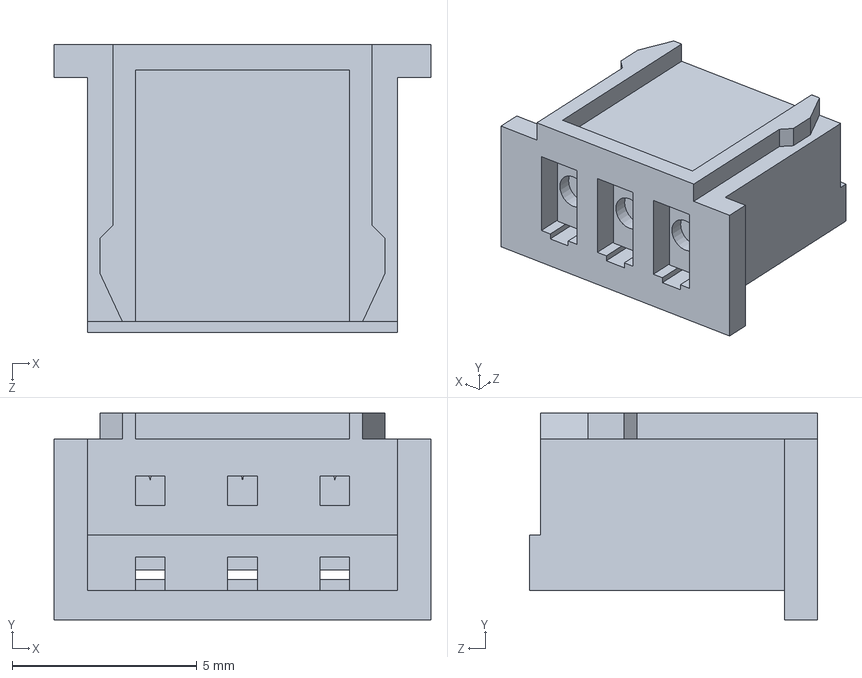
[picture p193: CAD file, 2022-06-22]
TCC 1/SolidWorks/Eletrônicos/Bateria/Composants/JST 2S.SLDPRT
10.2 x 5.60 x 7.80 mm
