mferreiracosta/tcc_cefet/TCC 1/SolidWorks/Eletrônicos/Motor Driver.SLDPRT

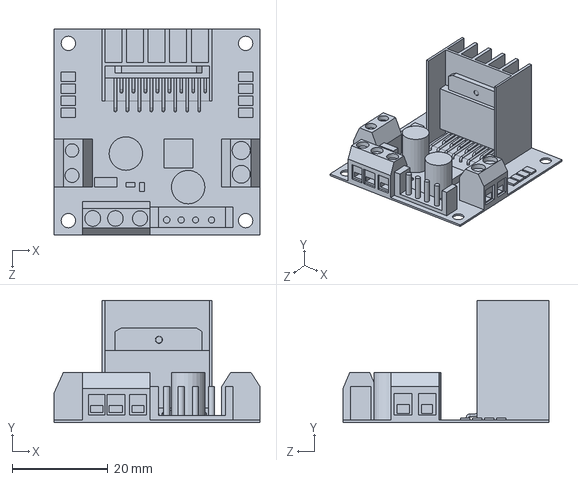
[picture p194: CAD file, 2022-06-22]
TCC 1/SolidWorks/Eletrônicos/Motor Driver.SLDPRT
43.0 x 25.5 x 43.0 mm
