mferreiracosta/tcc_cefet/TCC 1/SolidWorks/Eletrônicos/Roda/Pneu-PIDR.SLDPRT

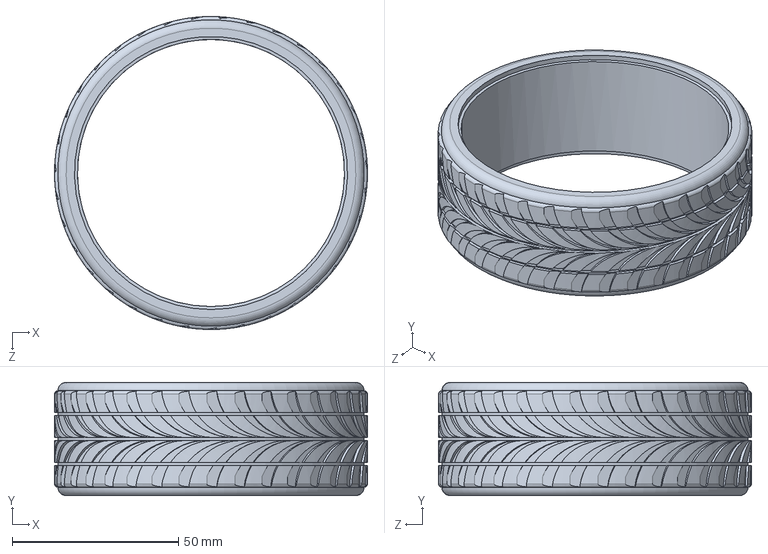
[picture p195: CAD file, 2022-06-22]
TCC 1/SolidWorks/Eletrônicos/Roda/Pneu-PIDR.SLDPRT
94.0 x 34.0 x 94.0 mm
