mferreiracosta/tcc_cefet/TCC 1/SolidWorks/Estrutura/Lateral_Frontal.SLDPRT

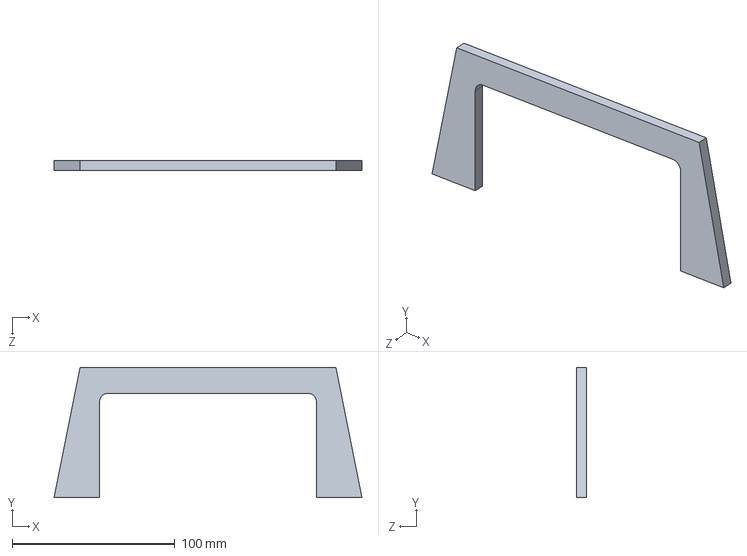
[picture p196: CAD file, 2022-06-22]
TCC 1/SolidWorks/Estrutura/Lateral_Frontal.SLDPRT
189.0 x 80.0 x 6.00 mm
