mferreiracosta/tcc_cefet/TCC 1/SolidWorks/Tires.SLDPRT

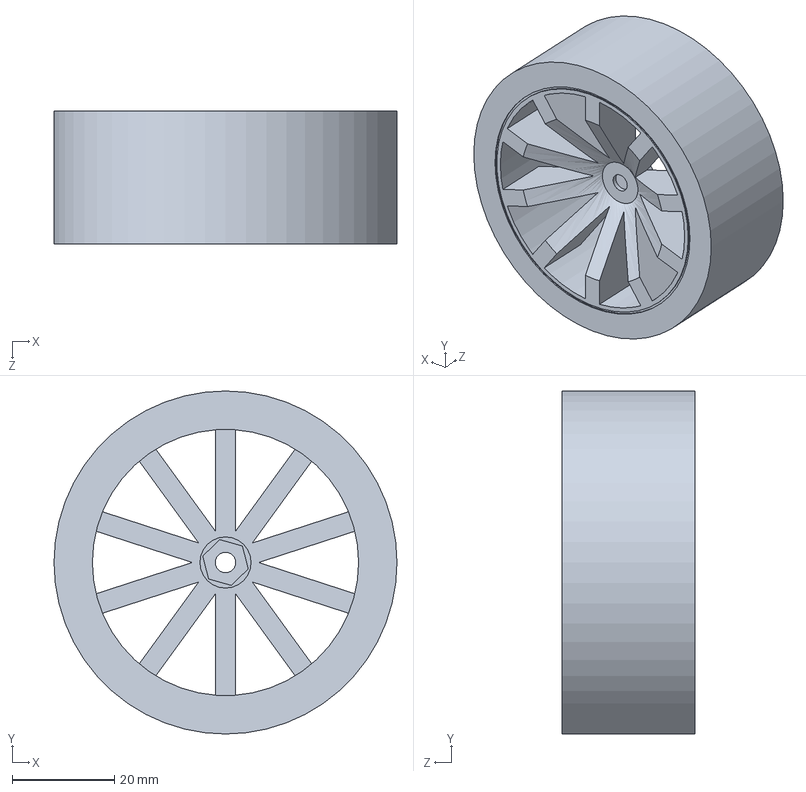
[picture p197: CAD file, 2022-06-22]
TCC 1/SolidWorks/Tires.SLDPRT
67.0 x 67.0 x 26.0 mm
