mferreiracosta/tcc_cefet/Projeto Mecânico/PLACA SUSTENCAO.SLDPRT

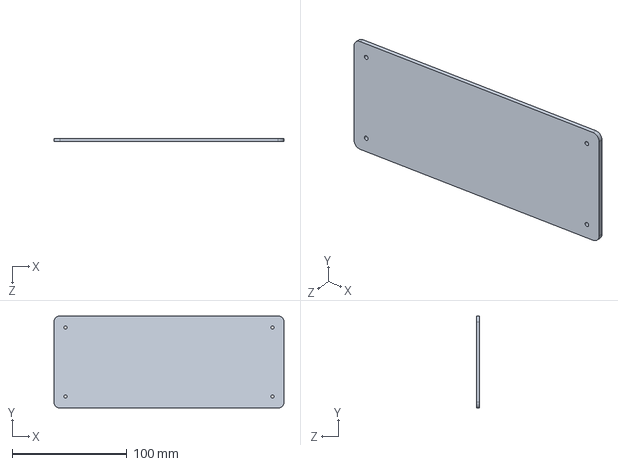
[picture p198: CAD file, 2022-06-19]
Projeto Mecânico/PLACA SUSTENCAO.SLDPRT
200.0 x 80.0 x 3.00 mm
