mferreiracosta/tcc_cefet/TCC 1/SolidWorks/Dispositivos Feitos/BATERIA.SLDPRT

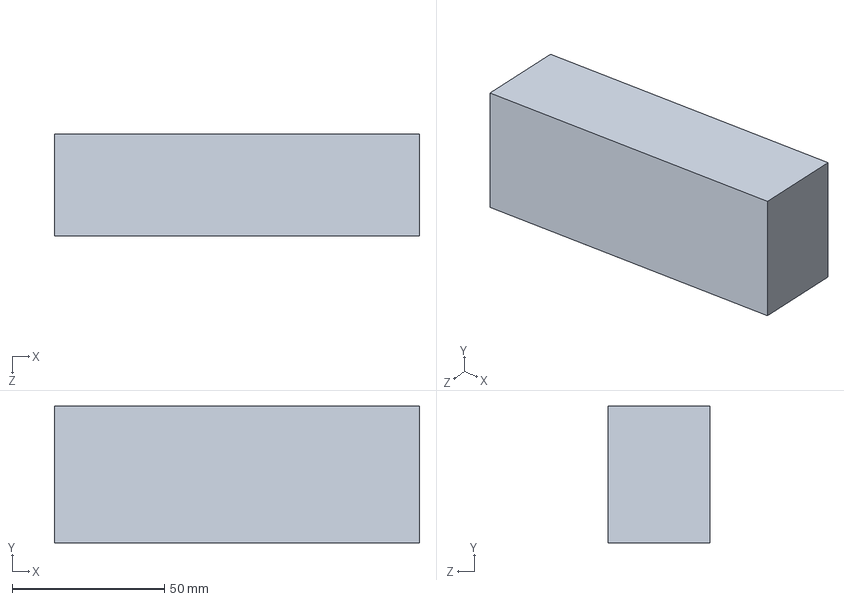
[picture p199: CAD file, 2022-06-22]
TCC 1/SolidWorks/Dispositivos Feitos/BATERIA.SLDPRT
120.0 x 45.0 x 33.5 mm
