mferreiracosta/tcc_cefet/TCC 1/SolidWorks/Eletrônicos/IMU.SLDPRT

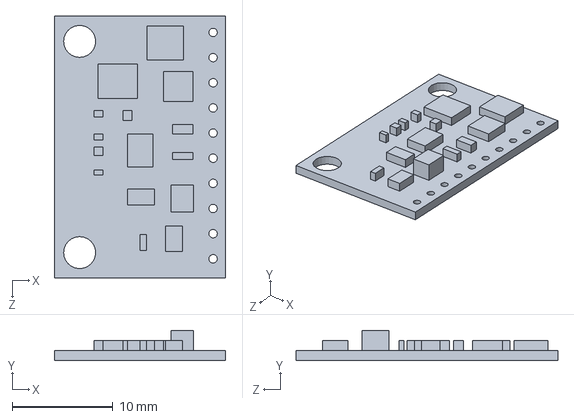
[picture p200: CAD file, 2022-06-22]
TCC 1/SolidWorks/Eletrônicos/IMU.SLDPRT
17.0 x 3.00 x 26.0 mm
