mferreiracosta/tcc_cefet/TCC 1/SolidWorks/Estrutura/Lateral_Roda.SLDPRT

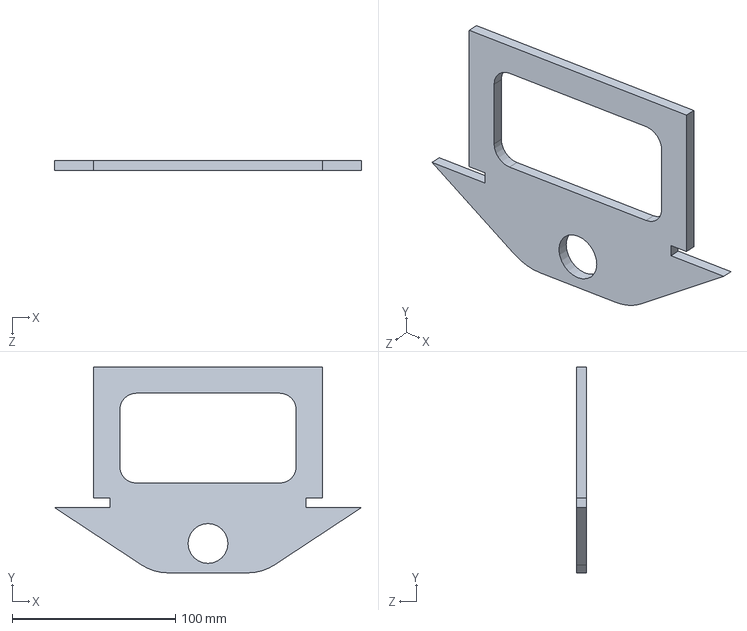
[picture p201: CAD file, 2022-06-22]
TCC 1/SolidWorks/Estrutura/Lateral_Roda.SLDPRT
188.0 x 126.0 x 6.00 mm
