mferreiracosta/tcc_cefet/TCC 1/SolidWorks/Dispositivos Feitos/ESP32.SLDPRT

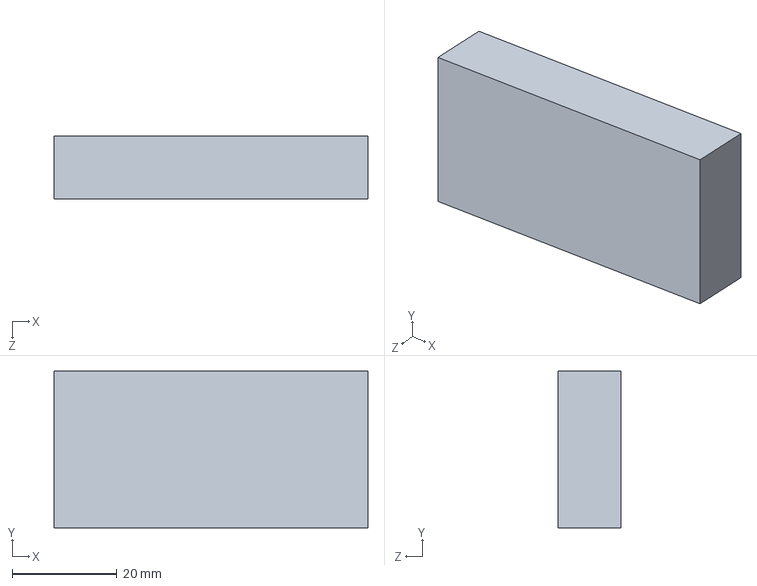
[picture p202: CAD file, 2022-06-19]
TCC 1/SolidWorks/Dispositivos Feitos/ESP32.SLDPRT
60.0 x 30.0 x 12.0 mm
