mferreiracosta/tcc_cefet/TCC 1/SolidWorks/Eletrônicos/Bateria/Composants/SA_Turnigy_1800mAh_2S__nano_tech_Lipo_Battery.SLDPRT

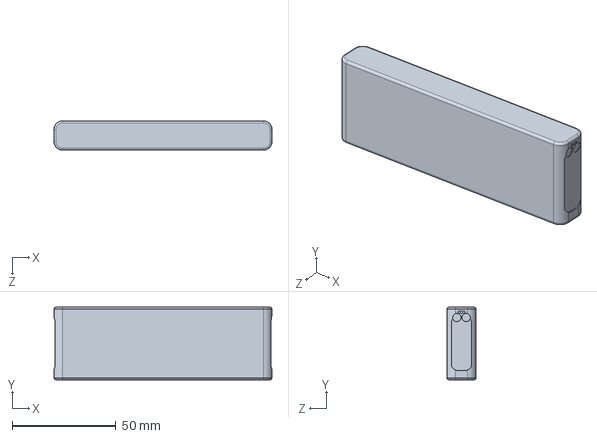
[picture p203: CAD file, 2022-06-22]
TCC 1/SolidWorks/Eletrônicos/Bateria/Composants/SA_Turnigy_1800mAh_2S__nano_tech_Lipo_Battery.SLDPRT
105.0 x 35.0 x 14.0 mm
