mferreiracosta/tcc_cefet/TCC 1/SolidWorks/Estrutura/LateralSup.SLDPRT

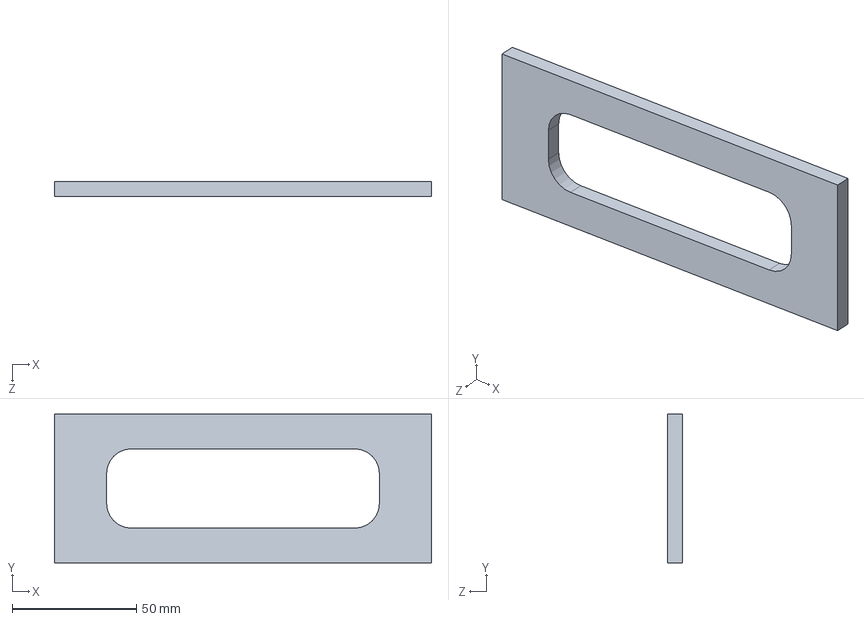
[picture p204: CAD file, 2022-06-22]
TCC 1/SolidWorks/Estrutura/LateralSup.SLDPRT
152.0 x 60.0 x 6.00 mm
