mferreiracosta/tcc_cefet/Projeto Mecânico/HASTE_INFERIOR.SLDPRT

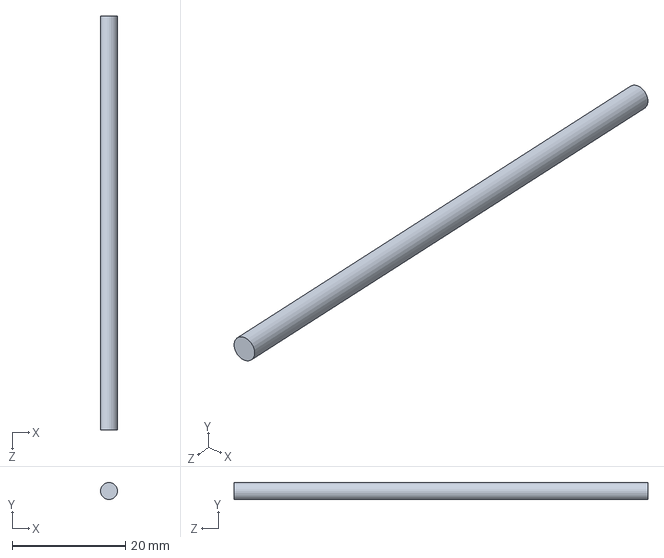
[picture p205: CAD file, 2022-06-19]
Projeto Mecânico/HASTE_INFERIOR.SLDPRT
3.00 x 3.00 x 73.0 mm
