mferreiracosta/tcc_cefet/TCC 1/SolidWorks/Eletrônicos/Motor.SLDPRT

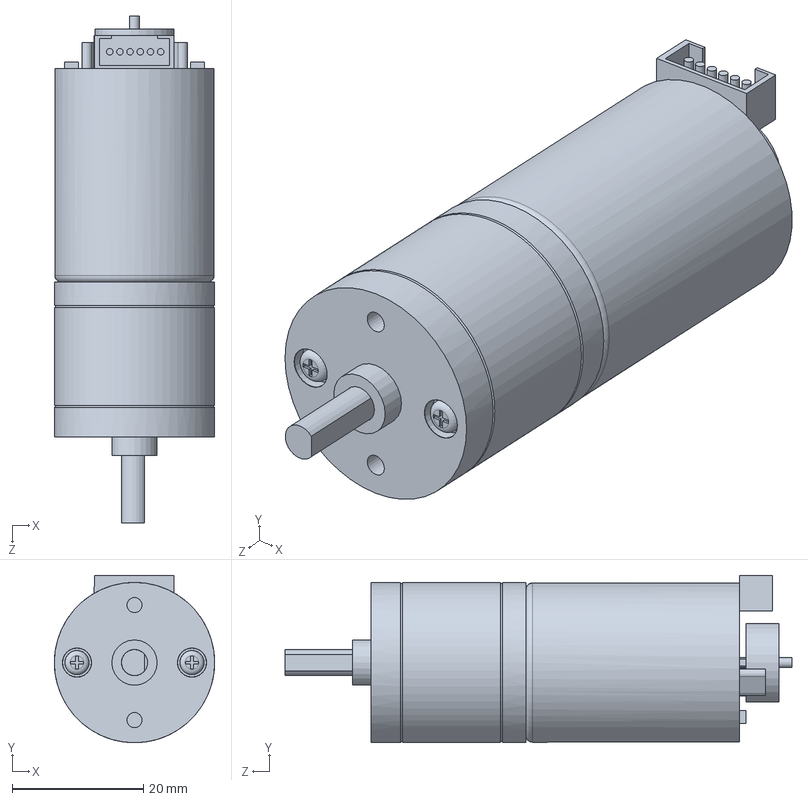
[picture p206: CAD file, 2022-06-22]
TCC 1/SolidWorks/Eletrônicos/Motor.SLDPRT
24.4 x 25.5 x 77.1 mm
