mferreiracosta/tcc_cefet/TCC 1/SolidWorks/Estrutura/Base.SLDPRT

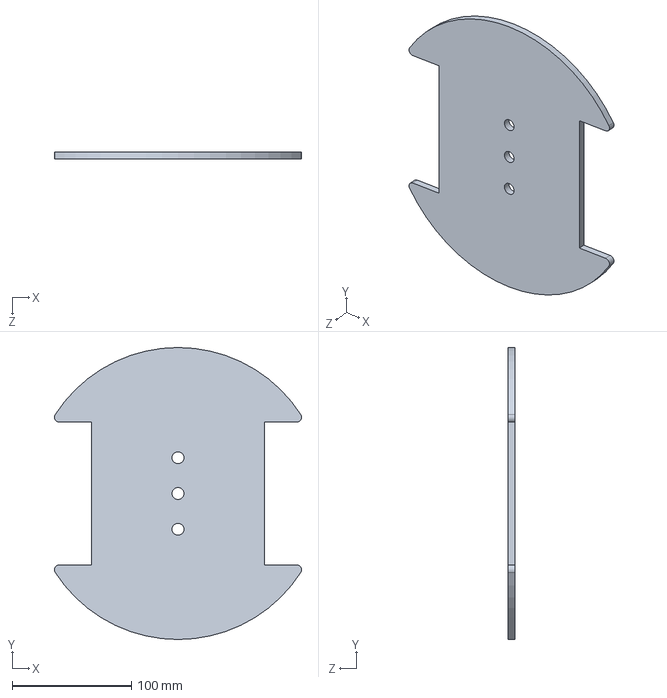
[picture p207: CAD file, 2022-06-22]
TCC 1/SolidWorks/Estrutura/Base.SLDPRT
207.4 x 245.0 x 6.00 mm
