mferreiracosta/tcc_cefet/Projeto Mecânico/SUPORTE MOTOR.SLDPRT

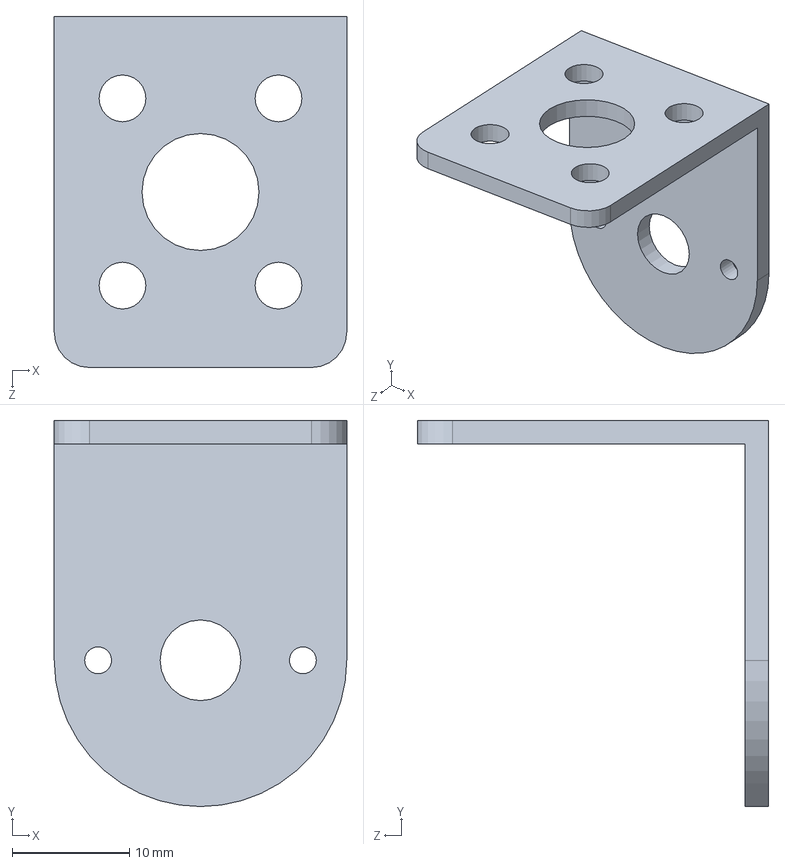
[picture p208: CAD file, 2022-06-19]
Projeto Mecânico/SUPORTE MOTOR.SLDPRT
25.0 x 33.0 x 30.0 mm
