mferreiracosta/tcc_cefet/TCC 1/SolidWorks/Estrutura/LateralFrontalSup.SLDPRT

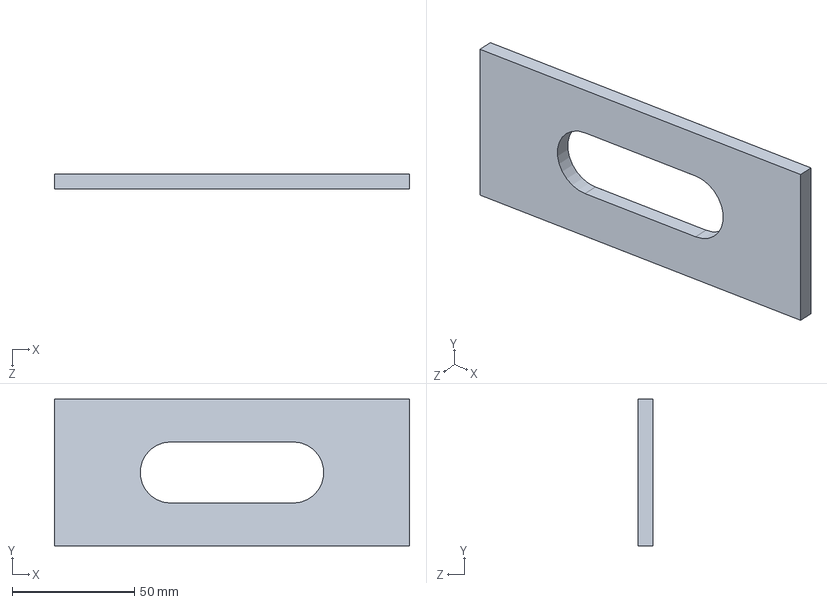
[picture p209: CAD file, 2022-06-22]
TCC 1/SolidWorks/Estrutura/LateralFrontalSup.SLDPRT
145.0 x 60.0 x 6.00 mm
