mferreiracosta/tcc_cefet/Projeto Mecânico/AcoplamentoMotorRoda.SLDPRT

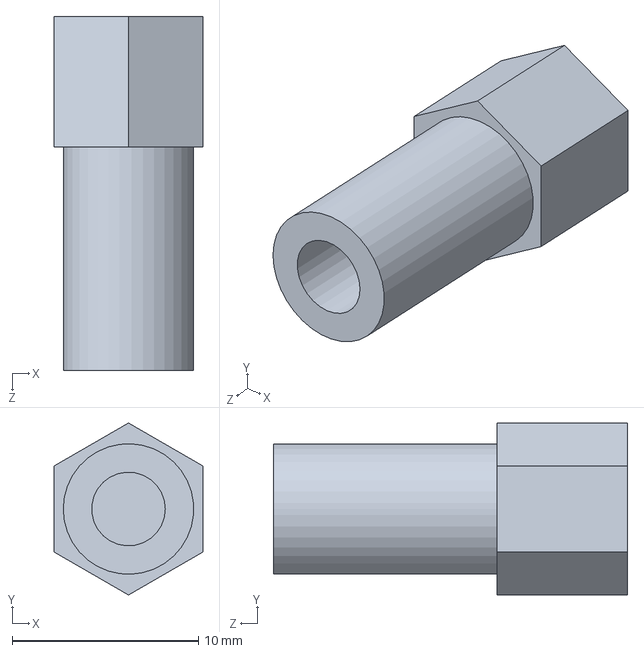
[picture p210: CAD file, 2022-06-19]
Projeto Mecânico/AcoplamentoMotorRoda.SLDPRT
7.99 x 9.23 x 19.0 mm
