mferreiracosta/tcc_cefet/TCC 1/SolidWorks/Estrutura/Superior1.SLDPRT

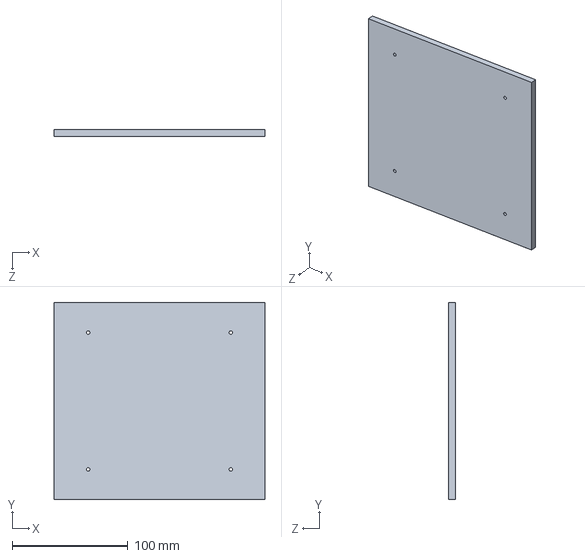
[picture p211: CAD file, 2022-06-22]
TCC 1/SolidWorks/Estrutura/Superior1.SLDPRT
182.0 x 170.0 x 6.00 mm
