mferreiracosta/tcc_cefet/TCC 1/SolidWorks/Estrutura/SuporteCantos_1.SLDPRT

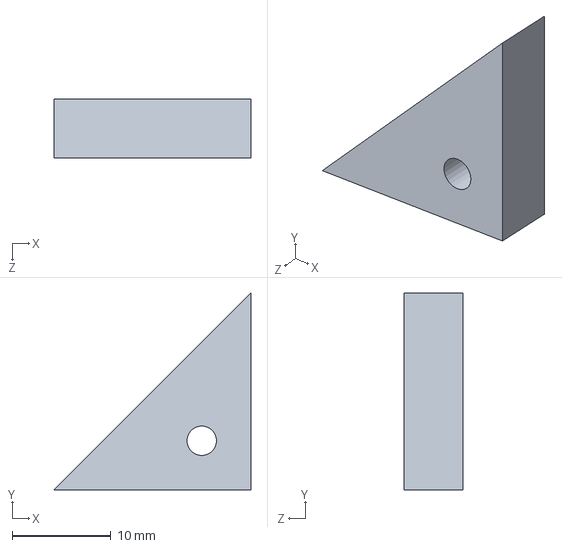
[picture p212: CAD file, 2022-06-22]
TCC 1/SolidWorks/Estrutura/SuporteCantos_1.SLDPRT
20.0 x 20.0 x 6.00 mm
