mferreiracosta/tcc_cefet/Projeto Mecânico/HASTE_SUPERIOR.SLDPRT

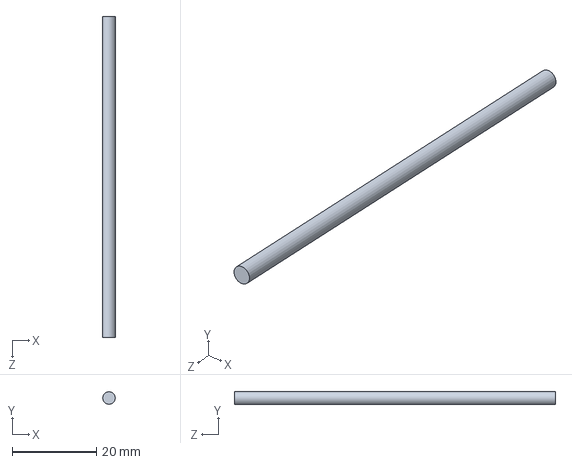
[picture p213: CAD file, 2022-06-19]
Projeto Mecânico/HASTE_SUPERIOR.SLDPRT
3.00 x 3.00 x 76.0 mm
