mferreiracosta/tcc_cefet/Projeto Mecânico/L298N.SLDPRT

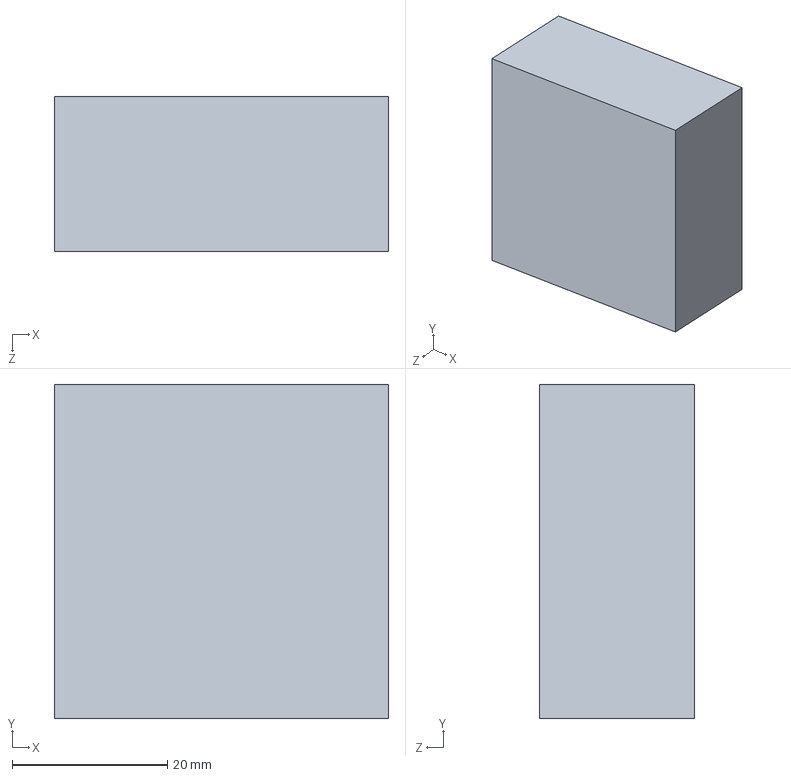
[picture p214: CAD file, 2022-06-19]
Projeto Mecânico/L298N.SLDPRT
43.0 x 43.0 x 20.0 mm
