mferreiracosta/tcc_cefet/TCC 1/SolidWorks/Estrutura/BaseSupTeto.SLDPRT

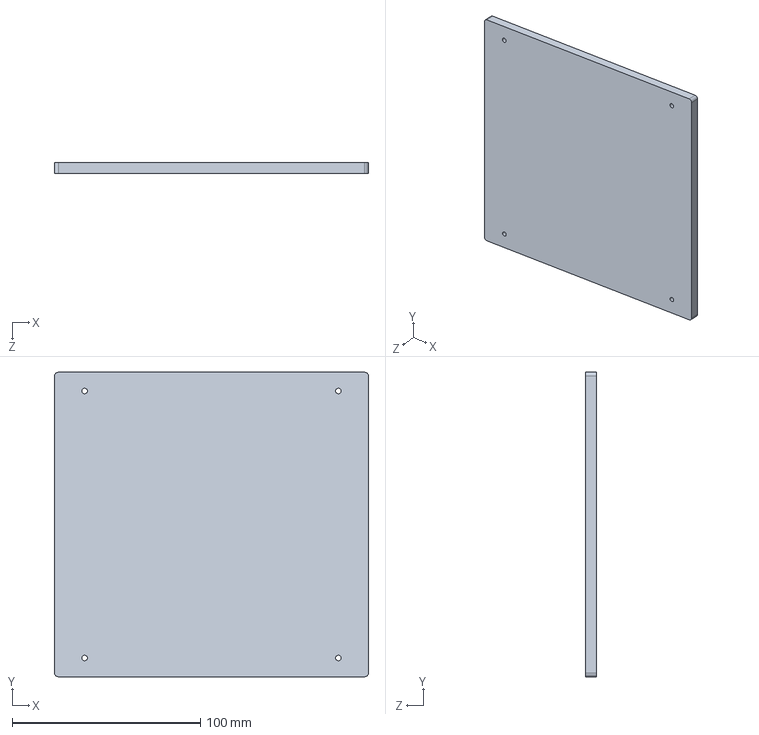
[picture p215: CAD file, 2022-06-22]
TCC 1/SolidWorks/Estrutura/BaseSupTeto.SLDPRT
167.0 x 162.0 x 6.00 mm
