mferreiracosta/tcc_cefet/Projeto Mecânico/CONJ ELETRONICOS.SLDPRT

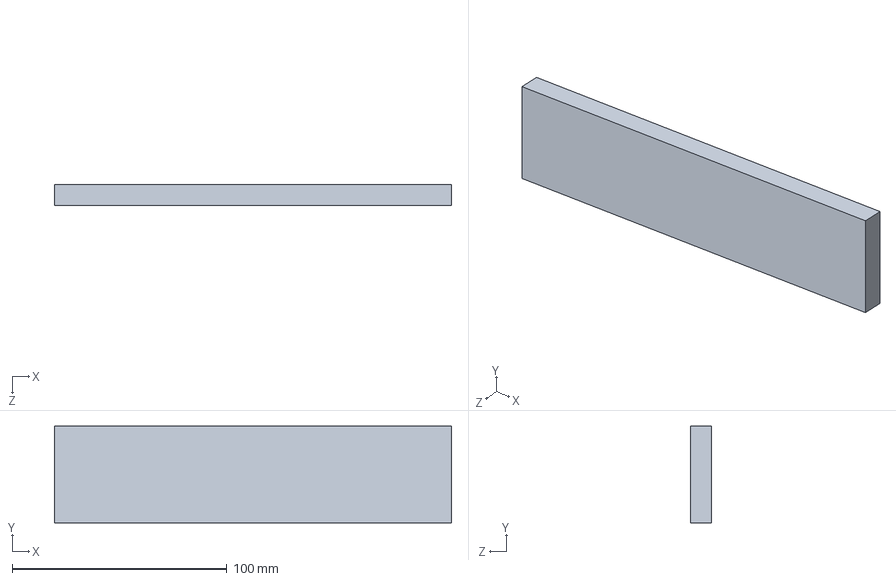
[picture p216: CAD file, 2022-06-19]
Projeto Mecânico/CONJ ELETRONICOS.SLDPRT
185.0 x 45.0 x 10.0 mm
