mferreiracosta/tcc_cefet/Projeto Mecânico/BATERIA.SLDPRT

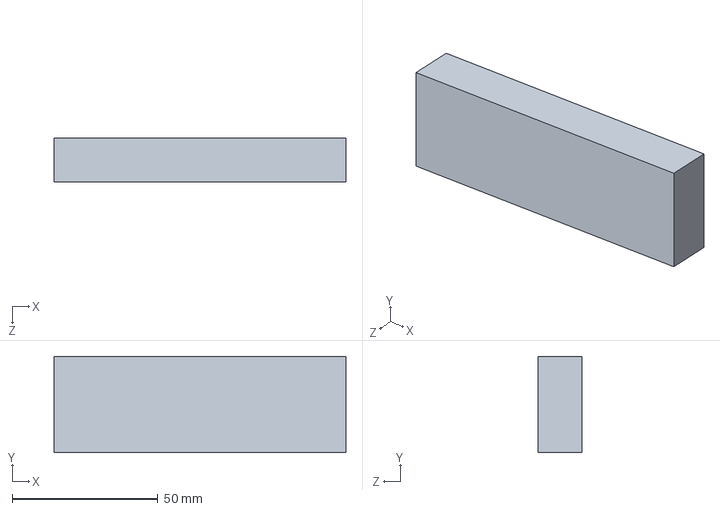
[picture p217: CAD file, 2022-06-19]
Projeto Mecânico/BATERIA.SLDPRT
100.0 x 33.0 x 15.0 mm
