mferreiracosta/tcc_cefet/(list of files, cad)

Other CAD files:
TCC 1/SolidWorks/Eletrônicos/Bateria/Câbles/Cable_6-SA_TURNIGY NANOTECH 1800mAh 2S.sldasm
TCC 1/SolidWorks/Eletrônicos/Bateria/Câbles/Cable_3-SA_TURNIGY NANOTECH 1800mAh 2S.sldasm
TCC 1/SolidWorks/Eletrônicos/Bateria/Composants/Electrical_8-SA_TURNIGY NANOTECH 1800mAh 2S.sldasm
TCC 1/SolidWorks/Eletrônicos/Bateria/Câbles/Cable_9-SA_TURNIGY NANOTECH 1800mAh 2S.sldasm
TCC 1/SolidWorks/Eletrônicos/Bateria/Câbles/Cable_7-SA_TURNIGY NANOTECH 1800mAh 2S-001.sldasm
TCC 1/SolidWorks/Eletrônicos/Bateria/Câbles/Cable_4-SA_TURNIGY NANOTECH 1800mAh 2S.sldasm
TCC 1/SolidWorks/Eletrônicos/ESP32/0805 SMD Capacitor.sldprt
TCC 1/SolidWorks/Eletrônicos/ESP32/micro_usb_47346-0001.sldprt
TCC 1/SolidWorks/Eletrônicos/ESP32/LED SMD0603.sldprt
Projeto Mecânico/PLACA SUSTENCAO INF.SLDPRT
TCC 1/SolidWorks/Eletrônicos/ESP32/ESP-WROOM-32.sldprt
TCC 1/SolidWorks/Eletrônicos/SA_Turnigy_1800mAh_2S__nano_tech_Lipo_Battery.SLDPRT
TCC 1/SolidWorks/Eletrônicos/ESP32/CircuitWorks-SOT-223.sldprt
TCC 1/SolidWorks/Eletrônicos/ESP32/Male Header 19P 100 Pitch.sldprt
Projeto Mecânico/Tires.SLDPRT
TCC 1/SolidWorks/Eletrônicos/ESP32/0402 SMD Resistor___ _________.sldprt
TCC 1/SolidWorks/Eletrônicos/ESP32/Pol Cap SMD 3528 H2mm.sldprt
TCC 1/SolidWorks/Estrutura/AcoplamentoMotorRoda.SLDPRT
TCC 1/SolidWorks/Eletrônicos/ESP32/0603 SMD Capacitor.sldprt
Projeto Mecânico/Motor.SLDPRT
TCC 1/SolidWorks/Eletrônicos/ESP32/SOD323F-1.sldprt
TCC 1/SolidWorks/Eletrônicos/ESP32/0402 SMD Capacitor.sldprt
TCC 1/SolidWorks/Eletrônicos/ESP32/QFN28_5X5.sldprt
TCC 1/SolidWorks/Eletrônicos/ESP32/Tact Switch SMD Tab 4mmx3mm.sldprt
TCC 1/SolidWorks/Eletrônicos/ESP32/0603 SMD Resistor.sldprt
TCC 1/SolidWorks/Eletrônicos/ESP32/Pin Solder Joint.sldprt
TCC 1/SolidWorks/Eletrônicos/ESP32/SOT-23.sldprt
