mferreiracosta/tcc_cefet/Projeto Mecânico/CORTE CNC/Placas.pdf

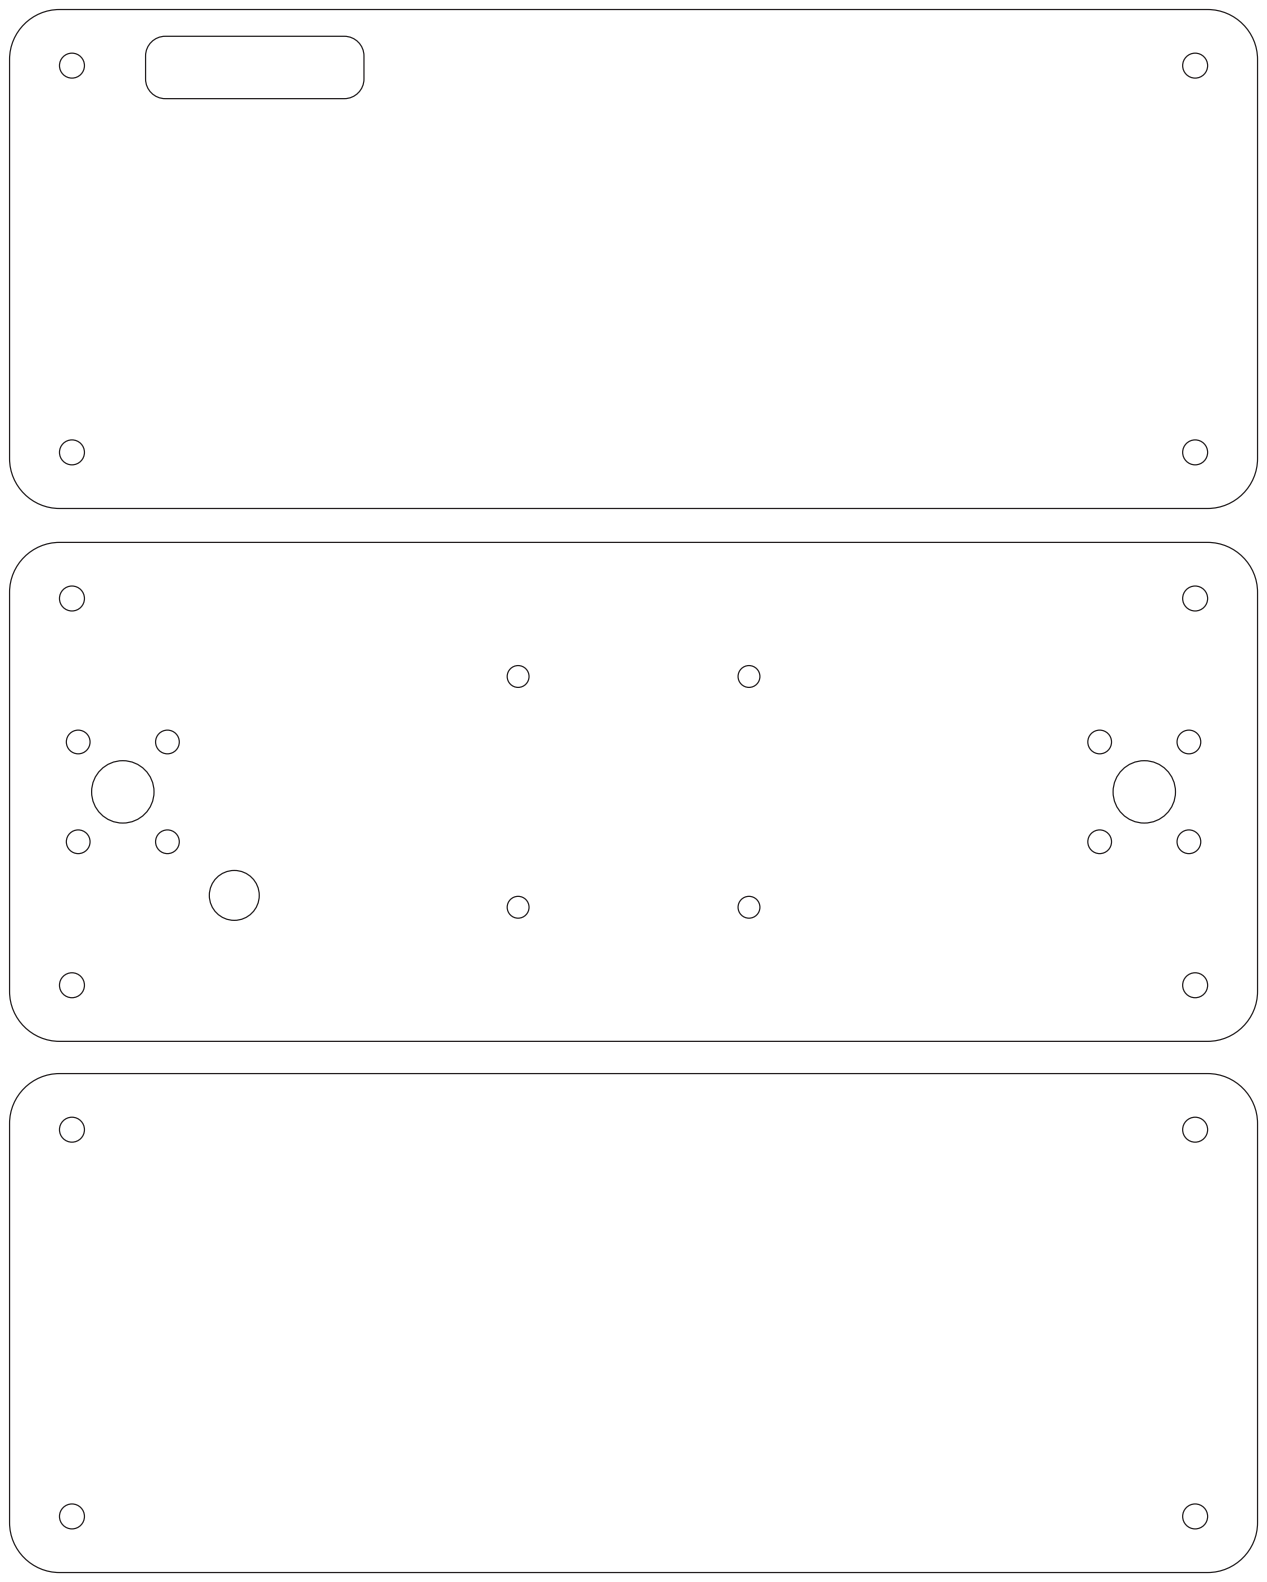
[picture p218: page 1]
