mferreiracosta/tcc_cefet/TCC 1/Referências Bibliográficas/1 - ARTIGOS/LQG/LQG_ControleRobusto_UNB.pdf

## 395480 – Controle Robusto

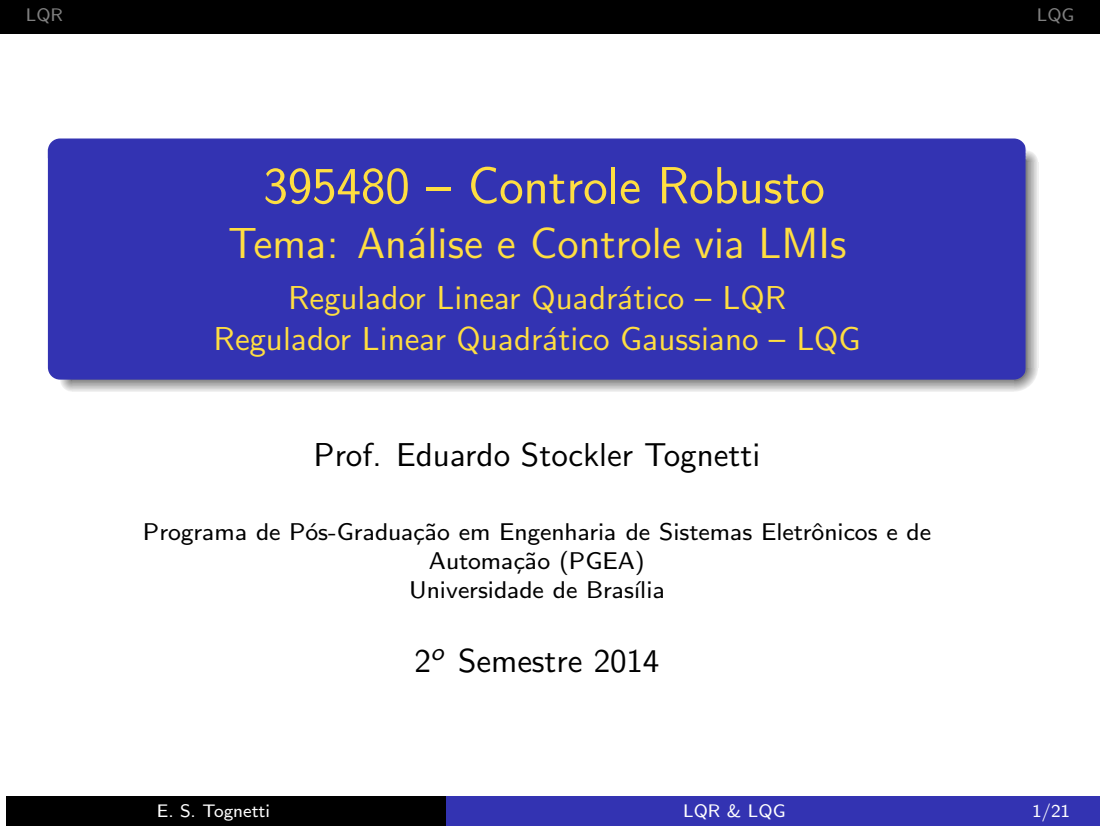
[picture p219: page 1]
LQR; LQG; o Semestre 2014; E. S. Tognetti; LQR & LQG

Tema: Análise e Controle via LMIs

Regulador Linear Quadrático – LQR
Regulador Linear Quadrático Gaussiano – LQG

Prof. Eduardo Stockler Tognetti

Programa de Pós-Graduação em Engenharia de Sistemas Eletrônicos e de

Automação (PGEA)
Universidade de Brasília

## Controle Otimo ´

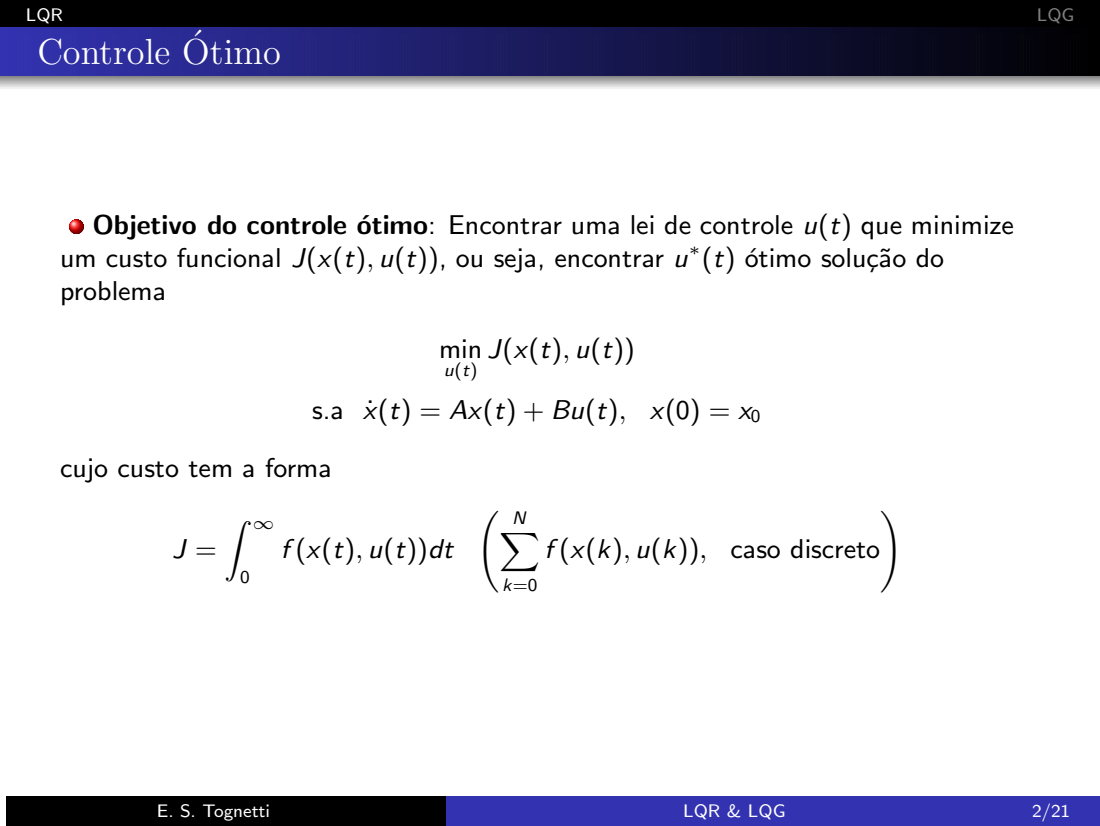
[picture p220: page 2]
min; f (x(k), u(k)), caso discreto!; E. S. Tognetti; LQR & LQG

Objetivo do controle ótimo: Encontrar uma lei de controle u(t) que minimize
um custo funcional J(x(t), u(t)), ou seja, encontrar u
problema

(t) ótimo solução do

cujo custo tem a forma

Regulador | Linear | Quadrático | (LQR)

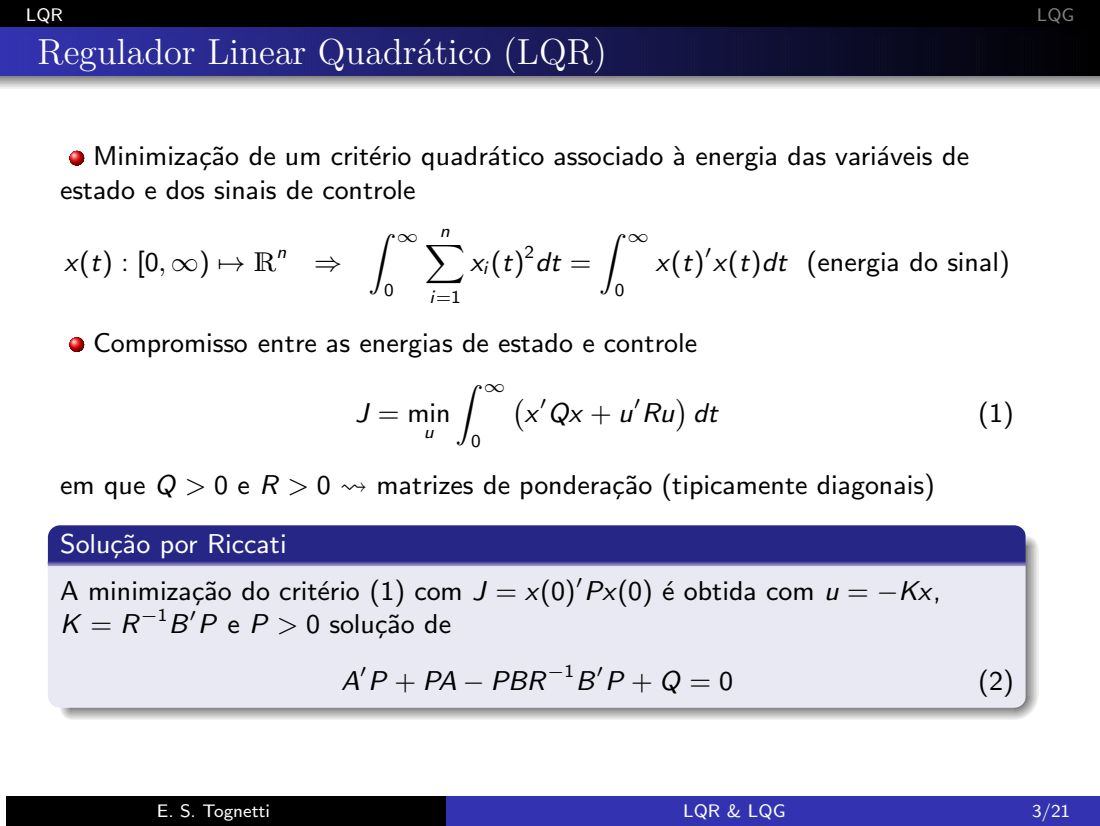
[picture p221: page 3]
J = min; em que Q > 0 e R > 0; matrizes de ponderação (tipicamente diagonais); E. S. Tognetti; LQR & LQG

Minimização de um critério quadrático associado à energia das variáveis de
estado e dos sinais de controle

x(t)dt (energia do sinal)

Compromisso entre as energias de estado e controle

Solução por Riccati
A minimização do critério (1) com J = x(0)′Px(0) é obtida com u = −Kx,

′P e P > 0 solução de

′P + PA − PBR⁻¹B

Regulador | Linear | Quadrático | (LQR)

Demostração: Defina v(x) = x

′Px, P > 0. Para o sistema estável, v(∞) = 0, então

J = min
u

Z ∞

0

x

′
(A

′P + PA − PBR⁻¹B
′P + Q)x + ξ

′
ξ
dt + v(x(0))

em que ξ = R

1/2
u + R

−1/2B
′P.

Tem-se que J = v(x(0)) = x(0)′Px(0) devido a (2) ser satisfeita e que u = −R

−1B
′Px implica ξ = 0.

Observa-se também que (2) é equivalente à

(A − BK)

′P + P(A − BK) + K

′RK + Q = 0

garantido a que o sistema em malha fechada é exponencialmente estável.

E. S. Tognetti | LQR & LQG | 4/21

Reescrevendo | o | problema | LQR | (1)

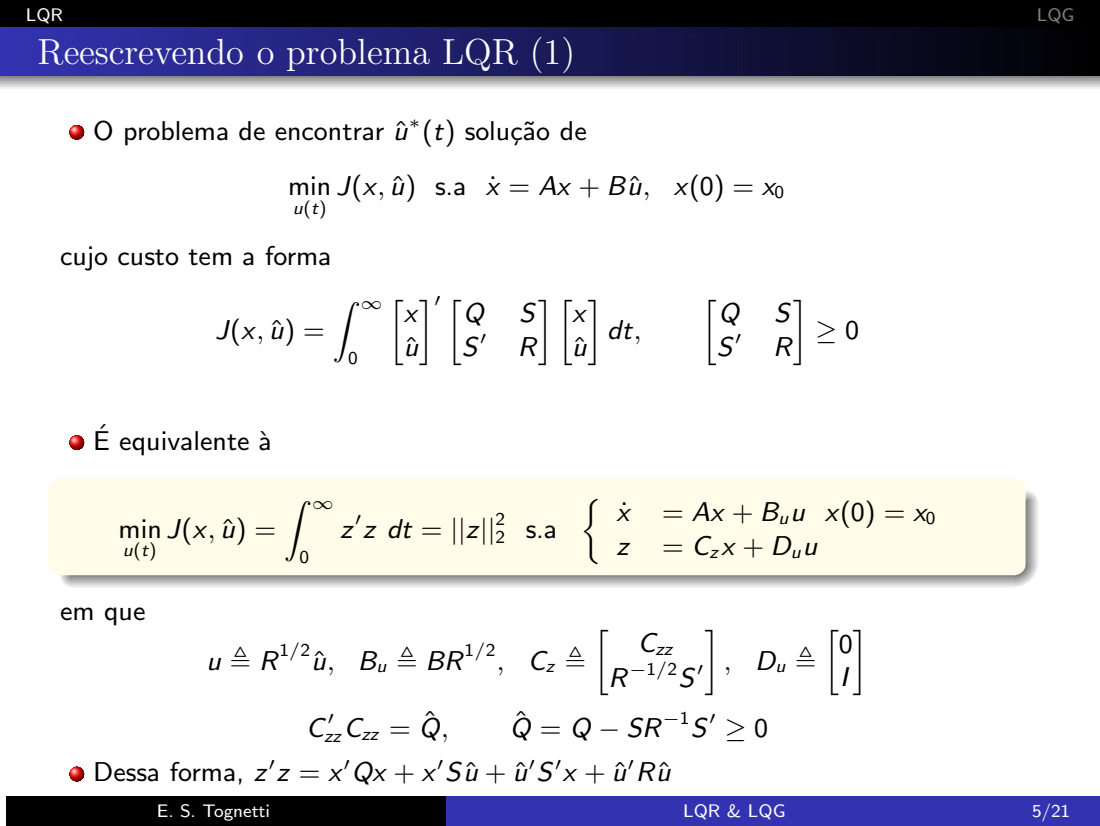
[picture p222: page 5]
min; J(x, û) s.a ẋ = Ax + Bû, x(0) = x0; E equivalente à ´; = Ax + Buu x(0) = x0; = Cz x + Duu; em que; Czz; zzCzz = Qˆ ,; Dessa forma, z; Sû + û; ′Rû; E. S. Tognetti; LQR & LQG

O problema de encontrar û

(t) solução de

cujo custo tem a forma

û, Bu , BR¹/2

Reescrevendo | o | problema | LQR | (2)

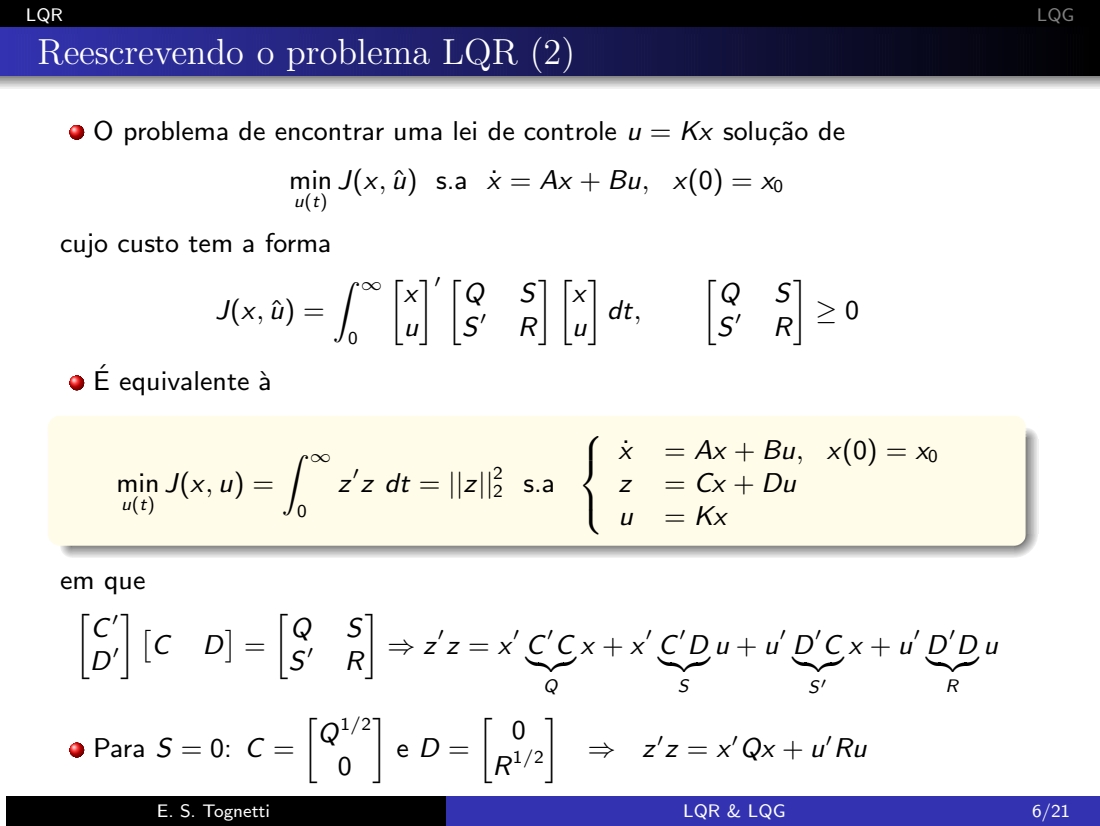
[picture p223: page 6]
min; E equivalente à ´; em que ; Para S = 0: C =; E. S. Tognetti; LQR & LQG

O problema de encontrar uma lei de controle u = Kx solução de

cujo custo tem a forma

Reescrevendo | o | problema | LQR

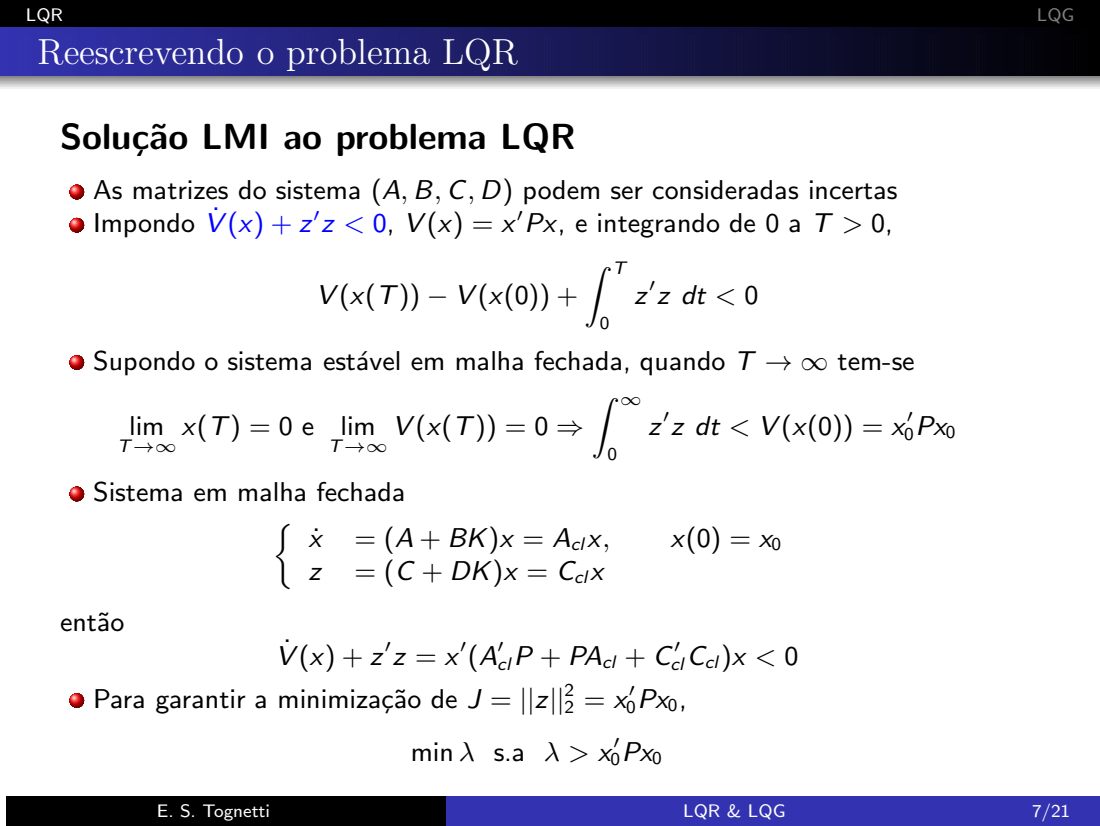
[picture p224: page 7]
lim; x(T) = 0 e lim; = (A + BK)x = Aclx,; = (C + DK)x = Cclx; então; ′ clP + PAcl + C; ′ clCcl)x < 0; min λ s.a λ > x; E. S. Tognetti; LQR & LQG

Solução LMI ao problema LQR

As matrizes do sistema (A, B, C, D) podem ser consideradas incertas
Impondo V˙ (x) + z

′Px, e integrando de 0 a T > 0,

Supondo o sistema estável em malha fechada, quando T → ∞ tem-se

Sistema em malha fechada

Para garantir a minimização de J = ||z||²

Reescrevendo | o | problema | LQR

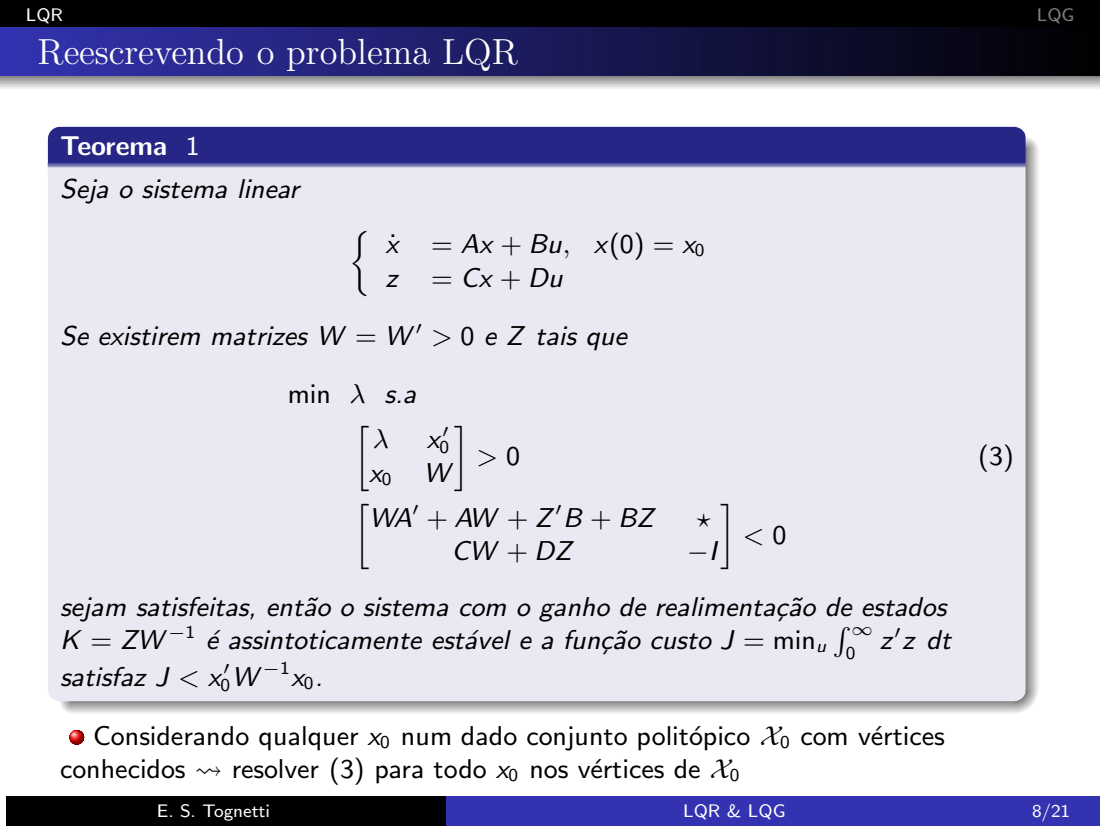
[picture p225: page 8]
min λ s.a ; conhecidos; resolver (3) para todo x0 nos vértices de X0; E. S. Tognetti; LQR & LQG

Teorema 1
Seja o sistema linear

Se existirem matrizes W = W ′ > 0 e Z tais que

sejam satisfeitas, então o sistema com o ganho de realimentação de estados
satisfaz J < x

é assintoticamente estável e a função custo J = minu

Considerando qualquer x0 num dado conjunto politópico X0 com vértices

Reescrevendo | o | problema | LQR

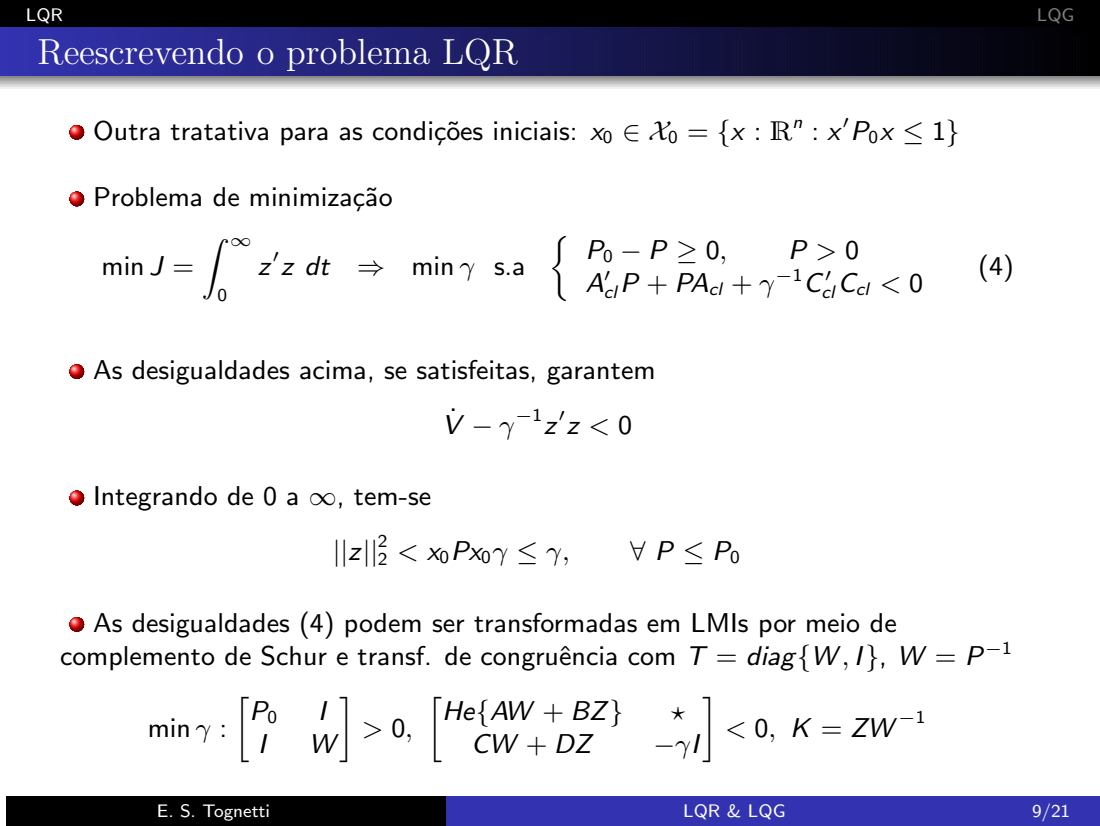
[picture p226: page 9]
min J =; z dt ⇒ min γ s.a ; ′ clP + PAcl + γ; ′ clCcl < 0; min γ :; E. S. Tognetti; LQR & LQG

Outra tratativa para as condições iniciais: x0 ∈ X0 = {x : R

Problema de minimização

As desigualdades acima, se satisfeitas, garantem

Integrando de 0 a ∞, tem-se

As desigualdades (4) podem ser transformadas em LMIs por meio de
complemento de Schur e transf. de congruência com T = diag{W , I}, W = P

Reescrevendo | o | problema | LQR

### Problema LQR como H2

Sistema em malha fechada pode ser reescrito de forma a ter condição inicial nula
x˙ | = (A + BK)x = Aclx
z | = (C + DK)x = Cclx
x(0) = x0

⇒

x˙ | = Acl x + Bw w
z | = Cclx
x(0) = 0

em que Bw = x0 e w = δ(t).

Seja a matriz de transferência Hwz , z = Hwzw, como w = δ(t) então

| | min K ||z||²
2 = min
| | | K ||h||²
2 = Tr(B

′
w PBw )

em que P é solução de
| | A ′
clP + PAcl + C

′
clCcl ≤ 0

O problema é resolvido por meio de condições convexas aplicando as manipulações algébricas vistas no controle de realimentação de estado com custo
H2
E. S. Tognetti | LQR & LQG | 10/21

LQR | para | sistemas | sujeitos | a | ruído | branco

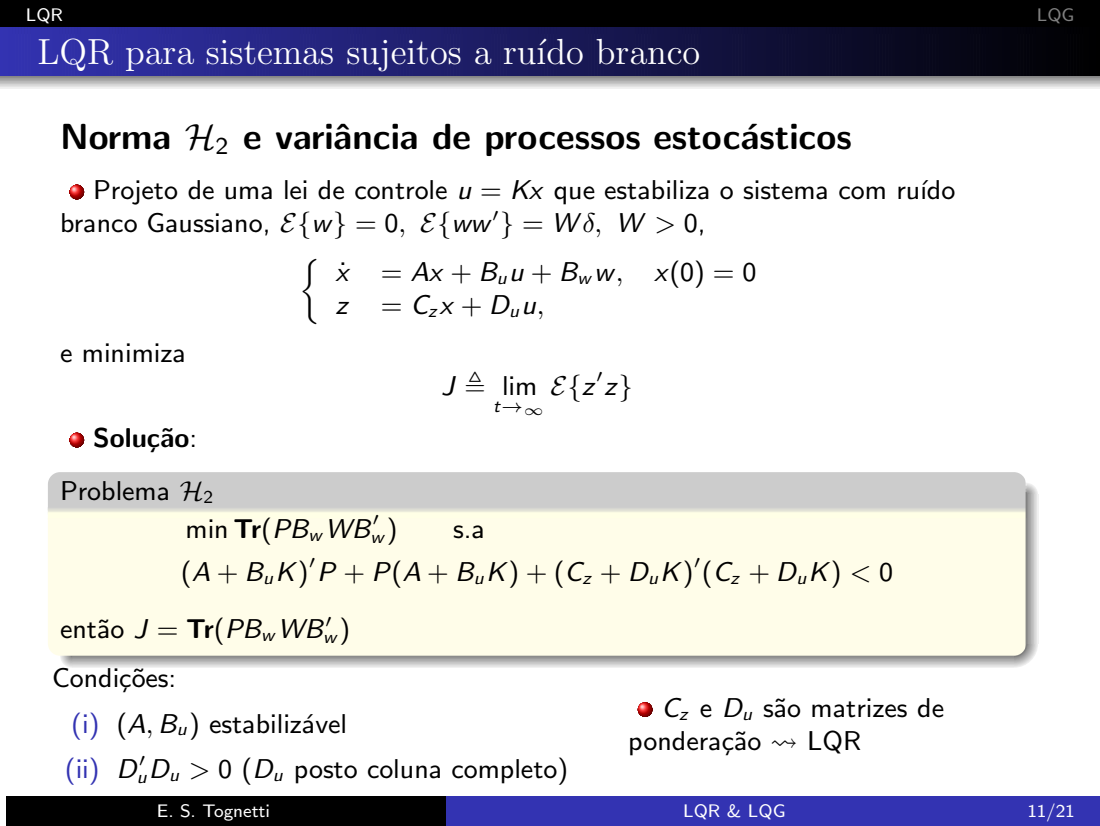
[picture p227: page 11]
= Ax + Buu + Bw w,; = Czx + Duu,; e minimiza; J , lim; Solução:; Problema H2; (Cz + DuK) < 0; ponderação; LQR; E. S. Tognetti; LQR & LQG

Norma H2 e variância de processos estocásticos

Projeto de uma lei de controle u = Kx que estabiliza o sistema com ruído
branco Gaussiano, E{w} = 0, E{ww′

min Tr(PBwWB′
(A + BuK)

′P + P(A + BuK) + (Cz + DuK)

então J = Tr(PBwWB′
Condições:
(i) (A,Bu) estabilizável

Cz e Du são matrizes de

uDu > 0 (Du posto coluna completo)

Problema | LQR | - | formas | alternativas | (1)

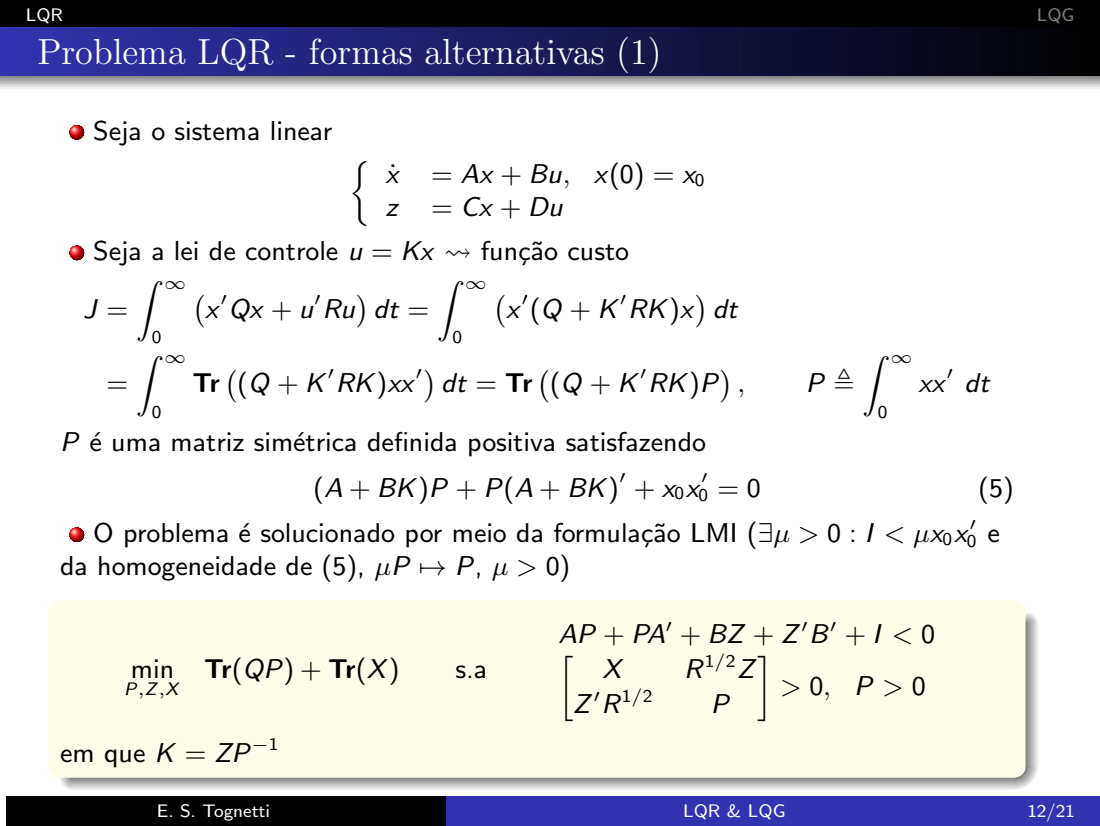
[picture p228: page 12]
Seja o sistema linear; Seja a lei de controle u = Kx; função custo; min; E. S. Tognetti; LQR & LQG

P é uma matriz simétrica definida positiva satisfazendo

O problema é solucionado por meio da formulação LMI (∃µ > 0 : I < µx0x
da homogeneidade de (5), µP 7→ P, µ > 0)

em que K = ZP⁻¹

Problema | LQR | - | formas | alternativas | (2)

Seja a lei de controle u = Kx, o sistema linear e o custo dados abaixo
x˙ | = Ax + Bu, x(0) = x0
z | = Cx + Du | J =

Z ∞

0

x

′Qx + u

′Ru
dt

Considerando o sistema em malha fechada estável (V(x) = x

′Px 7→ 0 quando
t 7→ ∞), tem-se
V˙ (x) + x
′Qx + u

′Ru < 0

| | | R ∞0 | (·)dt

# z}|{ ⇒ J < x

| | | | ′

0Px0 < λmax(P)||x0||²

2 < Tr(P)||x0||²
2 (6)

O lado esquerdo de (6) é garantido se a desigualdade abaixo é satisfeita

W (A + BK)

′ + (A + BK)W + WQW + WK′RKW < 0, W , P

−1 > 0 (7)

(7) pode ser transformada em LMI através da aplicação do complemento de Schur e da transformação Z = KW (opcionalm. R = R

1/2R

1/2
, Q = Q
1/2Q | 1/2 )
A minimização de J é feita através da minimização de seu limitante superior em (6)
min λmax(P) ⇒ max µ s.a W ≥ µI e (7) ou

min Tr(P) ⇒ min Tr(X

−1
), P ≤ X

−1 ⇒ min −logdet(X) s.a W ≥ X e (7)

Obs.: Tr(P) ≤ Tr(X

−1
) ⇔ logdet(P) ≤ logdet(X

−1
) = −logdet(X) = −

Xlog(λi(X))

E. S. Tognetti | LQR & LQG | 13/21

Regulador | Linear | Quadrático | Gaussiano | – | LQG

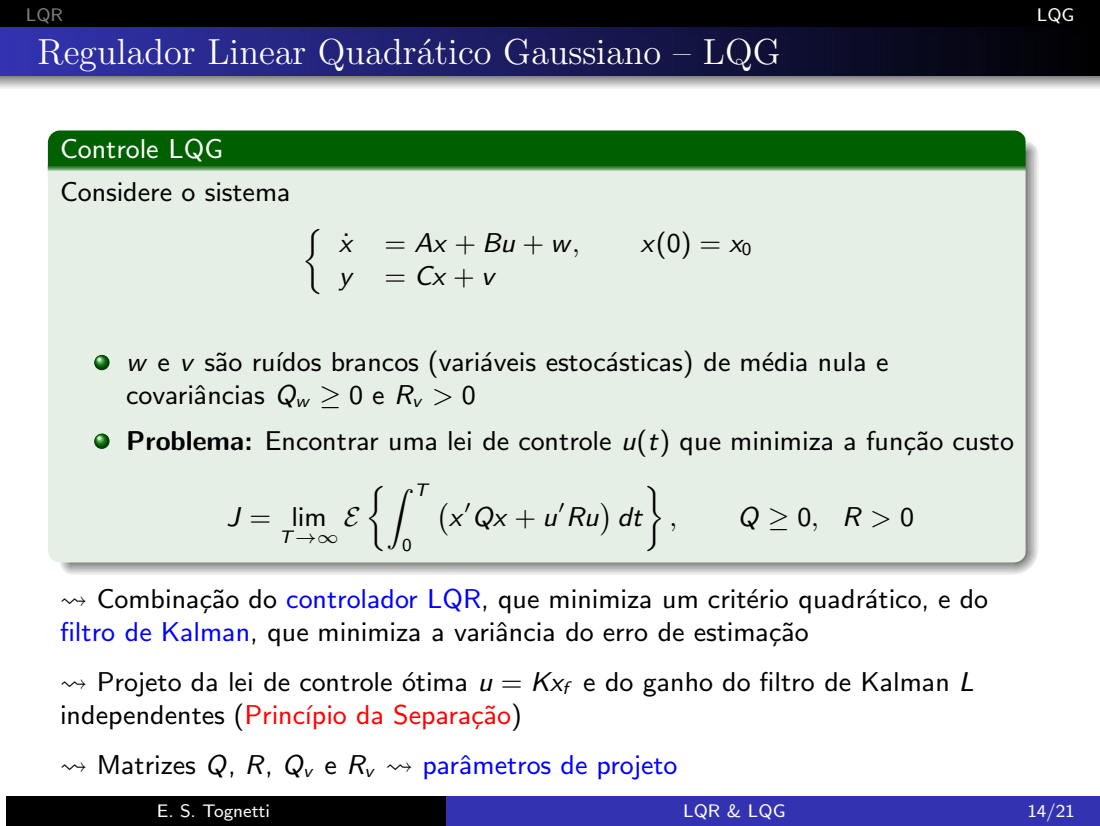
[picture p229: page 14]
Controle LQG; Considere o sistema; J = lim; Matrizes Q, R, Qv e Rv; parâmetros de projeto; E. S. Tognetti; LQR & LQG

w e v são ruídos brancos (variáveis estocásticas) de média nula e
covariâncias Qw ≥ 0 e Rv > 0
Problema: Encontrar uma lei de controle u(t) que minimiza a função custo

Combinação do controlador LQR, que minimiza um critério quadrático, e do
filtro de Kalman, que minimiza a variância do erro de estimação
Projeto da lei de controle ótima u = Kxf e do ganho do filtro de Kalman L
independentes (Princípio da Separação)

Regulador | Linear | Quadrático | Gaussiano | – | LQG

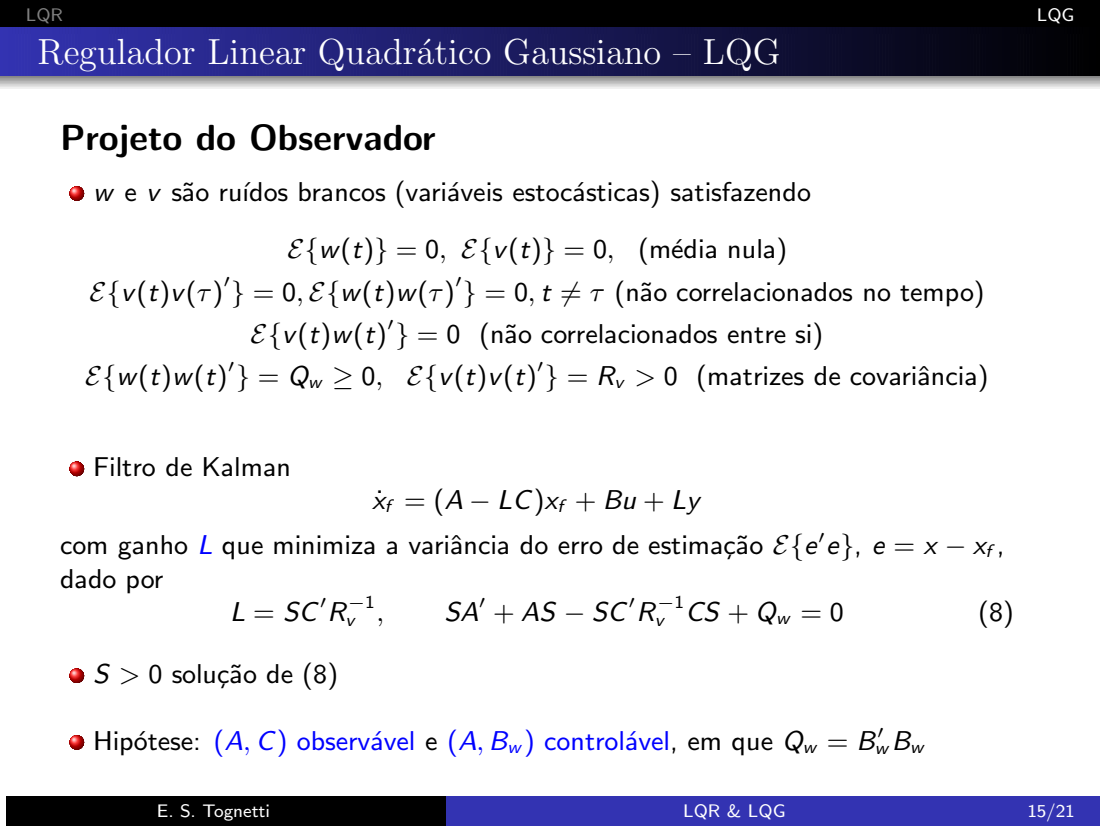
[picture p230: page 15]
E{w(t)} = 0, E{v(t)} = 0, (média nula); E. S. Tognetti; LQR & LQG

Projeto do Observador

w e v são ruídos brancos (variáveis estocásticas) satisfazendo

} = 0,t 6= τ (não correlacionados no tempo)
} = 0 (não correlacionados entre si)

} = Rv > 0 (matrizes de covariância)

Filtro de Kalman

com ganho L que minimiza a variância do erro de estimação E{e
dado por

S > 0 solução de (8)

Hipótese: (A, C) observável e (A,Bw ) controlável, em que Qw = B

Regulador | Linear | Quadrático | Gaussiano | – | LQG

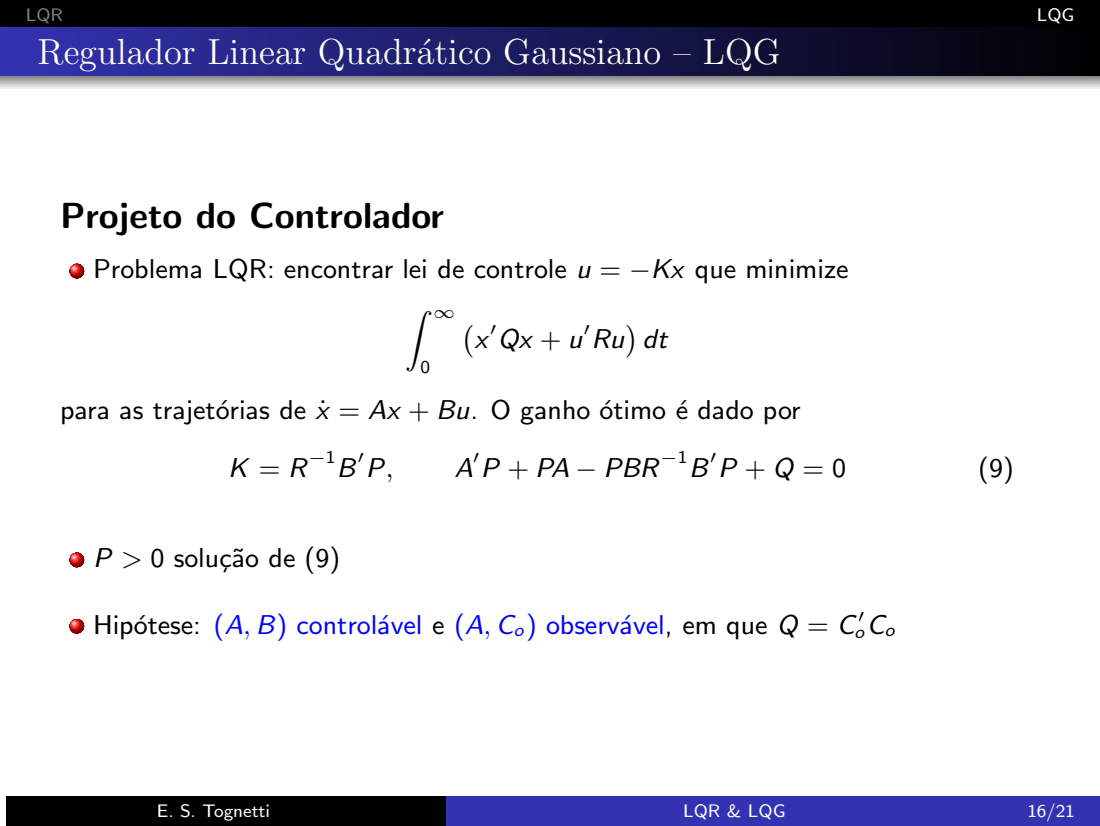
[picture p231: page 16]
′ oCo; E. S. Tognetti; LQR & LQG

Projeto do Controlador

Problema LQR: encontrar lei de controle u = −Kx que minimize

para as trajetórias de ẋ = Ax + Bu. O ganho ótimo é dado por

′P + PA − PBR⁻¹B

P > 0 solução de (9)

Hipótese: (A, B) controlável e (A, Co ) observável, em que Q = C

Regulador | Linear | Quadrático | Gaussiano | – | LQG

### Solução do problema LQG

Lei de controle u = −Kxf que resulta no sistema em malha fechada

x˙ = Ax + Bu + w, | y = Cx + v
xḟ = (A − LC)xf + Bu + Ly, | u = −Kxf

que resulta em
| x˙ e˙
| | =
| | A − BK | BK
| | 0 | A − LC x˙ e˙
+
| | | | | w

w − Lv
(10)

De (10) verifica-se o Princípio da Separação

Se (8) e (9) não se verificam mas os modos não controláveis e não observáveis são estáveis sistema em malha fechada ainda é estável e P ≥ 0 e/ou S ≥ 0

O controle LQR apresenta propriedades de robustez (ex.: para R = rI tem ao menos 60o
de margem de fase e margem de ganho infinita em cada canal). O
Filtro de Kalman e o LQG não apresentam garantias de robustez.
E. S. Tognetti | LQR & LQG | 17/21

Regulador | Linear | Quadrático | Gaussiano | – | LQG

### Problema LQG: sistema em malha fechada

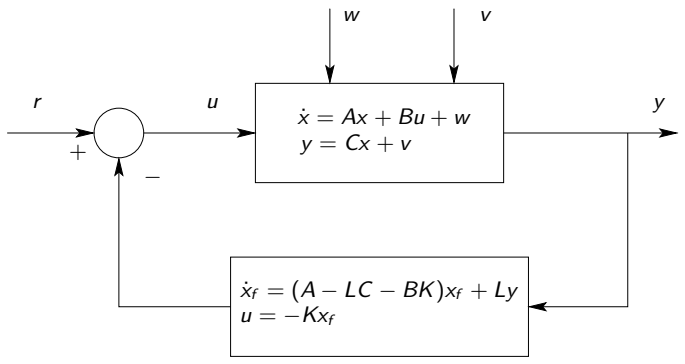
[picture p232: figure]
xḟ = (A − LC − BK)xf + Ly u = −Kxf

Figura: Representação do sistema em malha fechada do controle LQG.

E. S. Tognetti | LQR & LQG | 18/21

Reescrevendo | o | problema | LQG | (1)

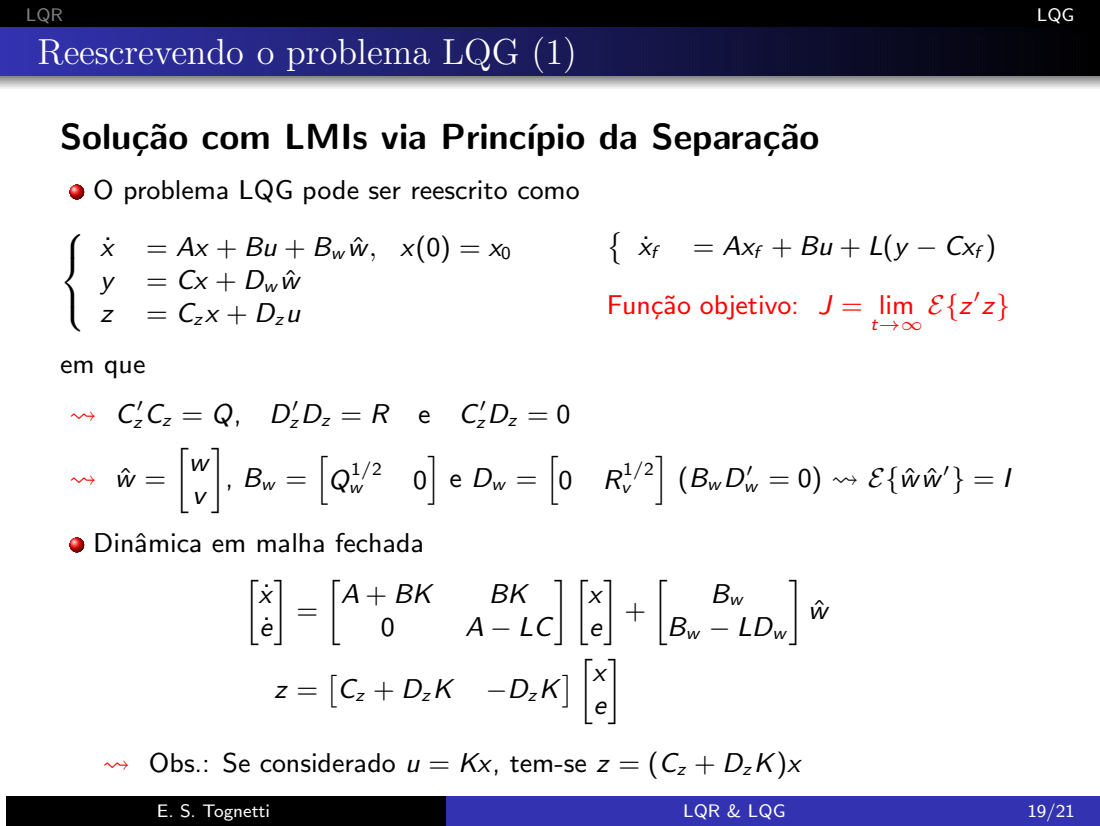
[picture p233: page 19]
Solução com LMIs via Princípio da Separação; = Czx + Dzu; = Axf + Bu + L(y − Cxf); Função objetivo: J = limt→∞; em que; ′ zCz = Q, D; ′ zDz = R e C; ′ zDz = 0; (BwD; Bw Bw − LDw; Cz + DzK; −DzK; E. S. Tognetti; LQR & LQG

O problema LQG pode ser reescrito como

Dinâmica em malha fechada

Obs.: Se considerado u = Kx, tem-se z = (Cz + DzK)x

Reescrevendo | o | problema | LQG | (1)

### Solução com LMIs via Princípio da Separação

Procedimento de Projeto:
1 Projeto do ganho do filtro de Kalman que minimiza E{e

′

e} = ||Hw e ˆ ||²
2, dada
por

Hw e ˆ =

A − LC Bw − LDw
I | 0

2 Projeto do ganho de realimentação de estados que minimiza (LQR)
Z ∞

0

x

′Qx + u

′Ru
dt,

ou seja, minimiza a norma H2 da função de transferência do sistema em malha fechada considerando a lei de realimentação de estados u = Kx, ||Hw z ˆ ||²
2

, dada por

Hw z ˆ =

A + BK | Bw
Cz + DzK | 0

E. S. Tognetti | LQR & LQG | 20/21

Reescrvendo | o | problema | LQG | (2)

### Solução com LMIs via controlador dinâmico de saída

O problema LQG pode ser reescrito como
x˙ | = Ax + Bu + Bw w, x(0) = 0
y | | = Cx + Dw w
z | | = Czx + Dzu

J = limt→∞

E{z

′
z}

em que w é um ruído branco Gaussiano de média zero e covariância W > 0

A solução do problema é dada pelo controlador dinâmico de saída
xċ | = Acxc + Bcy, xc (0) = 0
u | = Ccxc + Dcy

Resolver J = limt→∞

| | E{z ′
z} em termos do Gramiano de controlabilidade

J ≤ Tr(CW˜ C˜ ′
)
| | W > 0 : | AW˜ | + W Ã′ + B˜wW B˜ ′
w < 0

Ã, B˜ , C˜ e D˜ (D˜ = 0) matrizes do sistema aumentado em malha fechada Projeto via técnicas de realimentação dinâmica de saída com custo H2
Permite tratar o caso em que as matrizes do sistema são incertas
E. S. Tognetti | LQR & LQG | 21/21
