mferreiracosta/tcc_cefet/(list of files, drawings)

Other design files:
Circuito Eletrônico/circuito-eletronico-tcc.fzz
