mferreiracosta/tcc_cefet/Códigos/Filtro Complementar/PenduloInvertido_TCC_ert_rtw/MW_target_hardware_resources.h

#ifndef PORTABLE_WORDSIZES
#ifdef __MW_TARGET_USE_HARDWARE_RESOURCES_H__
#ifndef __MW_TARGET_HARDWARE_RESOURCES_H__
#define __MW_TARGET_HARDWARE_RESOURCES_H__

#define MW_MULTI_TASKING_MODE 1
#include "arduinoAVRScheduler.h"

#define MW_USECODERTARGET 1
#define MW_TARGETHARDWARE Arduino Nano 3.0
#define MW_CONNECTIONINFO_SERIAL_IPADDRESS codertarget.arduinobase.registry.getLoopbackIP;
#define MW_CONNECTIONINFO_SERIAL_PORT 17725
#define MW_CONNECTIONINFO_SERIAL_VERBOSE 0
#define MW_CONNECTIONINFO_XCPONSERIAL_BAUDRATE codertarget.arduinobase.registry.getBaudRate
#define MW_CONNECTIONINFO_XCPONSERIAL_COMPORT codertarget.arduinobase.internal.getExternalModeMexArgs('Serial')
#define MW_CONNECTIONINFO_XCPONSERIAL_VERBOSE 0
#define MW_EXTMODE_CONFIGURATION Serial
#define MW_EXTMODE_COMPORTBAUD 115200
#define MW_EXTMODE_SIGNALBUFFERSIZE 250.000000
#define MW_RTOS Baremetal
#define MW_SCHEDULER_INTERRUPT_SOURCE 0
#define MW_RUNTIME_BUILDACTION 1
#define MW_RUNTIME_DISABLEPARALLELBUILD 0
#define MW_RUNTIME_FORCEBUILDSTATICLIBRARY 0
#define MW_HOSTCOMPORT_SET_HOST_COM_PORT 1
#define MW_HOSTCOMPORT_COM_PORT_NUMBER 6
#define MW_SIMULINKIO_ENABLE_SIMULINKIO 1
#define MW_OVERRUNDETECTION_ENABLE_OVERRUN_DETECTION 0
#define MW_OVERRUNDETECTION_DIGITAL_OUTPUT_TO_SET_ON_OVERRUN 13
#define MW_ANALOGINREFVOLTAGE_ANALOG_INPUT_REFERENCE_VOLTAGE 0.000000
#define MW_SERIAL_SERIAL0_BAUD_RATE 3
#define MW_I2C_I2C0BUSSPEEDHZ 100000
#define MW_SPI_SPI_CLOCK_OUT_FREQUENCY 2
#define MW_SPI_SPI_MODE 0
#define MW_SPI_SPI_BITORDER 0
#define MW_DATAVERSION 2016.02

#endif /* __MW_TARGET_HARDWARE_RESOURCES_H__ */

#endif

#endif
