mferreiracosta/tcc_cefet/(commit log)

2022-06-19 Adicionei os arquivos do tcc
    Subindo todos arquivos referente ao tcc para o github. Nessa leva, temos o projeto mecânico em SolidWorks, códigos em Matlab e Arduino, arquivos das referências bibliográficas, dentre outros.
    [AcoplamentoMotorRoda.SLDPRT, BATERIA.SLDPRT, CONJ ELETRONICOS.SLDPRT, ESP32.SLDPRT, HASTE.SLDPRT, HASTE_INFERIOR.SLDPRT, HASTE_SUPERIOR.SLDPRT, L298N.SLDPRT]
2022-06-19 Adição arquivo latex, circuito e filtro
    Aqui adicionou-se todo arquivo latex da monografia que ainda está sendo escrita, o circuito realizado no fritizing e um filtro complementar desenhado no Matlab.
    [circuito-eletronico-tcc.fzz]
2022-06-19 Removi os arquivos de escrita latex
    Decidi por remover os arquivos editáveis do TCC escrito no Latex
2022-06-19 Modifiquei a pasta do Matlab
    Deletei alguns arquivos não essenciais que estavam dentro da pasta de códigos do Matlab
2022-06-20 Versão final da monografia
    Atualização do texto da monografia para a versão final a ser entregue.
2022-06-20 Update do circuito eletrônico
    Atualização no circuito eletrônico. Alterei as conexões com a Ponte H e Arduino.
    [circuito-eletronico-tcc.fzz]
2022-06-20 Update no código Matlab
    Foi alterado o tempo de acomodação da planta.
2022-06-20 Update nos códigos Arduino
    Atualização dos códigos Arduino para implementação do controlador na planta.
2022-06-20 Update em valida_motor
    Atualização do código que valida o sentido de giro dos motores.
2022-06-20 Update no arquivo de grava_dados
    Atualização no código do processing que salva os dados da serial quando aplicado o controlador na planta.
2022-06-22 Adicionei arquivos do TCC 1
    [0402 SMD Capacitor.sldprt, 0402 SMD Resistor___ _________.sldprt, 0603 SMD Capacitor.sldprt, 0603 SMD Resistor.sldprt, 0805 SMD Capacitor.sldprt, AcoplamentoMotorRoda.SLDPRT, BATERIA.SLDPRT, Base.SLDPRT]
